leo-lizx/transport-truck/docs/hardware/吸盘模式4实物丝印接线标注.png

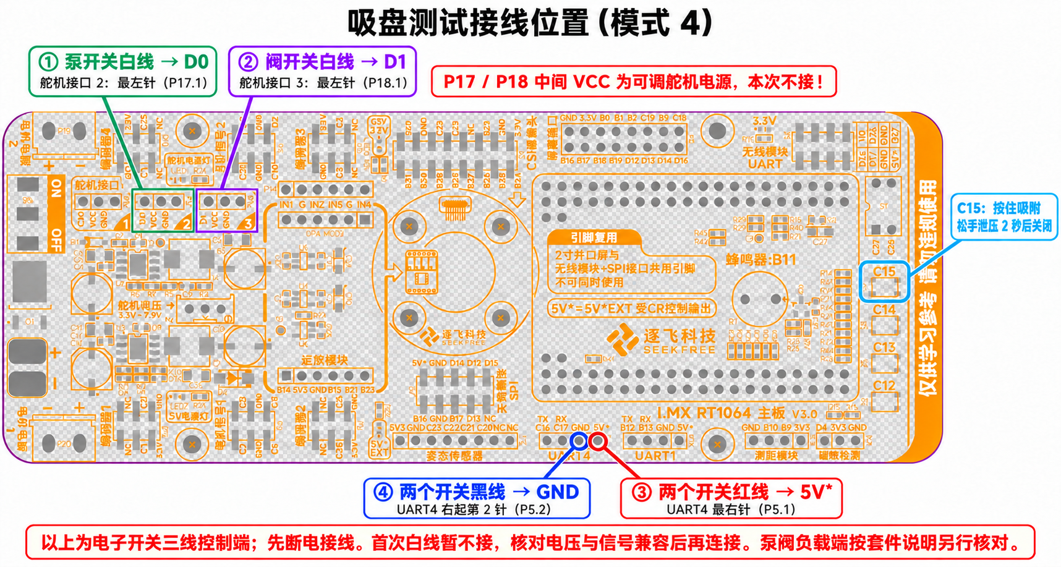
docs/hardware/吸盘模式4实物丝印接线标注.png
