leo-lizx/transport-truck/docs/PINOUT.md

# RT1064 V3.0 主板接口与引脚占用

> 更新：2026-10-17。适用工程：`transport-truck`，当前入口保留模式 1／2／3，新增并默认模式 4 吸盘测试。
>
> 用户确认实物为主板 V3.0；当前底盘的接线、参数和程序保持不变。
>
> 本文是资料与源码核对结果，未进行实物电压、接线或新增外设测试。

[查看彩色接口标注图（PDF）](hardware/RT1064_V3.0接口标注.pdf)

## 1. 标注依据与状态定义

| 来源 | 版本／位置 | 用途 |
| --- | --- | --- |
| H1：[V3.0 主板硬件说明](<../【文档】说明书 芯片手册等/主板文档/RT1064 V3.0主板硬件说明 V1.0.pdf>) | V1.0，2023-02-28；下文使用 PDF 页码，印刷页码通常少 1 | 主板接口、插接与电源说明 |
| H2：V3.0.1.2 原理图 | `E:\car\RT1064_Library-master\封装 文档 原理图.zip` 内 `【原理图】原理图 丝印图 尺寸图 位号图/主板/V3.0/RT1064主板V3.0.1.2 原理图.pdf`；2024-03-25，共 6 页 | 第 3 页引脚表、第 4 页连接器、第 5 页电源、第 6 页按键／拨码／蜂鸣器 |
| S1：[pinMap.h](../project/code/config/pinMap.h)、[configChassis.h](../project/code/config/configChassis.h) | 当前工程文件 | 电机、编码器和底盘参数 |
| S2：[main.c](../project/user/src/main.c)、[isr.c](../project/user/src/isr.c) | 当前初始化与中断路由 | 区分已经启用、仅保留宏和已有中断处理 |
| S3：当前工程 `libraries/zf_driver/`、`libraries/zf_device/`、`libraries/zf_common/` | GPIO／PWM／UART／IIC／SPI／ADC 枚举及 IMU、Debug 默认映射 | 核对复用资源与隐含占用 |

本文使用 V3.0 系列原理图；当前工程资料目录也已包含 V3.0，不以 V3.1 替代。用户确认实物丝印仅为 V3.0，不能由此确定是否恰为 V3.0.1.2 小修订；涉及供电范围时见第 7 节。

| 状态 | 本文含义 |
| --- | --- |
| 底盘占用／保留 | 当前四个模式都会初始化，禁止为新增外设改动；模式 4 保持 STOP |
| 模式 4 占用 | 仅吸盘独立测试初始化 D0／D1／C15，不再列为空闲候选 |
| 候选可用 | 当前软件未初始化，且未直接占用底盘引脚；仍须核对实物是否已接设备，以及电气／资源兼容性 |
| 条件复用 | 与其他接口共享引脚或外设，不能把每行都视为可同时使用 |
| 不可新增占用 | 与受保护底盘或存储器资源冲突 |
| 待确认 | 尚无足够资料决定器件接法、供电或控制参数 |

`pinMap.h` 是应用引脚映射入口，但不能单独代表全部硬件占用；还要核对实际初始化、SDK 默认引脚与主板原理图。

## 2. 底盘已占用：保持不变

即使选择单轮 PID 模式，`chassis_ctrl_init()` 也会初始化全部四轮、四路编码器和 IMU。以下共 **20 个信号引脚**，不包括核心板存储器、启动、SWD 和电源等板级占用。

| 功能 | 当前接线 | 外设资源／主板接口 |
| --- | --- | --- |
| 左前轮 LF | PWM C11；DIR C10 | PWM2 子模块 2 B；P9 |
| 右前轮 RF | PWM D3；DIR D2 | PWM2 子模块 3 B；P9 |
| 左后轮 LB | PWM C6；DIR C7 | PWM2 子模块 0 A；P8 |
| 右后轮 RB | PWM C8；DIR C9 | PWM2 子模块 1 A；P8 |
| LF 编码器 | A=C5；B=C25 | QTIMER2_ENCODER2；编码器 4／P10 |
| RF 编码器 | A=C3；B=C4 | QTIMER2_ENCODER1；编码器 3／P11 |
| LB 编码器 | A=C0；B=C1 | QTIMER1_ENCODER1；编码器 1／P13 |
| RB 编码器 | A=C2；B=C24 | QTIMER1_ENCODER2；编码器 2／P12 |
| IMU660RB | SCK C23；MOSI C22；MISO C21；CS C20 | SPI4；姿态传感接口 P3 |

四路电机 PWM 当前为 **17 kHz**。PIT_CH0 为 5 ms 姿态与主循环节拍，PIT_CH1 为 20 ms 底盘闭环；RTWDOG 保留。它们不属于本次新增外设的资源池。

供接线复核的 H2 第 4 页针号：

| 连接器 | 针号 → 网络 |
| --- | --- |
| P8 电机信号 1 | 1=C8；2=C6；3、4=GND；5=C9；6=C7 |
| P9 电机信号 2 | 1=D2；2=C10；3、4=GND；5=D3；6=C11 |
| P13 编码器 1 | 1=GND；2=3V3；3=C0；4=C1；5、6=NC |
| P12 编码器 2 | 1=GND；2=3V3；3=C2；4=C24；5、6=NC |
| P11 编码器 3 | 1=GND；2=3V3；3=C3；4=C4；5、6=NC |
| P10 编码器 4 | 1=GND；2=3V3；3=C5；4=C25；5、6=NC |
| P3 姿态模块 | 1=3V3；2=GND；3=C23；4=C22；5=C21；6=C20；7、8=NC |

这些是原理图针号，不能把绘图中的左右方向直接当成实物插头方向，也不据此调整现有已经使用的底盘线序。

### 2.1 模式 4 新增占用

| 功能 | 信号／针脚 | 边界 |
| --- | --- | --- |
| 泵电子开关 | D0／P17.1，PWM1 子模块 3 A | 与 D1 同频，统一初始化 |
| 阀电子开关 | D1／P18.1，PWM1 子模块 3 B | 同频但可独立发送开关命令 |
| 按住吸附／松手释放 | C15，板载 K1 | 输入上拉，低有效；上电先稳定松手解锁 |
| 电子开关红／黑线 | P5.1=5V_EXT／P5.2=GND | 先测电压及核对负载能力；P5.3／4 的 UART 信号未启用 |

**P17.2／P18.2 为可调舵机电源，不接本次开关红线。** 详细供电边界、信号兼容性和测试次序见 [吸盘模式 4 接线与测试](吸盘模式4接线与测试.md)。模式 4 不改上述 20 个底盘信号及原有 PIT 节拍。

## 3. 主板接口：当前可选范围

下表区分模式 4 已用与尚未初始化的接口。绿色候选接口之间仍可能复用同一组引脚；设备未插接情况须由实物核对。

| 主板接口 | 连接器／信号 | 当前状态与使用边界 |
| --- | --- | --- |
| 舵机 1 | P16：C30 | 模式 5/6 使用；PWM4 子模块 2 A，50Hz，官方公式 0.5–2.5ms（与 FS5323M 500–2500µs 量程一致） |
| 舵机 2 | P17：D0 | 模式 4 用于泵开关；PWM1 子模块 3 A，与 D1 同频；本测试不能同时改作 UART4 TX |
| 舵机 3 | P18：D1 | 模式 4 用于阀开关；PWM1 子模块 3 B，与 D0 同频；本测试不能同时改作 UART4 RX |
| UART4 | P5：TX=C16，RX=C17 | 信号尚未初始化，可作候选；模式 4 仅使用 P5 的电源／地针；保留旧地图 ISR，启用新协议前须处理旧路由 |
| UART1 | P15：TX=B12，RX=B13 | 候选可用；保留旧分类接收 ISR；与 IIC4 复用 |
| 串口无线模块 | P1：TX=D16，RX=D17，RTS=D26，CMD=D27 | 候选可用；当前 Debug UART8 关闭；D16／D17 也可作 PWM1 子模块 2 |
| SPI 无线模块 | P7：SCK=D12，CS=D13，MOSI=D14，MISO=D15，RST=B16，INT=B17 | 候选可用；与 PWM1 子模块 0／1、IIC1／3 及屏幕并口等复用 |
| CSI 摄像头 | P2：PCLK=B20，VSY=B22，D0–D7=B31→B24，配置 TX=C28／RX=C29 | 候选可用；主控直接采图时需同时预留数据与配置引脚，不能只接两根 UART 线 |
| 运放／模拟采集 | OPA_MOD1 输出接 B14／B15／B21／B23 | 候选可用；对应 ADC；只有安装并适配模拟前端后才能按功能使用 |
| 超声波 | P4：Trig=B9，Echo=B10 | 条件可用；B9 不能作为独立低频 PWM，B10 与 PWM1 子模块 3 A 复用 |
| 磁铁检测 | P21：D4 | 候选可用；主板有上拉及串联电阻，不是完全悬空的裸 GPIO |
| 屏幕 | P6：SPI 使用 B0／B1／B2／B3／C18／C19 | 条件可用；旧菜单已删除，未初始化；不能把其中 PWM2 复用脚改成低频控制 |
| 屏幕 8 位并口扩展 | P6：B16–B19、D12–D15 | 条件可用；与 SPI 无线、PWM、IIC、ADC 等复用，不与前述功能同时独立使用 |
| 按键 K1–K4 | C15／C14／C13／C12 | C15 在模式 4 控制吸盘；C14／C13／C12 未初始化。均已连接按键，不是无连接 GPIO |
| 拨码开关 | C27／C26 | 硬件已连接开关，当前未初始化 |
| 蜂鸣器 | B11 | 硬件已连接驱动电路，当前未初始化；不当作自由 PWM 输出 |

### 3.1 常用候选接头的针号

依据 H2 第 4 页；电源针与信号针要分开理解。

| 接头 | 1 脚 | 2 脚 | 3 脚 | 4 脚 |
| --- | --- | --- | --- | --- |
| P16 舵机 1 | C30 信号 | VCC_Servo | GND | — |
| P17 舵机 2 | D0 信号 | VCC_Servo | GND | — |
| P18 舵机 3 | D1 信号 | VCC_Servo | GND | — |
| P5 UART4 | VCC_5V_EXT | GND | C17／MCU RX | C16／MCU TX |
| P15 UART1 | VCC_5V_EXT | GND | B13／MCU RX | B12／MCU TX |
| P4 超声波 | 3V3 | B9／Trig | B10／Echo | GND |
| P21 磁铁检测 | D4 | 3V3 | GND | — |

三个舵机口共用 `VCC_Servo` 电源，各信号串联 100 Ω 电阻。调节该电源会同时影响三个接口，不是每口单独调压。UART 的 5 V 电源针不表示 TX／RX 信号可接 5 V；外设 TX 接 MCU RX，外设 RX 接 MCU TX。

## 4. PWM 资源约束

依据当前 `zf_driver_pwm.h` 第 45–47 行及 `pwm_init()` 实现：同一子模块 A／B 只能同频；同一通道的多个引脚是复用选项，并非多个独立输出。初始化共享子模块还可能重设已有输出，不能只看引脚名不同。

| PWM 资源 | 当前／候选引脚 | 结论 |
| --- | --- | --- |
| PWM2 子模块 0–3 | 底盘四路 PWM | 全部保留；不得用于新增低频控制 |
| PWM2 子模块 3 A | B0／C18／D2／B9 | D2 已作 RF 方向；其余脚即使未初始化，也不能视为独立低频 PWM |
| PWM2 子模块 3 B | B1／C19／D3 | 与 RF 电机 D3 是同一 PWM 通道，禁止重新分配 |
| PWM1 子模块 0 | A=D12；B=D13 | 软件候选；与 SPI1／IIC3 复用，两路同频 |
| PWM1 子模块 1 | A=D14；B=D15 | 软件候选；与 SPI1 复用，两路同频 |
| PWM1 子模块 2 | A=D16；B=D17 | 软件候选；与 UART8 复用，两路同频 |
| PWM1 子模块 3 | A=B10／C16／D0；B=B11／C17／D1 | 模式 4 使用 D0／D1，名义 50Hz；不能另从别名引脚分配独立 PWM；B11 已接蜂鸣器电路 |
| PWM4 子模块 0／1 | B24／B25 | 软件候选；占用时会影响 CSI 摄像头数据引脚 |
| PWM4 子模块 2 | C30 | 对应主板舵机 1，独立于电机 PWM2 |
| PWM4 子模块 3 | C31 | SDK 候选，主板三个标准舵机口没有此脚；需另核对可接出的物理位置 |
| PWM3 | SDK 注明被 SDRAM 占用 | 不列入新增资源池 |

因此“三个舵机插座”不代表三个独立 PWM 频率域：C30 独立，D0 与 D1 共用一个频率域。UART4 使用 C16／C17、PWM 使用 D0／D1 时，属于不同引脚和不同外设，可作为并行候选；不能把 C16 与 D0 或 C17 与 D1 当成独立 PWM 通道，也不能让同一个引脚同时承担 UART 和 PWM。

泵阀开关模式 4 采用名义 50Hz、关约 544μs／开约 2400μs，还原吸盘 PDF 的 Arduino `Servo.write(0/180)` 默认示例；它们是初始测试参数，尚未实测开关门限。BDS300 仍未分配控制参数，不沿用该开关波形。

## 5. 其他软件复用候选

以下表示当前 SDK 支持的候选，不保证主板有同名专用插座，也不意味着可同时使用。

| 外设 | 引脚候选 | 约束 |
| --- | --- | --- |
| UART2 | TX B18／RX B19 | 与 ADC／屏幕并口复用 |
| UART3 | TX B22／RX B23 | 与 CSI／运放 ADC／IIC3 复用；另一组选项 C8／C9 已属底盘，排除 |
| UART4 另一组 | TX D0／RX D1 | 模式 4 已用于泵阀 PWM，不能同时启用该组选项；不构成第二个独立 UART4 |
| UART5 | TX C28／RX C29 | CSI 摄像头配置口；复用前须核对视觉方案和已有回调 |
| UART6 | TX B2／RX B3 | 与屏幕 SPI3 复用 |
| UART8 另一组 | TX B26／RX B27 | 与 CSI 数据等复用，不构成第二个独立 UART8 |
| IIC1 | SCL B16 或 D4；SDA B17 | 与 SPI 无线 RST／INT、磁铁接口等复用 |
| IIC3 | SCL B23 或 D12；SDA B22 或 D13 | 与 UART3、CSI、ADC、SPI1、PWM1 复用 |
| IIC4 | SCL B12；SDA B13 | 与 UART1 共用引脚 |
| SPI1 | SCK D12，MOSI D14，MISO D15，CS 可选 D13／D26／D27 | 与 PWM1、串口无线控制脚等复用 |
| SPI3 | SCK B0 或 B31；MOSI B1 或 B30；MISO B2 或 B29；CS B3 或 B28 | 与屏幕、UART6、CSI 等复用；作为 SPI 用不等于占用 PWM2，但不可同时复用 |
| ADC | ADC1 提供 B12–B27；ADC2 提供 B16–B31 的枚举通道 | 每脚仍须核对板上连接及输入电压；板载运放输出只对应第 3 节四路 |

IIC2 的 C4／C5 与编码器冲突；FLEXIO 摄像头推荐接法大量占用 C5–C15，与底盘冲突，排除这两类新增占用。SPI4 已用于 IMU，不作为独立空闲总线；另选 C3／C2／C1 也撞编码器。若将来要共享现有 SPI4，须另行审核片选、时序、频率和驱动访问，本次不更改。UART7 在当前 SDK 没有可用引脚枚举。

### 5.1 GPIO 名称与已有硬件连接

当前 `zf_driver_gpio.h` 提供的丝印名称范围是：

- B0–B3、B9–B31；
- C0–C31；
- D0–D4、D12–D17、D26–D27。

这些只是支持范围，须先扣除底盘及所选外设，再核对板载电路。旧表中的 A0–A29、B4–B8、D5–D11 不能作为本 SDK 的现成空闲引脚。

C4–C15 涉及启动配置脚，库资料有上电时序提醒；现有底盘保持不变，不为新增接口擅自烧 Fuse 或修改启动配置。SWD、存储器及其他未列出的核心板专用信号不作为普通空闲接口。

## 6. 当前串口中断路由

“当前没有初始化”不等于“打开接收中断即可用于新协议”。

| 串口 | 当前 `isr.c` 情况 | 后续接入要求 |
| --- | --- | --- |
| UART1 | 字节送入旧分类协议 `app_link_isr_feed_class_byte()` | 新协议任务中明确接收归属，不能直接沿用旧解析 |
| UART4 | 字节送入旧地图协议 `app_link_isr_feed_map_byte()` | 同上；旧 `pinMap.h` 宏保留不等于当前正在启用 |
| UART5 | 调用摄像头接收回调 | 按所选摄像头或新协议核对回调 |
| UART2／3／6 | RX 分支未实现读取字节 | 不直接打开 RX 中断，须在对应任务实现接收 |
| UART8 | 当前应用无自定义接收入口；Debug 关闭 | 复用或恢复 Debug 时核对中断与引脚 |

本次不改这些 ISR，也不删除 `app_link`；底盘仍使用其地图快照接口。

## 7. 供电标注与版本差异

| 项目 | H1：2023 年 V3.0 手册 | H2：V3.0.1.2 原理图 | 当前处理 |
| --- | --- | --- | --- |
| 电池输入范围 | 6–12 V（PDF 第 4／7 页） | 框图标 7–14 V（第 2 页） | 不拼接成 6–14 V；核对实物小版本与额定条件 |
| 舵机电源可调范围 | 最低 3.3 V、最高同电池电压（PDF 第 11 页） | 3.3–7.9 V（第 2／5 页） | 实际输出及负载能力待核对，不能直接决定 FS5323M 供电；堵转 1.5A 需实测压降 |
| 出厂舵机电压 | 约 5.5–6.5 V（PDF 第 11 页） | 无法由电路图获知当前电位器位置 | 使用前测量实际输出，不把出厂描述当实测 |
| 电机电源端子 | 输出随电池及电源开关 | P19／P20：1=VCCBAT，2=GND | 保持当前底盘供电接法 |
| USB 供电 | 核心板 USB 可提供逻辑供电，但不能给电机驱动及舵机供电（PDF 第 4 页） | — | 不把 USB 供电成功视作执行器供电就绪 |
| UART1／4 与无线模块供电 | 外设电源随板级时序 | VCC_5V_EXT 经电子开关受 CR 控制 | 电源针与信号电平分开核对 |

H2 还区分普通 3V3 和 CSI_3V3。资料未给出足以承诺新增舵机、泵、阀总负载的接口电流预算；不凭稳压芯片或电感标称值推定整板可带载能力。

## 8. 新增模块的标注边界

| 新模块 | 目前可以确认的接口方向 | 尚不能确定 |
| --- | --- | --- |
| FeETech FS5323M 数字舵机 | 模式 5/6 使用 P16/C30（PWM4 子模块 2 A，50Hz，官方公式 0.5–2.5ms）；厂家参数：4.8–6V、500–2500µs、中位 1500µs、180°(±5°)、堵转 21.5kg·cm / 1.5A@6V、空载 0.16s/60°、25T 输出轴 | 最大 PWM 刷新率未给出（暂用 50Hz）；堵转 1.5A 对 VCC_Servo 供电能力的要求待实测；指令角度不代表机械实际角度 |
| 泵／阀电子开关 | 模式 4 分别使用 D0／D1，统一 50Hz 名义示例波形；C15 控制，松手泄压 2 秒 | 3.3V 输入兼容、开关实际门限、负载供电与容量仍需核对；不把红线 5V 当作阀额定电压 |
| 上下运动部件 | 可根据后续执行器选择控制、驱动和限位接口 | 当前不能预设为舵机、推杆、丝杆或步进电机 |
| 升降步进（模式 9） | D12 脉冲（P7 SCK）、D13 方向（P7 CS）、D4 限位输入（P21.1，按下接地）；GPT1 中断产生脉冲 | 占用后 P7 SPI 无线不可用；IAR 编译通过，未实测波形 |
| 摄像头 | 裸相机直采可审查 CSI；外置视觉模块可审查 UART 等结果通信接口 | 相机型号、运行平台与协议未定，不能把两种路线当作已选配置 |

模式 4 的软件与接线说明已完成，新增吸盘驱动、C15 应用和构建文件登记；底盘代码、参数、20 个信号与 ISR 保持不变。模式 1／2／3／4 已通过 IAR 编译链接，吸盘应用主机行为测试通过；2026-10-19 补齐 MDK 底盘源文件登记并完成完整构建，同日已把相关改动提交到本地分支（未推送）。仍未执行通电、波形实测与烧录，下一步按独立测试说明逐项验证实际开关和气路。
