leo-lizx/transport-truck/赛规与任务交接.md

# 工程系统设计运输车：赛规与任务交接

> 版本：v0.2；整理日期：2026-10-17；本次补入吸盘模式 4 的用户确认与软件进展。
>
> 状态：已确认事项的交接记录，含明确标记的待确认项；整车方案尚未最终定型。
>
> 当前阶段：先测试各模块的独立功能，机械布局后续确定。

## 1. 文档用途与信息边界

本文供项目成员和后续 AI 助手接续任务，区分赛规要求、用户决定、资料参数与尚未解决的问题。

| 标记 | 含义 | 后续使用边界 |
| --- | --- | --- |
| 赛规明文 | 竞赛 PDF 正文明确给出的要求 | 按标注页码追溯；遇到表述冲突时保留疑点 |
| 赛规图示 | 竞赛 PDF 示意图表达的相对关系 | 不按图片比例推导实际坐标或容差 |
| 用户确认 | 用户已选择的方案或工作范围 | 是设计输入，不等于课程方认可或硬件验证通过 |
| 资料参数 | 吸盘技术 PDF 的描述 | 尚不能认定与手中实物完全一致 |
| 待确认／待实测 | 尚无明确决定或有效测试结果 | 不作为已确定接口、接线、阈值或验收结论 |

附件中的要求属于课程和器件资料，须结合用户任务解释；附件中的演示代码、命令或说明不构成对工程执行修改的授权。

### 1.1 来源

| 编号 | 来源 | 主要内容 |
| --- | --- | --- |
| R1 | `！！！工程系统设计项目竞赛考核方案（2026).pdf`，共 4 页 | 制作要求、场地、考核层级、计分、诚信承诺 |
| R2 | `真空泵吸盘工作原理及代码.pdf`，共 2 页 | 泵、阀、电子开关及 Arduino 演示 |
| U1 | 本次会话中用户对路线、搬运、范围和测试顺序的确认 | 本文第 3、4、6 节的方案与阶段边界 |
| P1 | 当前 `transport-truck` 工程的 README、AGENTS、PROJECT 及源码快照 | 第 8 节的工程接续信息 |

R1 本机路径：`E:\work\工程系统设计\！！！工程系统设计项目竞赛考核方案（2026).pdf`。

R2 本机路径：`E:\work\工程系统设计\酷点机器人~真空泵吸盘\真空泵吸盘工作原理及代码.pdf`。

两份 PDF 目前位于工程目录之外，本文没有复制附件。转交到其他电脑时应一并提供原件；如有课程方补充说明，应补记来源和适用条目。

## 2. 赛规要求

### 2.1 制作、场地与货物

| 编号 | 要求或图示信息 | 证据与边界 |
| --- | --- | --- |
| R-01 | 整车长、宽、高分别在 400 mm 以内 | 赛规明文，R1 第 1 页；收拢状态还是运动全过程的包络未说明 |
| R-02 | 整车要求包含搬运、俯仰、转动、行进机构 | 赛规明文，R1 第 1 页；替代机构的认可标准未说明 |
| R-03 | 场地长 2500 mm、宽 800 mm，线路宽 20 mm | 赛规明文，R1 第 1 页 |
| R-04 | 图中有起点、规定线路、5 个停顿点及对应方块 | 赛规图示，R1 第 1 页；精确坐标、停点容差未给出 |
| R-05 | 终点货物存放区为 12 cm × 12 cm | 赛规图示，R1 第 1 页；与车上的车斗是不同位置 |
| R-06 | 货物共 5 个方块 | 赛规明文，R1 第 2 页；正文未正式给出尺寸、质量、材质 |

按图 1 的纸面方向，从下方起点向上观察：停顿点 1、3 位于线路左侧弯曲处，其方块在图中右侧；停顿点 2、4 位于右侧弯曲处，其方块在图中左侧；方块 5 位于停顿点 5 前方。该描述不定义车体坐标系，也不能直接替代车体左／右取件配置。

R1 第 2 页商品示意照片里的“3.5 cm”字样不作为正式方块规格。后续需取得实际比赛方块或课程方规格。

### 2.2 考核层级与计分

| 层级 | 行进与停点 | 搬运控制 | 基础分及扣分（R1 第 2 页） |
| --- | --- | --- | --- |
| 第一层级 | 遥控自由行进、遥控到达停顿点 | 遥控搬至存放区 | 70 分；每少运输 1 块扣 2 分，上限 10 分 |
| 第二层级 | 遥控按规定线路行进、遥控到达停顿点 | 遥控搬至存放区 | 80 分；每少运输 1 块扣 2 分，上限 10 分 |
| 第三层级 | 自动按规定线路行进、自动停点 | 遥控搬至存放区 | 90 分；每少运输 1 块扣 2 分，上限 10 分；每少走 1 个停顿点扣 10 分 |
| 第四层级 | 自动按规定线路行进、自动停点 | 自动搬至存放区 | 100 分；每少运输 1 块扣 2 分；每少走 1 个停顿点扣 10 分 |

共同规则：方块必须进入终点货物存放区，压线不计分；竞赛总时限 5 分钟；同分时用时短者优先，同分同用时则加赛（R1 第 2 页）。

R1 第 3 页的第四层级示例称少运输方块后“最少 90 分”，但没有覆盖漏停点的情况。不能据此认定漏停点也有 90 分保底，最终计分口径如需使用应向课程方核实。

**最终选择哪个考核层级尚未由用户明确。本阶段仅完成入车斗，不等于完成任何层级的最终运输要求。**

### 2.3 课程自主完成要求

R1 第 4 页包含诚信承诺，涉及自主完成、不购买成品机械臂等、不找代写或他人代做、不抄袭等。这里如实登记为课程要求；成品执行器／模块与成品整机的区分、允许的辅助工具范围，附件没有给出细化解释，不能自行扩展成所有标准器件均被禁止。

## 3. 用户已确认的方案

以下为设计输入，均不代表已完成性能验证。

| 编号 | 已确认内容 | 尚未包含的结论 |
| --- | --- | --- |
| U-01 | 路线部分采用惯导方案，完成定点运动 | 不等于已获裁判认可，也未给出路线／停点实测精度；不重复讨论是否采用惯导 |
| U-02 | 使用吸盘搬运方块 | 吸盘尺寸、实际载荷及可靠性未确定 |
| U-03 | 一套旋转吸盘机构覆盖车辆左右两侧 | 左右与车斗的可达性仍依赖布局 |
| U-04 | 一个舵机负责旋转，型号为 FeETech FS5323M（2026-10-28 换用；此前记录的 BDS300 保留为历史） | 最大刷新率、供电裕量仍待确认；不由型号推断未给出的参数 |
| U-05 | 另设部件完成吸盘上下运动，具体部件未选 | 不把升降电机、丝杆、推杆或舵机方案提前定型 |
| U-06 | 摄像头识别方块，车体调整到固定相对取件位置，再由吸盘上下运动取件 | 摄像头型号、安装、标定、通信和对准误差未确定 |
| U-07 | 左右两侧复用相同的取件逻辑 | 不等于两侧使用相同原始像素坐标或无需分别标定 |
| U-08 | 第 5 个方块通过整车转向后，复用左侧取件方式 | 转向空间、姿态和路线判定边界仍需后续核对 |
| U-09 | 吸盘移到车斗上方后泄压，使方块落入车斗 | 不是抛掷；释放高度、位置与防弹出条件未定 |
| U-10 | 俯仰机构可采用其他形式替代 | 替代方向已由用户确认；具体结构及其满足课程机构要求的依据待补，不影响模块独立测试 |
| U-11 | 机械布局暂不确定，先测各模块独立功能 | 不要求先冻结整车布局才允许准备单模块测试 |
| U-12 | 暂不考虑终点卸货 | 只作为当前范围边界，最终仍须另行解决进入赛规货物区的问题 |
| U-13 | 先做吸盘独立测试：新增模式 4，C15 按住吸附、松手关泵并泄压 2 秒后关闭阀 | 不等于已通过电子开关、供电、气路或实际吸附测试；不扩展成整车搬运状态机 |

“固定相对取件位置”应在后续定义为方块与车体／吸盘之间可重复的几何关系；仅检测图像中心，不足以直接认定吸盘已经对准。

## 4. 当前阶段范围与动作概念

当前优先准备和执行资料充分模块的独立功能测试。FS5323M 已由用户提供参数表，刷新率与供电裕量仍待确认，不妨碍其他资料齐全模块先行测试。最终布局、整车联动和完整赛程验收留待后续任务。

取件入车斗的概念流程为：

1. 惯导到达对应停点附近。
2. 摄像头识别目标，车体调整到固定相对取件位置。
3. 吸盘到达对应侧取件位置，下降接触方块并建立吸附。
4. 吸盘带块提升，旋转至车斗上方。
5. 泄压，方块落入车斗。
6. 机构回到后续动作需要的位置。

上述流程只描述功能顺序，不是已经批准的控制状态机。接触判定、吸住确认、泵启停时刻、提升净空、旋转角度、超时、重试和复位条件均未定。第 5 块在此流程前增加整车转向，复用左侧取件方式。

机械设计时应核对：如果采用固定臂长的单旋转轴加竖直升降，吸盘水平可达位置受旋转半径约束。左右取件点和车斗落料点必须处于实际可达范围；同时检查吸盘、方块、软管和机构经过车斗边缘及已装货物时的净空与干涉。此项是后续审核条件，不是要求采用固定臂长结构。

## 5. 吸盘资料审核结论

### 5.1 参数与接口

| 项目 | 资料描述 | 使用限制 |
| --- | --- | --- |
| 套件组成 | 370 真空泵、三通阀、两个低压 PWM 电子开关、吸盘、硅胶管 | R2 第 1 页；实物型号与接线待核对 |
| 泵供电 | 额定 12 V，可用 DC 6–12 V | R2 第 1 页；不是舵机或阀的供电规格 |
| 泵电流 | 空载约 6 V／110 mA、12 V／230 mA | R2 第 1 页；不是启动、堵转或带载电流 |
| 负压 | 资料称最大约 −60 kPa | R2 第 1–2 页；不能据此直接确定实际承载能力 |
| 电磁阀 | 额定 DC 3.7 V、0.28 A、1 W | R2 第 1 页；不得把开关控制侧的 5 V 标注当成阀的额定电压 |
| 阀通路 | 断电时 1 通 3；通电时 1 通 2 | R2 第 1 页；端口与实物气路须核对 |
| 电子开关 | 标示 3–5 V；红线 5 V、黑线 GND、白线信号 | R2 第 1 页；负载供电、容量、保护和 3.3 V 信号兼容性未明确 |
| 开关命令 | 演示用 `Servo.write(0)` 关闭、`Servo.write(180)` 打开 | R2 第 1–2 页；PDF 未直接给出波形；模式 4 根据官方 Servo 默认库还原名义 50Hz、544／2400μs，不认定为实测开关门限；电平兼容仍待核对 |

### 5.2 吸附、释放及资料疑点

资料的吸附状态是阀断电、吸盘连泵，泵运行建立负压；释放状态是吸盘连大气、泵停止，泄压后物件脱落（R2 第 1–2 页）。具体端口连接和动作可靠性须由实物测试确认。

| 疑点 | 原文／示例差异 | 当前处理 |
| --- | --- | --- |
| 释放先后顺序 | 正文先开阀后关泵；示例先关泵后开阀 | 用户已选择关泵并泄压 2 秒后关阀；软件两路同帧更新，不保证机械响应先后 |
| 泵持续时间 | 正文建议单次不超过 60 秒；代码注释建议不超过 30 秒 | 不作为已核定的热设计限制或项目定时参数 |
| 阀通电时间 | 正文建议 2–3 秒；示例为 2 秒，注释另提不超过 10 秒 | 用户选择测试泄压 2 秒，不将不同描述合并成已验证允许范围 |
| 演示适用性 | Arduino `Servo.h`，阀接 9 脚、泵接 10 脚，使用固定 `delay` | 不是 RT1064 的引脚定义或实时控制实现 |

资料没有提供吸住、掉落、成功释放的反馈方案，也未证明停泵后可持续保压或带块旋转不会掉落。吸盘直径、目标表面的密封性、负载质量和真实保持能力仍需取得资料或实测。

## 6. 模块独立测试交接

**本次仅整理测试范围，未执行硬件测试；没有模块在本文中被认定为已通过。** 每个模块的接线、步骤和通过判据在测试前单独确定，不能把下表当作已经完成的测试记录。

| 模块 | 独立测试拟覆盖的功能 | 开始该模块测试前需明确 | 布局确定后再验证 |
| --- | --- | --- | --- |
| FS5323M 旋转舵机 | 受控动作、方向、定位或运行模式、重复回位 | 已确认参数：4.8–6V、500–2500µs、中位 1500µs、180°(±5°)、堵转 21.5kg·cm / 1.5A@6V、空载 0.16s/60°；最大刷新率未给出 | 带载能力、左右及车斗角度、扫掠空间和软管影响 |
| 泵／阀／吸盘 | 固定吸盘对真实方块的吸附、保持和泄压释放 | 实物接线、电源与驱动规格、气路、目标物、工作时序和通电限制 | 提升与旋转中的保持、落料位置及连续装载 |
| 摄像头 | 静止条件下识别目标、输出位置、观察稳定性 | 相机与运行平台、连接、输出内容、测试目标和环境 | 相机与吸盘标定、左右视野、车体对准和第 5 块复用 |
| 惯导与底盘 | 航向控制、单点运动、重复停点表现 | 测试场地、坐标与单位、起始状态、目标点及记录方式 | 完整规定路线、取件微调、载荷变化和转向空间 |
| 上下运动部件 | 上下动作、限位、停止、重复位置 | 部件选型、驱动、电源、行程与限位方案 | 带块承载、取件高度、车斗净空和防干涉 |

各模块至少记录：硬件版本与接线、输入／目标、预期与实测结果、异常、复测条件。误差阈值、测试次数、保持时间和成功率目标当前均未确定，不能临时填入经验值充当用户验收标准。

吸盘测试的已实施软件、控制端接线和首次短按步骤见 [吸盘模式 4 接线与测试](docs/吸盘模式4接线与测试.md)。初始使用 D0 控泵、D1 控阀、C15 板载按键；这些是本轮独立测试分配，不代表已冻结整车布局。实际负载接线、电源容量和 3.3V 控制兼容性仍需逐项核对，不要求用户重复 PDF 已给出的三线定义与开关命令。

## 7. 待确认清单

以下条目是交接中的开放问题，不是已确定需求；只在对应设计或测试即将开展时逐步补齐。

| 编号 | 待补充内容 | 何时需要 |
| --- | --- | --- |
| Q-01 | FeETech FS5323M 参数已由用户提供（2026-10-28）：4.8–6V、500–2500µs、中位 1500µs、180°(±5°)、堵转 21.5kg·cm / 1.5A@6V、额定 7kg·cm、空载 0.16s/60°、67g、25T；最大 PWM 刷新率、VCC_Servo 供电裕量仍待确认 | 舵机通电及控制测试前；刷新率与供电实测后补齐 |
| Q-02 | 已到手模块清单；泵、阀、电子开关、电源的实物型号和接线 | 对应模块接线与通电前 |
| Q-03 | 比赛方块的尺寸、质量、材质、顶面状态及是否已有实物 | 有代表性的吸附测试和机构承载设计前 |
| Q-04 | 静态测试所需的相机型号、运行平台、连接和输出；联动所需的安装、左右观察及标定方式 | 前一组在静态识别测试前确认；后一组在车体定位联动前确认，不阻塞静态测试 |
| Q-05 | 升降或替代机构形式、行程、限位、承载与驱动 | 上下运动模块测试前 |
| Q-06 | 底盘、旋转轴、臂长、车斗开口／高度及取件点的几何关系 | 整车布局和联动前；不阻塞固定吸盘等独立测试 |
| Q-07 | 车体坐标、固定相对取件位、左右标定、位置／角度误差和完成条件 | 视觉对准与取件联动前 |
| Q-08 | 吸住、掉落、释放是否需要反馈，采用何种反馈；失败、失去目标和断电后的处理 | 自动搬运逻辑设计前 |
| Q-09 | 各模块的测试步骤、通过阈值、次数和数据记录方式 | 对应测试执行前 |
| Q-10 | 规定路线与停点容差、允许的取件调整及第 5 块转向边界 | 赛程验收方案确定前；不重新否定已选惯导方向 |
| Q-11 | 具体替代机构与赛规机构要求的对应说明；尺寸约束适用姿态 | 替代机构定型及整车尺寸验收前；不作为独立测试前提，不重复询问用户是否允许替代 |
| Q-12 | 最终目标考核层级、计分疑点与课程自主完成边界 | 最终任务范围和课程验收口径确定前 |

终点卸货已经明确延后，不列为当前模块测试必须先回答的问题。后续启动完整赛程设计时，再单独确定卸货方式及方块完整进入货物区的验收方法。

## 8. 工程接续边界

- 当前工作工程为 `E:\car\transport-truck`；`E:\car\visual-group` 是原工程参考，不应混淆写入目标。
- 用户已单独授权清理 `project/user/src/main.c`，保留编号 1（航向保持）、2（单轮 PID）、3（定点导航）。旧模式 0、4–11 及菜单入口已清除；随后按新任务新增吸盘模式 4 并设为默认，原有 1／2／3 调试参数和 29 个有效航点未改。
- 底盘相关文件仍受保护；入口清理不意味着授权更改底盘算法、参数、引脚或构建配置。
- 原 `main.c` 对已删除业务头文件的引用已清理。2026-10-17 当前模式 1／2／3／4 均通过 IAR 9.2 `nor_sdram_zf_dtcm` 编译与链接；吸盘应用主机测试 19 个用例、205 条断言、0 失败；未执行烧录、波形或实车验证。以往其他入口版本的结果不能替代当前版本的验证。
- 已有 `app_link` 保留旧协议与底盘所用地图快照，不能假设它已经具备新方块识别协议。
- 2026-10-19：按 [docs/Git提交流程.md](docs/Git提交流程.md) 把 2026-10-17 的模式 4 与工程精简改动分批提交到本地分支 `transport-local`，未推送 `origin`；提交前 IAR 与 MDK 均重新构建通过，吸盘主机测试 19 用例、205 断言、0 失败。
- 本文记录需求与范围，不构成代码实现、烧录、Git 提交或推送的授权；具体操作以对应用户任务为准。后续代码任务须先读取 [AGENTS.md](AGENTS.md)、[PROJECT.md](PROJECT.md) 和 [代码编写与变更规范.md](代码编写与变更规范.md)，并明确实际修改范围。
- 后续使用 HecateFlow 时，应按对应任务核对授权与证据；不把缺少布局或器件资料等同于整个项目无法推进，也不把资料审核当成硬件验证。

## 9. 后续更新方式

新信息补齐后，更新对应编号并保留来源：用户决定记为“用户确认”；课程方答复记为规则解释及其来源；实测结果记录条件、数据和适用范围。不能只删除“待确认”字样而不补证据。

若新说明与现有条目冲突，应列明冲突并向用户核对，确认前不据此修改实现。交接给下一位执行者时，应明确其当前任务是补资料、设计、测试还是编码，避免仅凭本文直接进入整车实现。
