leo-lizx/transport-truck/底盘运动控制角度环与位置环评审及最优方案.md

# 底盘运动控制、角度环与位置环评审及最优方案

> 评审日期：2026-07-12
> 评审对象：当前工作区中的 RT1064 四麦克纳姆轮底盘固件
> 评审性质：源代码静态评审与控制方案设计；未包含本轮实车辨识数据

## 1. 结论

当前方案具备完整的“传感器—位姿—位置/航向外环—轮速环—电机”闭环，麦轮正逆运动学、四轮等比例限速、位姿快照和视觉到站校准等基础设计值得保留；但**当前实现不是本项目约束下的最优方案，也不建议直接以现有参数进入最终实车竞赛验证**。

主要原因不是“PID 不够高级”，而是控制链中同时叠加了位置积分、简化 MPC、速度斜坡、静摩擦补偿、额外平移 PWM 前馈和额外旋转 PWM 前馈，多层逻辑的物理职责不清，并存在以下会直接影响结果的高优先级问题：

1. 到达判定只检查位置距离，不检查平移速度、航向误差、角速度和持续时间；到位后的退出回差却设为 `0.30 m`，超过一个 `0.20 m` 网格。
2. X/Y 顺序导航的 X 轴回切逻辑会在同一控制拍内再次锁回 Y 轴，注释描述的“重新驱动 X”实际上不能生效。
3. IMU 静止检测仅依据角速度方差；匀速旋转同样可能具有低方差，从而被误判为静止并被 ZUPT 当作零偏吸收。
4. 当前 MPC 只建模“剩余距离—未来速度”，没有当前速度、加速度和执行器动态；位置 MPC 路径还直接忽略实测轴速度阻尼。
5. 轮速增量 PID 在自身限幅后又叠加多种前馈并再次限幅，没有针对最终执行器饱和的跟踪反积分；电机换向也没有零占空比过渡拍。
6. 参数与注释存在明显冲突，例如注释说明最大平移速度已因过流降到 `0.70 m/s`，实际宏却是 `1.80 m/s`；角度“在位”允许的角速度为 `25°/s`，不能代表机械上已经停稳。

本项目推荐的工程最优解是：**保留麦轮运动学、编码器里程计、IMU 航向估计和事件式视觉 Snap；停用当前简化 MPC；采用“轨迹生成 + 位置反馈 → 航向角外环/角速度内环 → 四轮速度 PI + 标定前馈”的确定性级联结构**。这套结构计算量固定、状态量少、容易逐级整定，适合 RT1064，也更适合 20 cm 网格上的轴对齐短行程和推箱负载突变。

这里的“最优”是指在现有硬件、代码复杂度、实时性、可调试性和竞赛可靠性之间的工程最优。没有电机阶跃数据、载荷模型和重复实车日志，无法从源代码单独证明某组增益在数学意义上全局最优。

## 2. 已审阅范围

| 层级 | 主要文件 | 评审内容 |
|---|---|---|
| 调度 | [`project/user/src/isr.c`](project/user/src/isr.c)、[`project/user/src/main.c`](project/user/src/main.c) | 5 ms IMU、20 ms 编码器/控制、主状态机调度 |
| 顶层控制 | [`project/code/chassis_ctrl.c`](project/code/chassis_ctrl.c)、[`project/code/chassis_ctrl.h`](project/code/chassis_ctrl.h) | 模式、位置环、角度环、到达判定、输出链、并发 |
| 参数 | [`project/code/config/configChassis.h`](project/code/config/configChassis.h)、[`project/code/chassis_config.h`](project/code/chassis_config.h) | 速度/加速度、PID、MPC、极性、IMU、场地参数 |
| 执行器闭环 | [`project/code/chassis_pid.c`](project/code/chassis_pid.c)、[`project/code/chassis_motor.c`](project/code/chassis_motor.c) | 增量 PID、PWM 限幅、方向切换 |
| 估计器 | [`project/code/chassis_encoder.c`](project/code/chassis_encoder.c)、[`project/code/chassis_imu.c`](project/code/chassis_imu.c) | 轮速、KF、ZUPT、编码器航向弱融合 |
| 运动学与安全 | [`project/code/chassis_mecanum.c`](project/code/chassis_mecanum.c)、[`project/code/chassis_zone.c`](project/code/chassis_zone.c) | O 型麦轮正逆解、里程计、软限位、OOB |
| MPC | [`project/code/chassis_mpc.c`](project/code/chassis_mpc.c)、[`project/code/chassis_mpc.h`](project/code/chassis_mpc.h) | 模型、代价、FISTA、热启动与回退 |
| 硬件与文档 | [`project/code/config/pinMap.h`](project/code/config/pinMap.h)、[`docs/PINOUT.md`](docs/PINOUT.md)、[`PROJECT.md`](PROJECT.md) | 映射与坐标职责 |

本次只新增评审文档，没有修改控制代码，因此不增加 BSS/栈占用、不改变 5 ms/20 ms 任务执行时间。

## 3. 当前控制链

```text
PIT 5 ms
  IMU 采样 -> 角速度滤波/静止检测 -> KF 航向估计

PIT 20 ms
  四轮编码器 -> 轮速 LPF -> 麦轮逆解 -> 车体速度/里程计
      -> POINT_NAV 位置控制 或 YAW_HOLD 角度控制
      -> 速度/角速度斜坡 -> 麦轮正解 -> 四轮目标速度
      -> 每轮增量 PID + 静摩擦补偿 + 平移 PWM 前馈 + yaw PWM 前馈
      -> 最终 PWM 限幅 -> 电机驱动
```

当前分层方向基本正确，但一个物理作用被多个环节重复实现：

- 加减速同时由 sqrt 控制器/MPC、20 ms ramp 和末段 brake cap 处理；
- 克服静摩擦同时由位置积分、轮速增量积分、breakaway floor 和直接 PWM 前馈处理；
- 航向同时由角度外环、角速度 PI、四轮速度环和单独 yaw PWM 前馈处理。

这会导致“某一层参数变化，另一层通过饱和或积分抵消”的耦合，实车调参难以复现。

## 4. 当前方案中值得保留的部分

1. **O 型麦轮正逆运动学一致。** 四轮目标做等比例缩放，能够在单轮达到速度上限时保持车体速度方向。
2. **坐标变换的当前实现与项目地图系一致。** 地图系 X 向右、Y 向下，车体系 X 向右、Y 向前，当前里程计使用 `gx=c·vx+s·vy, gy=-s·vx+c·vy`，已覆盖 `yaw=±90°` 的历史问题（[`chassis_ctrl.c:1062`](project/code/chassis_ctrl.c#L1062)）。
3. **位姿使用 seq-lock 快照。** 主循环不会轻易读到混合的新旧 x/y/yaw（[`chassis_ctrl.c:149`](project/code/chassis_ctrl.c#L149)）。
4. **位置导航与视觉职责分离。** 连续运动以编码器/IMU 为主，到站或大偏差时使用视觉 Snap，符合整数格视觉观测特性。
5. **编码器航向仅作弱融合并带创新门限。** 方向正确，但仍需结合打滑状态控制可信度。
6. **除 MPC 外主要计算均为固定复杂度。** 控制数据为少量标量和四轮数组，适合 MCU 实时执行。

## 5. 主要问题与风险分级

### 5.1 P0：应在继续调增益前修复

#### P0-1 到达判定不等于“停稳”

位置模式在 `dist <= 0.014 m` 时立即置 `arrived=1` 并清空 ramp（[`chassis_ctrl.c:1128`](project/code/chassis_ctrl.c#L1128)），没有检查平移速度、航向误差、实测角速度或连续满足时间。上层最早可在下一次 5 ms 调度中派发下一航点，因此可能出现“位置刚穿过阈值但车仍在滑动，就开始下一段”。

到达后只要距离不超过 `CHASSIS_POS_HOLD_EXIT_M=0.30 m` 就继续报告到达（[`configChassis.h:195`](project/code/config/configChassis.h#L195)、[`chassis_ctrl.c:1138`](project/code/chassis_ctrl.c#L1138)）。一个网格约 0.20 m，30 cm 回差会掩盖显著扰动或推箱反作用。

**建议：** 到达改为“位置 + 速度 + 航向 + 角速度 + dwell”；保持退出回差降到 3～5 cm。

#### P0-2 X 轴回切状态机无效

Y 阶段检测到 X 误差显著增大时，代码先执行 `s_axis_y_locked=0`（[`chassis_ctrl.c:1291`](project/code/chassis_ctrl.c#L1291)）；但随后同一分支立刻执行切换初始化，并在 [`chassis_ctrl.c:1311`](project/code/chassis_ctrl.c#L1311) 再次置为 `1`。因此不会在下一拍真正进入 X 驱动分支。

**建议：** 用显式枚举表达导航阶段；回切时立即结束当前分支，下一拍进入 X 驱动。

#### P0-3 IMU 匀速旋转可能被误判为静止

静止检测只判断窗口方差是否小于阈值（[`chassis_imu.c:179`](project/code/chassis_imu.c#L179)、[`chassis_imu.c:213`](project/code/chassis_imu.c#L213)）。若车辆以稳定的非零角速度旋转，窗口方差仍可能很小，ZUPT 随后会把真实旋转量作为 bias 观测，导致角速度被压低、航向积分错误。

**建议：** 静止同时满足低方差、均值接近当前 bias、轮速接近零、控制指令接近零。

#### P0-4 最终执行器饱和没有闭环反积分

增量 PID 内部输出先被限幅（[`chassis_pid.c:54`](project/code/chassis_pid.c#L54)），随后又叠加 breakaway、平移直接 PWM 和 yaw 直接 PWM，最后再次限幅（[`chassis_ctrl.c:497`](project/code/chassis_ctrl.c#L497)、[`chassis_ctrl.c:521`](project/code/chassis_ctrl.c#L521)、[`chassis_ctrl.c:531`](project/code/chassis_ctrl.c#L531)、[`chassis_ctrl.c:541`](project/code/chassis_ctrl.c#L541)）。PID 不知道最终实际输出被截断了多少，不能做 tracking anti-windup。

头文件声称增量 PID“不存在积分饱和问题”（[`chassis_pid.h:10`](project/code/chassis_pid.h#L10)）也不成立：输出累加器在饱和期间仍被误差驱动，只是数值被钳住，误差反向时仍可能延迟解除饱和。

**建议：** 统一为一次前馈 + PI 反馈 + 一次最终限幅，用最终饱和差反积分。

#### P0-5 电机换向没有安全过渡

当前电机输出先根据新符号修改方向 GPIO，再写入新占空比（[`chassis_motor.c:53`](project/code/chassis_motor.c#L53)）。如果上一拍仍有较大占空比，正负目标快速切换时没有“先 PWM=0、再换方向、再恢复占空比”的过程。

**建议：** 检测符号翻转时至少插入一个控制拍的零占空比；若驱动器数据手册要求死区，按其最小时间实现。

### 5.2 P1：影响控制品质与可调试性

#### P1-1 当前 MPC 不适合直接接管本车位置和航向

MPC 使用 `x(k+1)=x(k)-dt·u(k)`（[`chassis_mpc.c:4`](project/code/chassis_mpc.c#L4)），决策量是未来速度。它没有当前实测速度、加速度/电机状态、从当前命令到 `u0` 的平滑代价，也没有打滑、推箱载荷或执行器延迟模型。

位置 MPC 生效时，外层明确丢弃实测轴速度和原有阻尼项（[`chassis_ctrl.c:735`](project/code/chassis_ctrl.c#L735)）。实际加速度约束由后级 ramp 另行施加，预测模型并不知道该约束，因此预测轨迹与执行轨迹不一致。

注释中的原始二次代价与求解形式 `1/2·VᵀHV+gᵀV` 之间也存在尺度不一致：`g` 使用 `-2Qdt·x0`，H 中对应二次项没有同样乘 2（[`chassis_mpc.c:65`](project/code/chassis_mpc.c#L65)、[`chassis_mpc.c:113`](project/code/chassis_mpc.c#L113)）。FISTA 每拍最多 15 次迭代、预测域 10（[`configChassis.h:626`](project/code/config/configChassis.h#L626)、[`configChassis.h:650`](project/code/config/configChassis.h#L650)），并直接运行在 20 ms PIT ISR 中，当前没有 DWT 最坏执行时间证据。

**建议：** 当前 MPC 默认关闭。若未来保留，应重建为 `[位置误差, 实测速度]` 状态、加速度为控制量，并纳入速度/加速度/jerk 约束；在此之前轨迹生成器更可靠。

#### P1-2 角度“在位”门限过松

角度锁进入条件允许 `|yaw_rate| < 25°/s`（[`configChassis.h:147`](project/code/config/configChassis.h#L147)、[`chassis_ctrl.c:789`](project/code/chassis_ctrl.c#L789)）。对推箱和视觉采样，25°/s 仍是明显旋转。

角速度积分实际使用 `s_yaw_i`，另有 `s_yaw_rate_i` 与 ADRC 状态只初始化/清零、没有参与控制（[`chassis_ctrl.c:233`](project/code/chassis_ctrl.c#L233)），说明存在遗留策略。

**建议：** 角速度到位门限降到 3～5°/s；删除未使用状态；积分反卷绕依据 rate error 和最终限幅。

#### P1-3 静摩擦补偿已变成大范围速度前馈

四轮默认 `target_eps=0`（清洗后约 `0.001 m/s`）、`fb_static_eps=0.90 m/s`、floor 为 800～900 PWM（[`configChassis.h:412`](project/code/config/configChassis.h#L412) 附近）。补偿在低速到中速的大部分区间持续存在，而不只是起步静摩擦。

同时 `CHASSIS_HOLD_PWM_GAIN` 实际对全部平移指令生效，不只对保持轴；`CHASSIS_YAW_PWM_GAIN` 注释说“已废弃”，实现却仍在使用（[`chassis_ctrl.c:43`](project/code/chassis_ctrl.c#L43)、[`chassis_ctrl.c:50`](project/code/chassis_ctrl.c#L50)、[`chassis_ctrl.c:521`](project/code/chassis_ctrl.c#L521)）。

**建议：** 用每轮、每方向标定的 `kS·sign(v_ref)+kV·v_ref` 代替多套经验 PWM 补偿，需要时再加 `kA·a_ref`。

#### P1-4 参数与注释失去单一真相

- 最大平移速度注释为 `0.70 m/s`，实际为 `1.80 m/s`（[`configChassis.h:356`](project/code/config/configChassis.h#L356)）。
- 末段最小速度注释推荐 `0.15 m/s`，实际为 `0.25 m/s`（[`configChassis.h:244`](project/code/config/configChassis.h#L244)）。
- 默认 PID 宏为 `120/8/1`，各轮实际初始化值为 `70/20/0`（[`configChassis.h:72`](project/code/config/configChassis.h#L72)、[`configChassis.h:81`](project/code/config/configChassis.h#L81)）。
- `chassis_ctrl.h` 把全局 Y 写成“向前为正”，实际项目地图 Y 向下（[`chassis_ctrl.h:41`](project/code/chassis_ctrl.h#L41)、[`chassis_ctrl.c:1065`](project/code/chassis_ctrl.c#L1065)）。
- 项目硬件契约写 DRV8701E，速度注释却仍以 TB6612 过流为依据。

**建议：** 编译参数、单位、硬件型号和实测日期统一为单一真相；历史调参记录放独立日志，不混入当前宏注释。

### 5.3 P2：安全边界与并发完整性

1. `POINT_NAV` 主动跳过软限位（[`chassis_ctrl.c:1482`](project/code/chassis_ctrl.c#L1482)）。应在航点派发时验证整段扫掠圆/走廊，运行时保留 OOB 硬停。
2. `hold_yaw`、`rotate_to_deg`、`stop` 和调参 setter 更新多个共享状态时没有统一短临界区（[`chassis_ctrl.c:1556`](project/code/chassis_ctrl.c#L1556)、[`chassis_ctrl.c:1611`](project/code/chassis_ctrl.c#L1611)、[`chassis_ctrl.c:1759`](project/code/chassis_ctrl.c#L1759)）。20 ms ISR 可能观察到一次部分更新。
3. `chassis_ctrl_set_pose` 保护了 `s_pose`，但释放中断后才更新 IMU/KF 和 odom yaw（[`chassis_ctrl.c:1732`](project/code/chassis_ctrl.c#L1732)），仍可能被 5 ms ISR 插入。
4. 区域静止检测以 5 ms 对位姿做差，但底盘 x/y 每 20 ms 才更新（[`chassis_zone.c:217`](project/code/chassis_zone.c#L217)），会得到“三拍零速度 + 一拍四倍速度”的序列。
5. 没有看到完整堵转/过流/热保护闭环。至少应增加“高 PWM + 非零目标 + 低实测速度持续超时”的堵转停机。

## 6. 推荐的最优控制架构

```text
路径航点/推箱动作
  -> 轴对齐分段器（ALIGN_YAW / DRIVE_X / DRIVE_Y / SETTLE / HOLD）
  -> 梯形或限 jerk 轨迹生成器：p_ref, v_ref, a_ref
  -> 位置反馈：v_cmd = v_ref + Kp_pos·(p_ref-p)
  -> 全局速度转车体速度
  -> 航向角外环：yaw error -> yaw-rate reference
  -> 航向角速度 PI：rate error -> wz command
  -> 麦轮正运动学：4 个 wheel-speed reference
  -> 每轮 kS+kV(+kA) 前馈 + PI 反馈 + 最终反积分
  -> 换向保护/PWM 限幅 -> 电机

编码器 -> 轮速/里程计 --------------------^
IMU -> yaw/yaw-rate -----------------------^
视觉整数格 -> 到站 Snap / 异常重定位，不进入连续快环
```

这一架构的核心原则是：每一层只承担一个职责；位置和航向层只生成速度参考，真正克服电机死区和负载的工作统一放在轮速执行层。

### 6.1 调度建议

| 周期 | 内容 | 设计要求 |
|---|---|---|
| 5 ms / 200 Hz | IMU 采样、yaw/yaw-rate 估计 | 固定 O(1)，不做日志格式化或复杂求解 |
| 10 ms / 100 Hz（推荐目标） | 角速度 PI、四轮速度 PI、电机输出 | 编码器可使用两拍计数/观测器抑制低速量化；若量化过大则先保持 20 ms |
| 20 ms / 50 Hz | 位置轨迹、角度外环、导航状态机、到位 dwell | 固定 O(1)，足够覆盖 20 cm 网格运动 |
| 主循环低频 | 视觉 Snap、日志、故障上报、参数保存 | 不放在 PIT ISR 中 |

迁移第一阶段可以继续保持现有轮速 20 ms，先把控制职责和安全问题理顺；只有在 DWT 和编码器量化数据支持时再升到 100 Hz。不能为了提高名义频率而让低速反馈只剩 0/1 个脉冲。

### 6.2 四轮速度环

每轮、每方向做开环标定，得到：

```text
u_ff = kS_dir·sign(v_ref) + kV_dir·v_ref + kA·a_ref（kA 可选）
e_v = v_ref - v_meas
u_raw = u_ff + Kp_v·e_v + I_v
u_sat = clamp(u_raw, -PWM_MAX, PWM_MAX)
I_v(k+1) = clamp(I_v + Ki_v·dt·e_v + Kaw·(u_sat-u_raw), Imin, Imax)
```

关键规则：

- `|v_ref|` 和 `|v_meas|` 都很小时输出 0 并复位积分；
- 只保留这一套物理前馈，删除 breakaway 衰减、全平移 hold PWM 和单独 yaw PWM 的重复职责；
- `kS/kV` 至少按四轮和正/反方向标定；麦轮横移负载明显不同时再做少量方向调度，不要先验堆叠多层 floor；
- 最终执行器限幅只有一次，反积分使用最终 `u_sat-u_raw`；
- 输出符号翻转时先输出 0，完成方向切换后下一拍再加占空比；
- 轮速 Kd 初始保持 0。编码器差分噪声下，D 项通常不如滤波和前馈标定有效。

### 6.3 位置环与分段轨迹

推箱路径是曼哈顿网格路径，最合适的不是二维自由轨迹优化，而是**显式一维分段控制**：

```c
typedef enum {
    NAV_ALIGN_YAW,
    NAV_DRIVE_X,
    NAV_DRIVE_Y,
    NAV_SETTLE,
    NAV_HOLD
} nav_phase_t;
```

每个轴段保存不可变的 `start`、`goal`、`cross_axis_ref`，使用梯形或限 jerk 轨迹生成 `p_ref/v_ref/a_ref`。位置反馈只修正模型和里程计小误差：

```text
v_cmd = clamp(v_ref + Kp_pos·(p_ref-p), -v_limit, +v_limit)
```

若第一阶段不实现完整参考轨迹，至少使用基于停止距离的确定性速度曲线：

```text
v_stop = sqrt(2·a_max·max(|e|-e_tol, 0))
v_ref = sign(e)·min(v_cruise, v_stop)
```

再对 `v_ref` 施加明确的加速度/jerk 限制。位置层不建议再加 I；静摩擦和负载稳态误差应由轮速 PI 消除。若实车证明仍有固定位置偏置，可增加很小且分轴独立的积分，并仅在低速、未饱和、误差同向时积分。

状态转移规则：

- `NAV_ALIGN_YAW`：航向满足误差、角速度和 dwell 后才允许平移；
- `NAV_DRIVE_X/Y`：主轴走轨迹，副轴跟踪固定路径线；
- 副轴误差超过重入阈值时明确切回对应驱动状态，并立即结束本拍逻辑；
- `NAV_SETTLE`：速度参考为零，但位置和航向小范围闭环保持；
- `NAV_HOLD`：满足完整到位条件后置 arrived；受扰超出 3～5 cm 时回到 SETTLE。

### 6.4 航向角环与角速度环

外环根据角度误差生成可制动的角速度参考：

```text
w_stop = sqrt(2·alpha_max·|yaw_error|)
w_ref = sign(yaw_error)·min(w_max, w_stop, Kp_yaw·|yaw_error|)
```

内环使用 IMU 实测角速度：

```text
e_w = w_ref - w_meas
w_cmd = w_ref + Kp_w·e_w + I_w
```

`I_w` 只在未饱和或误差推动输出脱离饱和时累积，并用最终限幅差反积分。`w_cmd` 经麦轮运动学变成四轮速度目标，由统一的轮速前馈/PI 执行，不再叠加独立 yaw PWM。

平移期间可以保留同一角速度内环，但应降低 yaw 参考上限，避免横向打滑时航向环与位置环争夺轮速余量。

### 6.5 到位判定

建议使用连续 5～8 个 20 ms 控制拍（100～160 ms），同时满足：

```text
position_error_norm <= 0.010～0.015 m
translation_speed <= 0.03～0.05 m/s
yaw_error <= 1.0°
abs(yaw_rate) <= 3～5°/s
```

推箱动作还应分别记录沿推方向误差和横向误差，横向门限不应比普通导航更宽。上层视觉 Snap 只能做最终格中心校正，不能替代机械停稳。

### 6.6 IMU 与里程计

静止判定至少同时满足：

```text
gyro_variance < var_threshold
abs(gyro_mean - signed_bias) < mean_threshold
max_abs(wheel_speed[4]) < wheel_threshold
abs(commanded_wz) < command_threshold
```

同时应：

- 统一 bias 所在符号域；当前 `CHASSIS_IMU_YAW_SIGN=-1`，初始化、KF 预测、ZUPT 和调试输出必须使用同一约定；
- 外部重置 yaw、KF 和 odom-yaw 时使用一个短临界区或命令邮箱；
- 仅在低打滑、角速度创新合理时使用编码器航向弱融合；
- 视觉只有整数格坐标时继续使用事件式 x/y Snap，不持续融合进 200 Hz 姿态环。

### 6.7 安全与并发

1. 所有控制命令通过短临界区写入完整命令结构，或使用双缓冲 command mailbox；ISR 每拍只读取一次一致快照。
2. `stop` 先原子切换模式/清目标，再立即把四路 PWM 置零；故障停机不能等待位置状态机收敛。
3. 航点派发时对车体外接圆沿整段路径的扫掠区域做地图碰撞检查；运行中保留 OOB 硬停。
4. 增加堵转监控：高 PWM + 非零目标 + 低轮速持续一定时间即停机并上报，阈值通过最大正常推箱负载确定。
5. 更换电机、编码器线序、减速箱或轮位后，重新核对当前硬件极性：
   - 电机输出 `LF/RF/LB/RB = +,-,+,-`；
   - 编码器 `LF/RF/LB/RB = +,-,+,-`；
   - IMU 偏航轴为 Y，符号 `-1`。

## 7. 建议的安全初始参数范围

下表是进入系统辨识前的保守起点，不是免调的最终值：

| 参数 | 建议起点 | 说明 |
|---|---:|---|
| 自由导航最大平移速度 | `0.60～0.70 m/s` | 当前注释曾以 0.70 m/s 作为过流修正，完成电流/温升验证前不使用 1.80 m/s |
| 推箱最大平移速度 | `0.30～0.45 m/s` | 依据最大箱体阻力和轮胎打滑再提高 |
| 最大平移加速度 | `1.0～1.5 m/s²` | 当前 3.0 m/s² 对 20 cm 短段偏激进 |
| 最大角速度 | `90～120°/s` | 先保证 90° 转向不超调 |
| 最大角加速度 | `360～600°/s²` | 配合停止距离整定 |
| 角度到位误差 | `≤1.0°` | 与四基准航向和视觉采样一致 |
| 角速度到位门限 | `3～5°/s` | 替代当前 25°/s |
| 位置到位误差 | `10～15 mm` | 必须同时满足速度和 dwell |
| 到位保持退出 | `30～50 mm` | 替代当前 300 mm |

轮速 PI、`kS/kV` 和滤波截止频率不能仅凭源码给出可靠数值，必须用实车数据辨识。

## 8. 推荐实施顺序

### 阶段 A：先消除逻辑和安全缺陷

1. 完整到位判定与 3～5 cm hold 回差；
2. 显式导航状态机，修复 X/Y 回切；
3. IMU 静止检测增加均值、轮速和指令门控；
4. 电机换向零 PWM 过渡；
5. 控制命令与估计器重置统一并发保护；
6. 统一坐标、硬件型号、单位和默认参数注释。

### 阶段 B：重整执行器和级联环

1. 逐轮标定正反向 `kS/kV`；
2. 用统一速度 PI + 前馈 + 最终反积分替换增量 PID 和多层 PWM floor；
3. 保留角度外环和角速度 PI，去掉单独 yaw PWM；
4. 关闭位置/yaw MPC，使用停止距离曲线或梯形轨迹；
5. 删除未使用 ADRC/积分状态和失效参数。

### 阶段 C：轨迹与性能优化

1. 加入分段梯形/限 jerk 参考轨迹；
2. 依据 DWT 和编码器量化决定轮速环是否从 50 Hz 升到 100 Hz；
3. 加入堵转、饱和占空比和控制周期超时诊断；
4. 只有在基线控制完成并有日志对照后，才评估完整状态 MPC 是否有统计显著收益。

## 9. 完整验证流程与验收标准

### 9.1 硬件极性与开环

逐轮悬空、低 PWM、正反方向测试：

- 正轮速命令对应项目定义的物理正向；
- 编码器反馈符号与命令一致；
- 四轮安装映射 LF/RF/LB/RB 无错位；
- 手动左转时 IMU yaw/yaw-rate 符号符合项目约定；
- 换向时用示波器或逻辑分析仪确认 PWM 先归零再切方向。

### 9.2 轮速环

每轮分别测试 `±0.15、±0.30、±0.50、±0.70 m/s`，空载和代表性推箱负载各执行多次，记录目标、反馈、PWM、饱和标志：

- 稳态误差建议 `≤0.03 m/s`；
- RMS 跟踪误差建议 `≤0.05 m/s`；
- 阶跃超调建议 `≤10%`；
- 不出现持续极限环、长期饱和或正反方向明显不对称；
- 堵转释放后积分快速恢复，不出现长时间反向冲击。

先完成 `kS/kV`，再从 `Ki=0` 调 Kp，最后增加 Ki；不要在位置环闭合时调轮速环。

### 9.3 航向环

测试 `±30°、±90°、180°`，分别在静止、低速平移和推箱负载下执行：

- 最终角度误差 `≤1.0°`；
- 宣告到位时 `|yaw_rate|≤3～5°/s`；
- 不越过目标反复摆动，不因匀速旋转误触 ZUPT；
- 进入饱和后积分能正常释放；
- 0/90/180/-90° 四个基准航向保持的轮速符号正确。

### 9.4 位置环与网格流程

每个方向至少重复 20 次：

1. `+X、-X、+Y、-Y` 单格 20 cm；
2. 两格及多格长段；
3. X→Y、Y→X 转折；
4. 四个基准 yaw 下的单格运动；
5. 外力横推后副轴恢复与状态回切；
6. 空载、推箱、不同电池电压。

验收使用 95 分位而不是单次最好值：

- 终点位置误差 `≤15 mm`；
- 横向偏差 `≤10～15 mm`；
- 到达时平移速度 `≤0.05 m/s`；
- 到位 dwell `≥100 ms`；
- 不出现“穿过阈值即切下一航点”；
- 受扰超过 hold 回差后会重新闭环。

### 9.5 完整自主与推箱

- 地图稳定 → 发车定位 → 识别巡航 → 分类 → 规划 → 推箱 → 关间恢复全流程；
- 覆盖视觉在线、暂时掉线和延迟三种场景；
- 箱体阻力突变时不错误到位、不长期堵转；
- Snap 只在机械停稳后开始采样；
- 任何故障停机都能在一个控制周期内将四路 PWM 清零。

### 9.6 实时性和内存

用 DWT 周期计数器分别记录 5 ms 与 20/10 ms 控制 ISR 的平均、99.9 分位和最大执行时间：

- 5 ms IMU ISR 建议最坏时间 `<200 μs`；
- 轮速/导航控制 ISR 建议最坏时间 `<500 μs`；
- 不在 ISR 中 `printf`、写 Flash 或做视觉/地图大块处理；
- 去掉当前 MPC 后，推荐方案只增加少量轨迹和状态变量，新增常驻内存应远小于 1 KB，不新增超过 10 KB 的 BSS 数组；
- 主循环 `Game_Logic_Task_Run` 仍满足项目要求的单次 `<800 μs`。

每次测试同时保存参数版本、电池电压、载荷、地面和轮胎状态，否则不同批次曲线不可比较。

## 10. 是否应继续使用 MPC

近期结论：**不应让当前 MPC 接管正式位置环或航向环。**

若未来确实需要 MPC，应先满足：

1. 有空载/推箱两种工况的输入—速度—位置日志；
2. 模型状态至少为 `[位置误差, 实测速度]`，控制量为加速度或等效驱动力；
3. 代价包含当前控制量到第一步控制量的变化，即 `u0-u_prev`；
4. 显式约束速度、加速度和 jerk，并与实际执行层使用同一约束；
5. 修正 QP 的 H/g 尺度并离线验证最优解；
6. 在 MCU 上测得可靠 WCET，并与无 MPC 基线做盲测统计对比。

对 20 cm 曼哈顿网格和有限赛道，限 jerk 轨迹 + 级联 PI 通常具有更低风险和更高可解释性。只有实测证明它不能满足误差/时间指标时，完整 MPC 才有必要。

## 11. 最终建议

1. 不继续围绕当前多层补偿结构逐个微调宏，先修复 P0 问题。
2. 以逐轮速度 PI + 物理前馈为唯一执行器控制核心；位置和航向层只生成速度参考。
3. 将 X/Y 导航改成显式状态机和确定性分段轨迹；到位必须包含速度、角速度和 dwell。
4. 默认关闭当前位置/yaw MPC，建立无 MPC 的可重复基线。
5. 先做极性与逐环实车辨识，再做完整自主流程；所有最终增益以日志统计结果为准。

完成上述改造后，控制链会从“多个经验补偿叠加”收敛为“每层只有一个清晰职责”的结构，既符合 RT1064 的实时/内存边界，也更容易定位推箱负载、打滑、低电压和视觉延迟造成的问题。
