leo-lizx/transport-truck/docs/升降步进模式9接线与测试.md

# 升降步进：接线、调试方法与故障记录（模式 9）

> 适用：FSK30 丝杆模组（导程 12 mm）+ 脉冲/方向（STEP/DIR）步进驱动器，RT1064 主板 V3.0。
> 更新：2026-11-11。
> 状态：固件 IAR 编译 0 error 0 warning，主机测试 18 用例 0 失败；已烧录并实测 D12 有脉冲输出。
> **首块驱动板 RMN28-PUL 确认损坏（不响应脉冲），整机运动尚未验证**，待新驱动器到货后按第 6 节复测。

## 1. 已确认参数

| 项目 | 值 | 来源 |
|---|---|---|
| 丝杆导程 | 12 mm | 用户手转 10 圈实测 |
| 细分 | 1/8（RMN28：S1=ON S2=OFF S3=OFF） | 用户设置，对照厂家拨码表 |
| 换算 | 1600 微步/圈，约 133.3 步/mm | 按 1.8° 电机计算，**待核对电机铭牌** |
| 限位开关 | 两线，按下导通，装在电机端 | 用户确认 |
| 断电保持 | 断电时丝杆不下滑（当前负载） | 用户实测 |
| RMN28 供电 | DC 12–36 V、**2 A**，推荐 24 V | 厂家资料 |
| RMN28 输入 | P±/D± 差分，3.3–5 V，100 Hz–20 kHz | 厂家资料 |
| RMN28 电流 | 峰值 2 A，实际 0–1 A 可调；VR1 **逆时针减小** | 厂家资料 + 实测 |

## 2. 接线

### 2.1 主板侧（与驱动器型号无关）

| 信号 | 主板引脚 | 说明 |
|---|---|---|
| 脉冲 STEP | **D12**（P7 的 SCK 针） | 3.3 V 方波，占空比 50% |
| 方向 DIR | **D13**（P7 的 CS 针） | 高 = 远离开关（`STEPPER_DIR_LEVEL_AWAY_FROM_HOME`） |
| 限位开关 | **P21.1（D4）** 与 **P21.3（GND）** | 板上带上拉，按下 = 低电平；不要接 P21.2（3V3） |
| 公共地 | 主板 GND ↔ 驱动器电源地 | 必须共地 |

P7 是 2×5 排针，针位以丝印和原理图为准，接线后用通断挡确认导线端头确实通到核心板 D12/D13。
占用 D12/D13 后，P7 不能再插 SPI 无线模块。

### 2.2 RMN28-PUL 驱动板

| 端子（丝印从左到右） | 接线 |
|---|---|
| V+ / V- | 外部 12 V 电源正 / 负（粗红 / 粗黑），**不能接主板电池输出** |
| B+ / B- | 细红 / 蓝（同一相） |
| A- / A+ | 绿 / 细黑（同一相） |
| J1：P- / P+ / D- / D+ | 主板 GND / D12 / 主板 GND / D13（线色：灰 / 黄 / 红 / 橙） |

### 2.3 通用 STEP/DIR 模块（DRV8825 / A4988 / TMC2209 等，换板时参考）

```text
STEP ← D12        DIR ← D13         GND ← 主板 GND
EN   → GND（低有效使能）              RESET 与 SLEEP 短接（DRV8825/A4988）
VMOT = 12 V，就近并 100 µF 电解电容
1A/1B ← 细黑/绿（A 相）    2A/2B ← 细红/蓝（B 相）
细分脚按模块资料设为 1/8（与 STEPPER_MICROSTEP 一致）
```

固件不需要修改；若细分不是 1/8，同步改 `configStepper.h` 的 `STEPPER_MICROSTEP`。
换板后若方向相反，改 `STEPPER_DIR_LEVEL_AWAY_FROM_HOME`（1U↔0U）或断电互换一相线。
电流按模块公式和**电机额定电流**设置（如 DRV8825：I ≈ Vref × 2），先取额定值的 50–70%。

## 3. 模式 9 行为

`main.c` 默认 `MAIN_RUN_MODE_STEPPER_TEST`（9）。本模式**不初始化底盘、IMU、编码器和电机 PWM**，
不启动 PIT_CH0/CH1，只用 PIT_CH2 产生 5 ms 主循环节拍；主板不接 IMU 也能运行。
脉冲由 GPT1 比较中断翻转 D12 产生，梯形加减速（`stepper_profile.h`）。

| 阶段 | 动作 |
|---|---|
| 上电 | 按键、D12/D13/D4 与 GPT1 初始化，不发脉冲 |
| 进入主循环 1 s 后 | 以 5 mm/s 朝开关运动，最多走 50 mm |
| 碰到开关 | 退 2 mm，再以 2 mm/s 慢碰（最多 4 mm），触发点记为 0 |
| 就绪 | 停在离开关 2 mm 处（`s_state` = 5） |
| K1（C15） | 远离开关 10 mm，不超过软件上限 40 mm |
| K2（C14） | 朝开关 10 mm，不低于 1 mm |
| K3（C13） | 重新回原点 |
| K4（C12） | 任何时候立即停止（`s_state` = 7），按 K3 恢复 |

朝开关方向的任何运动在开关触发（连续 3 个步进周期读到低电平）时立即停止。
找开关走满最大行程仍未触发进入故障（`s_state` = 6），不再自动运动。

`s_state` 取值：0 等待启动，1 快速找开关，2 退出，3 慢速找开关，4 去就绪位，5 就绪，6 找不到开关，7 急停。
K1–K4 与物理按键的对应关系须上板核对（见 4.2）。

## 4. 调试方法

### 4.1 上电顺序

1. 断电，用手把滑台推到行程中间（离开关 20 mm 以上）。
2. 电源设 12 V、**限流 2 A**（按驱动器资料；限流过低会触发 5.1 的欠压故障）。
3. 先只给驱动器上电：电压保持 12 V，静止电流约 0.3 A，L1/L2 不亮，电机有保持力矩。
4. 再给主板上电，手放在驱动器电源开关上；1 s 后滑台应朝开关慢速移动。
5. 若主板先上电、驱动器后上电，主板会在约 10 s 后进入“找不到开关”，按 K3 重新回原点即可。

### 4.2 不带电机核对按键

驱动器不上电，只给主板上电并用 IAR 调试：Live Watch 加 `s_state`。
`s_state` = 1 时逐个按键，变为 7 的是 K4；停机后能让它回到 1 的是 K3；就绪后按 K1 位置变大、K2 变小。

### 4.3 分段定位“电机不动”

按信号流向从主板到电机逐段测量，每段都能单独下结论：

| 步骤 | 测量 | 正常结果 | 异常时 |
|---|---|---|---|
| 1 | IAR Live Watch：`s_main_tick_total`、`s_state`、`s_pos_steps` | tick 递增；`s_state` = 1；`s_pos_steps` 持续变负 | tick 不变：主循环未运行（如卡在初始化） |
| 2 | 万用表直流挡，核心板 D12 针对 GND | 发脉冲期间约 1.65 V（3.3 V 方波平均值），停发后 0 V | 恒 0 V 或 3.3 V：固件未发脉冲 |
| 3 | 驱动器 P+ 对 P- | 与第 2 步相同 | 0 V：导线或排针位置错误 |
| 4 | 1/2 步，P- 接地，用 P+ 手动碰 5 V，测 A+/A-、B+/B- 电压 | 每碰一次至少一相电压改变 | 两相都不变：驱动器不响应脉冲（5.3） |
| 5 | 电机单独测试：限流 0.3 A，按 A+→B+→A-→B- 轮流给线圈通电 | 每步转 1.8°，方向一致 | 某相吸不住：电机或线序问题 |

### 4.4 标定与验收

1. 回原点后按 K1 一次，钢尺量位移，应为 10.0 mm；连按到 40 mm 量总位移。
   偏差正好一倍说明步距角或细分设置不一致。
2. K1/K2 往返 10 次后按 K3，观察开关触发位置是否一致；不一致说明丢步，适当调大电流。
3. 量出开关触发点到另一端止挡的有效行程，留 5 mm 余量后放宽 `STEPPER_SOFT_MAX_MM`。
4. 不丢步后再逐步提高 `STEPPER_JOG_SPEED_MMPS`（20 kHz 上限对应 150 mm/s）和
   `STEPPER_ACCEL_MMPS2`（模组额定 600 mm/s²）。

## 5. 故障记录（2026-11-11）

### 5.1 上电后电压被拉到 6 V，驱动器“叫”且音调升高

| 条件 | 电源读数 | 结论 |
|---|---|---|
| 出厂电位器，Vref 2.13 V，接电机，限流 1 A／0.5 A | 被拉到约 6 V，电流顶到限流值 | 相电流过大，电源进入限流，驱动器欠压反复启停 |
| 不接电机，限流 0.5 A | 12 V、0.012 A，L1 亮（负载开路） | 驱动器本身正常 |
| Vref 调到 1.15 V，接电机，限流 1 A | 12 V、0.28 A | 正常，作为当前设定 |
| 拨码改整步（两相满电流），限流 1 A | 再次被拉到 6 V | 整步电流约翻倍，限流不足 |

处理：先断开电机测驱动器空载电流，再用 Vref 测试点确定电位器方向并调小电流；
电源限流按资料设 2 A。斩波驱动静止时有稳定的轻微高频声属于正常，**音调持续升高通常是欠压或在走步**。

### 5.2 模式 9 上电后完全无反应

原因：早期版本的模式 9 仍执行 `chassis_ctrl_init()`，台架主板未接 IMU 时可能卡在 IMU 初始化，
主循环不运行。处理：模式 9 改为跳过底盘初始化，并改用 PIT_CH2 产生主循环节拍。

### 5.3 驱动板不响应脉冲（判定损坏）

| 检查 | 结果 |
|---|---|
| 核心板 D12 / D13 | D12 发脉冲期间约 1.65 V，约 10 s 后变 0 V；D13 恒 0 V，均符合固件设计 |
| J1 P+ 对 P- | 约 1.65 V，脉冲已到驱动器 |
| P+/P- 对调 | 仍不动 |
| 1/2 步，P+ 手动碰 5 V / 3V3 | 不动 |
| 1/2 步，A 相电压 | 恒 1.76 V，碰 5 V 前后不变 |
| 1/2 步，B 相电压 | 碰 5 V 前后不变 |
| 保持力矩、L1/L2、整步电流变化 | 均正常，说明功率级与拨码有效 |

结论：功率级与保持正常，但 A、B 两相电流均不随脉冲改变，判定驱动板脉冲输入或内部控制故障。
主板固件与接线无需修改，已安排购买新驱动器。

## 6. 新驱动器到货后的复测清单

- [ ] 核对电机铭牌：步距角、额定电流
- [ ] 按 2.2 或 2.3 接线；电源 12 V、限流 2 A；先空载确认驱动器电流
- [ ] 按驱动器资料把电流设到额定值的 50–70%，确认保持电流与温升
- [ ] 按 4.3 第 4 步手动碰 5 V，确认相电压会变化（或电机走步）
- [ ] 按 4.1 上电顺序运行模式 9，确认回原点方向与停在开关处
- [ ] 按 4.4 完成 10 mm／40 mm 位移标定、往返重复性、有效行程
- [ ] 更新本文第 1 节与 `configStepper.h` 中的实测参数

## 7. 已知限制

- 模式 9 下底盘中断未启动；整车联动时 GPT1 与 PIT 同为默认优先级，
  底盘 20 ms 任务执行期间脉冲会被推迟，高速联动前需评估提高 GPT1 优先级。
- K4 急停直接停脉冲、不减速，只适合低速台架测试。
- RMN28 没有使能脚，上电即锁轴，软件不能让电机脱机。
- Vref 与相电流的换算公式厂家未给出，1.15 V 只作相对设定。
- MDK 工程已登记新文件，但本机未安装 Keil，MDK 构建未验证。
