leo-lizx/transport-truck/docs/舵机接口方案A.md

# 舵机接口方案 A 记录（未实施）

> 日期：2026-10-20
> 状态：**仅记录，未改代码、未改接线**
> 目的：吸盘目前占用舵机接口 2（P17/D0）和 3（P18/D1），需要腾出一个接口给升降机构。
> 触发条件：用户确认要实施时，再按本记录改线与改固件。

## 1. 背景

主板三个标准舵机口：

| 接口 | 引脚 | 当前用途 |
|---|---|---|
| 舵机 1（P16） | C30，PWM4 子模块 2 A | 旋转舵机（BDS 系列） |
| 舵机 2（P17） | D0，PWM1 子模块 3 A | 泵电子开关信号 |
| 舵机 3（P18） | D1，PWM1 子模块 3 B | 阀电子开关信号 |

关键事实：两个电子开关的红、黑线接在 **P5（UART4）的 5V_EXT / GND**，舵机口只用到**信号脚**。因此把一个信号改到别的 PWM 引脚，就能整口腾出来，不需要改气路或换开关。

## 2. 方案 A 接线

| 线 | 现在 | 方案 A | 说明 |
|----|---|---|---|
| 泵白线 | P17.1（D0） | 不变 | PWM1 子模块 3 A，50 Hz |
| 泵红/黑 | P5 的 5V_EXT / GND | 不变 | |
| 阀白线 | P18.1（D1） | **D16**（右上“无线模块 UART”排针） | PWM1 子模块 2 A |
| 阀红/黑 | P5 的 5V_EXT / GND | 不变 | 若原本插在 P18 的 VCC/GND，必须移到 P5 |
| P18 | 被阀占用 | **空出** | 升降舵机：信号 P18.1（D1，PWM1 子模块 3 B），电源 VCC_Servo / GND |

改后资源分配：

```text
泵        D0  → PWM1 子模块 3 A  ┐ 同为 50 Hz，可共用周期
升降舵机  D1  → PWM1 子模块 3 B  ┘
阀        D16 → PWM1 子模块 2 A
旋转舵机  C30 → PWM4 子模块 2 A
```

## 3. 实施步骤（确认后再做）

1. 断电，拔掉泵阀负载电源。
2. 把阀白线从 P18.1 改插到 D16；用母对母杜邦延长，注意不要碰到 D17 / GND / 5V。
3. 确认阀的红/黑线在 P5 的 5V_EXT / GND。
4. 万用表确认 P5 5V_EXT 对 GND 约 5 V，D16 对 GND 无异常电压。
5. 改固件（见第 4 节），编译烧录。
6. 先不接负载，示波器测 D16：50 Hz、关约 544 µs、开约 2400 µs；D0 仍正常。
7. 接回泵阀，按原短按流程复测吸附与泄压。
8. 升降舵机装好后接 P18，先空载测行程。

## 4. 固件改动清单（尚未执行）

| 文件 | 改动 |
|---|---|
| `project/code/config/pinMap.h` | `SUCTION_VALVE_PWM_CHANNEL` 改为 `PWM1_MODULE2_CHA_D16` |
| `project/code/drv_suction.c` | 断言、AFIO（`IOMUXC_GPIO_SD_B0_04_FLEXPWM1_PWMA02`）、`PWM_Init` / `PWM_SetupPwm` 改用子模块 2；去掉“两路同帧装载”的假设与注释 |
| `docs/PINOUT.md` | 更新泵/阀/舵机口占用表 |
| `docs/吸盘模式4接线与测试.md` | 更新接线表、波形测试点与“同频同帧”描述 |
| `project/mdk/rt1064.uvprojx`、`project/iar/program/rt1064.ewp` | 无新增文件，通常不用改 |

验证要求：IAR 与 MDK 编译通过、吸盘主机测试 19 用例通过、示波器确认两路波形。

## 5. 风险与注意

- **D16 是无线模块 UART 的 TX（UART8）**。当前 `DEBUG_UART_ENABLE=0` 且未初始化 UART，所以可用；若以后恢复无线调试，应改用 D12/D13（PWM1 子模块 0）或 D14/D15（子模块 1）。
- **P18 的 VCC 是可调 VCC_Servo**，与 P16/P17 共用一路，不是固定 5 V；升降舵机接入后要核算两路舵机电流与电压。
- 阀和泵改到不同子模块后，**不再同一帧装载**；泄压“关泵→开阀→2 s→关阀”的机械先后要靠软件顺序与实测确认，不能沿用原同帧假设。
- 舵机口信号串有 100 Ω 电阻，D16 直连没有；电子开关输入为高阻，不影响。

## 6. 实施检查清单

- [ ] 用户确认实施
- [ ] 阀白线已改到 D16，红/黑在 P5
- [ ] 固件 pinMap / drv_suction 已改并编译通过
- [ ] 示波器确认 D16 与 D0 波形
- [ ] 吸盘主机测试通过
- [ ] 文档已同步
- [ ] 升降舵机接入 P18 前核对 VCC_Servo 电压与电流

## 7. 待确认

- **舵机型号**：2026-10-28 换用 **FeETech FS5323M 数字舵机**（此前 BDS300 记录保留为历史）。厂家参数：4.8–6V、500–2500µs、中位 1500µs、180°(±5°)、堵转 21.5kg·cm / 1.5A@6V、空载 0.16s/60°；最大 PWM 刷新率与 VCC_Servo 供电裕量仍待确认（Q-01）。
- 升降舵机的型号、脉宽范围、供电电压与行程尚未确定。

## 8. 相关文档

- [docs/PINOUT.md](PINOUT.md)：主板接口与占用
- [docs/吸盘模式4接线与测试.md](吸盘模式4接线与测试.md)：当前泵阀接线与测试
- [赛规与任务交接.md](../赛规与任务交接.md)：U-04 舵机型号、Q-01 资料待补
