leo-lizx/transport-truck/docs/吸盘模式4接线与测试.md

# 吸盘模式 4：C15 按住吸附、松手泄压

> 2026-10-17；适用 RT1064 主板 V3.0 和当前 `transport-truck` 工程。
> 当前默认模式为 4。底盘初始化后保持停止，原模式 1／2／3 的参数与航点不改。
> 已进行软件验证，尚未烧录或验证电子开关、泵阀和实际吸附。

## 1. 实现依据

用户提供的《真空泵吸盘工作原理及代码.pdf》第 1–2 页明确给出：电子开关红线接 5V，黑线接 GND，白线为控制信号；`Servo.write(0)` 关、`Servo.write(180)` 开。吸附时阀断电、泵运行；释放时泵停止、阀通电使吸盘通大气。

PDF 第 2 页示例使用 `Servo.h` 和默认 `attach(pin)`。本次依据 [Arduino 官方 Servo.h](https://github.com/arduino-libraries/Servo/blob/master/src/Servo.h) 与 [AVR 实现](https://github.com/arduino-libraries/Servo/blob/master/src/avr/Servo.cpp) 还原名义控制信号：

| 命令 | PWM 周期 | 高电平脉宽 | 说明 |
| --- | --- | --- | --- |
| 关 | 20ms，50Hz | 约 544μs | 对应默认 `write(0)` |
| 开 | 20ms，50Hz | 约 2400μs | 对应默认 `write(180)` |

这些是复现示例的初始波形，不是已测得的电子开关门限；MCU 输出有计数分辨率误差，原 Arduino 也有平台时序补偿。关指令仍持续发送脉冲，不是 0% 占空比或停止 PWM。

用户已确认松手后采用：**关泵、泄压 2 秒、关闭电磁阀**。PDF 正文与示例的先后顺序有差异，本模式沿用用户确认的关泵后泄压命令；两路 PWM 同帧装载，不保证阀和泵的机械响应先后。

## 2. 主板控制接线

C15 是板载按键，软件名为 K1，低电平表示按下；无需另接按钮。两个开关按 PDF 的三线定义接线：

| 接线对象 | 连接到主板 | 功能 |
| --- | --- | --- |
| 泵电子开关白线 | **P17 的 1 脚，D0** | PWM1 子模块 3 A，泵控制 |
| 阀电子开关白线 | **P18 的 1 脚，D1** | PWM1 子模块 3 B，阀控制 |
| 两个开关的红线 | **P5（UART4）的 1 脚，5V_EXT** | 按 PDF 的 5V 输入定义供电 |
| 两个开关的黑线 | **P5 的 2 脚，GND** | 开关与 MCU 共参考地 |
| P17 的 2 脚、P18 的 2 脚 | **不接** | 这是可调 VCC_Servo，不用于本次开关红线 |
| P5 的 3、4 脚 | 不接 | UART4 RX／TX 不参与本测试 |

**拆分单根线接对应针脚，不能把三线插头整排直接插进 P17／P18。** 其中间电源针是可调舵机电源，不能因为插头能插上就当成固定 5V。针号应按丝印和 [接口标注](PINOUT.md) 核对，不按图片左右位置猜。

D0、D1 属于同一 PWM 子模块，驱动统一初始化 A/B 两路且使用相同频率，占空比分别控制。不使用底盘 PWM2，不使用 C30，也不涉及 C30 的核心板 SD 电平选择跳线。

### 2.1 接线中的电气边界

- 先测量 P5.1 对 P5.2 的实际电压，确认与 PDF 的 5V 输入一致，再连接开关。P5.1 是板级时序控制的 5V_EXT，不是本次新配置的 UART 信号。
- D0／D1 输出是 MCU 约 3.3V 逻辑；PDF 没有写开关的输入门限，是否能可靠识别须实测，不能因为红线接 5V 就推定信号也应为 5V。若开关输入会向信号线拉出高于 MCU 允许值的电压，不能直接连接；应使用合适的单向电平转换。不要通过调高主板电压处理信号兼容问题。
- PDF 对开关的 3–5V 描述不能证明输出级可承受 12V，也没有明确控制电源和负载电源是否独立。红线 5V 的接法不构成泵阀负载电压已合格的证明，首次先不接泵阀负载。
- 已装好的原配“开关—泵／阀”连接保持原样并核对标识；未接好的负载端如无输入／输出／极性标识，不按照片猜线，也不向未确认端子另加 12V。
- 资料中泵额定 12V、可用 6–12V；阀额定 3.7V。确认模块输出与各自负载要求相符后再接负载。泵阀不能由 MCU 信号脚直接供电；整板带载电流能力尚未实测，不用 USB 单独承担泵阀负载。

## 3. 气管连接

按 PDF 的端口定义：阀的 **1 口接吸盘、3 口接泵吸气端、2 口通大气**。阀断电时 1 通 3，通电时 1 通 2。

优先保留原套件气管。若实物没有端口编号，需核对其实际通路再接，不按外形猜；泵的吸气端与排气端也不能接反。

## 4. 模式与操作表现

`main.c` 默认选择 `MAIN_RUN_MODE_SUCTION_TEST`，编号为 4；烧录前核对这一行。不要误用模式 2 的固件做吸盘测试。

| 操作／阶段 | 泵指令 | 阀指令 | 表现 |
| --- | --- | --- | --- |
| 软件初始化 | 关 | 关 | 先发送关闭指令，再进行底盘 IMU 标定 |
| 上电时一直按住 C15 | 关 | 关 | 必须先稳定松手才能解锁 |
| 解锁后按住 C15 | 开 | 关 | 阀连通吸盘与泵，持续吸附 |
| 松开 C15 | 关 | 开 | 吸盘通大气，开始计时 |
| 松开满 2 秒 | 关 | 关 | 阀恢复断电，不重复触发泄压 |
| 泄压期间再次按住 | 开 | 关 | 结束本次泄压，恢复吸附 |

按下和松开均经过约 20ms 的连续采样去抖。漏采或重复时间戳会重建去抖窗口；泄压计时使用累计节拍时间，主循环合并节拍不会把两秒延长成固定调用次数。

以上是软件命令行为。开关在 MCU 启动、复位、失去 PWM、调试暂停或单独掉电时的实际状态未知；不能把它们当作已验证的断电急停方式。首次接负载前先核对开关上电和失信号表现。

## 5. 首次测试步骤

1. **断电准备，先不接泵阀负载电源，两根白色信号线暂不接主板。** 核对红黑供电线、公共地，以及 P17.2／P18.2 确实未连接。先测 P5.1 电压，再断电接开关红黑线。核对模块负载端标识，不改底盘线序。
2. 打开 `project/iar/rt1064.eww`，配置选择 `nor_sdram_zf_dtcm`，确认 `main.c` 为模式 4，编译后由用户烧录。复位及初始化时保持车体静止，底盘应保持停止。
3. 先测控制端：如有示波器或逻辑分析仪，观察 D0／D1 同时有 20ms 周期，关指令约 544μs；解锁后按下 C15，D0 变约 2400μs、D1 保持关；松手后两路交换，2 秒后均为关。万用表平均电压不能替代脉宽检测。
4. 在白线与 MCU 分离时，检查模块白线有无外拉电压；高于 MCU 允许输入电压时不得直连。该测量不能单独证明 3.3V 控制兼容，仍需核对接口或用适配电路。确认可连接后，断电将两根白线分别接 D0／D1，再上电，在未带泵阀时确认开关能按命令切换，并核对上电、复位及失信号表现。没有波形仪器时，可观察开关指示及经标识确认的输出通断，但这不等于完成波形验证。无响应时先查供电、公共地、信号电平和模块制式，不直接提高电压。
5. 只有确认负载接线、输出电压与容量后，才接回原配泵阀及气管。首次每次按 **1–3 秒**：应有抽气；松手应停泵、泄压；约 2 秒后阀断电。先空载检查，再让吸盘贴合光滑平整物体测试静态吸放。
6. 检查方块是否真正吸住、松手后是否脱落。失败时先检查密封、气路与端口，再记录控制命令和实际表现；不要直接进入升降或旋转联动。

PDF 的泵连续工作限制存在 30／60 秒两种表述；本次没有擅自选一个作为自动热保护阈值。**此模式只做短按台架验证，没有长按超时保护。不要一直按住，也不要在泵运行时用断点暂停主循环。** 结束测试先释放并确认负载停止，再断开负载电源。

## 6. 文件与验证范围

| 文件 | 内容 |
| --- | --- |
| `project/code/drv_suction.c/h` | PWM1_SM3 双通道初始化及泵阀命令 |
| `project/code/app_suction_test.c/h` | C15 去抖、上电解锁、吸附与两秒泄压 |
| `project/code/config/configSuction.h` | 示例波形、去抖和泄压参数 |
| `project/code/config/pinMap.h` | 仅新增吸盘 D0／D1／C15 映射，底盘映射不改 |
| `project/user/src/main.c` | 模式 4 接入，保留 1／2／3 和原节拍 |
| `tests/suction/` | 真实应用文件配合硬件桩的主机行为测试 |

IAR 与 MDK 均为本轮验证工具链。2026-10-19 已补齐 MDK `code` 组的底盘源文件登记，MDK 5.43 完整构建通过（0 error）；此前“仅登记新增文件、未验证完整构建”的状态已解除。

2026-10-17 软件验证：模式 1／2／3／4 均通过 IAR `nor_sdram_zf_dtcm` 编译与链接；主机直接编译真实吸盘应用，19 个用例、205 条断言、0 失败。新增应用静态读写数据 17 字节；未改底盘、ISR 或 SDK。2026-10-19 修正 `chassis_pid.c` 调试打印的空表达式告警，IAR 重建 0 warning。

本模式没有负压、接触或货物反馈，只能发送泵阀命令，不能自动判断吸住、掉落或成功释放。编译及主机测试不等于上述接线、输出波形、电气兼容和气路已经通过实测。
