leo-lizx/transport-truck/.hecateflow/lessons/stepper-driver-supply-and-pulse.md

---
name: stepper-driver-supply-and-pulse
type: pitfall
trigger: "步进驱动器上电叫、电压被拉低、电机不走步；关键词：RMN28、Vref、限流、6V、不动、STEP/DIR、模式 9"
target: rt1064-main
severity: medium
status: active
created: 2026-11-11
---

# 步进驱动器：限流电源欠压、台架初始化卡死、脉冲无响应

## 症状

- 驱动器上电后发出音调逐渐升高的叫声；电源 12 V/1 A 实际被拉到约 6 V/1 A，限流 0.5 A 时仍是 6 V。
- 模式 9 第一版上电后滑台完全不动。
- 改版后 D12 实测有脉冲，但电机仍不走步。

## 根因

1. **欠压**：电位器出厂位置 Vref 2.13 V，相电流过大，电源进入限流；
   斩波驱动在低压下需要更大输入电流，电压被锁在启动阈值附近反复启停。
   电压不随限流值变化（1 A 和 0.5 A 都是 6 V）是区分它与电阻性短路的依据。
2. **初始化卡死**：模式 9 第一版仍调用 `chassis_ctrl_init()`，台架主板未接 IMU 时可能卡在初始化。
3. **驱动板损坏**：功率级与保持正常，但 A、B 两相电压在 P+ 手动碰 5 V 前后都不变，驱动器不响应脉冲。

## 证据

- 不接电机：12 V、0.012 A，驱动器空载正常；Vref 调到 1.15 V 后接电机：12 V、0.28 A。
- 整步时两相满电流，限流 1 A 再次被拉到 6 V，证明拨码有效、电流设定决定输入电流。
- 核心板 D12 发脉冲期间约 1.65 V（3.3 V 方波平均值），约 10 s 后变 0 V，与固件“找不到开关”停发一致；
  J1 P+/P- 同样约 1.65 V；P+/P- 对调、手动 3.3 V/5 V 均不动。
- 尚未证实：新驱动器下的整机运动、方向电平、步数换算。

## 如何避免

- 驱动器首次上电先**拔掉电机**测空载电流，再接电机；限流按驱动器资料设置（RMN28 为 2 A）。
- 有 Vref 测试点时先测再调，确定电位器方向；从低电流起步。
- 单模块台架测试模式只初始化该模块，不调用底盘/IMU 初始化，节拍改用独立 PIT 通道。
- “不动”按信号流向分段测：Live Watch → MCU 引脚 → 驱动器输入 → 相电压 → 电机单独通电。
  相电压不随脉冲变化即可判定驱动器问题，不必再改固件或接线。

## 关联

- 文档：`docs/升降步进模式9接线与测试.md`
- 代码：`project/code/drv_stepper.c`、`project/code/app_stepper_test.c`、`project/code/config/configStepper.h`、`project/user/src/main.c`
