leo-lizx/transport-truck/.hecateflow/lessons/stale-flash-after-pin-change.md

---
name: stale-flash-after-pin-change
type: pitfall
trigger: "换舵机/PWM 引脚、切换运行模式、外设不动作时；关键词：不转、无输出、C30、P17、烧录、接线、100Ω"
target: rt1064-main
severity: high
status: active
created: 2026-10-21
---

# 换引脚或模式后未同步烧录产物与接线，误判为硬件故障

## 症状(怎么暴露的)

- 模式 5（BDS300 舵机）改到 P16/C30 后舵机不转；同一只舵机在 P17/D0 上正常。
- P16 排针的 C30 对 GND 实测约 3 V，不符合 300 Hz、45% 占空比应有的约 1.5 V。
- 蜂鸣档测“核心板 C30 ↔ P16.1”不响，一度被当作断线；但 R41、R42 实测均为 100 Ω。

## 根因(为什么会这样)

- 决定性对照：新增模式 7（C30、300 Hz、官方公式）后舵机可转，证明 C30、PWM4、300 Hz 都正常。
- 因此当时运行的不是“模式 5 + C30 + 300 Hz”这一版固件，或舵机信号线并未真正接在 P16。
  排针上的 3 V 是悬空电平，不是 PWM 输出。
- 次要原因：舵机信号串联 100 Ω（R41），蜂鸣档门限低于 100 Ω 时不会响，造成“断路”的假阴性。

## 证据与二次确认

- 已证实事实：模式 7（C30、300 Hz、官方公式）实测可转；官方例程本身可用（用户确认）；
  R41、R42 均为 100 Ω；核心板 J1（SD 电平跳线）未焊接。
- 被推翻的说法：此前推断的“C30 硬件通路故障 / J1 占用 / P16 排针断路”，均无证据支持。
- 二次确认动作：模式 5 改回 C30/300 Hz 后重新 Rebuild All + Download 复测（待执行）。
- 仍未证实的假设：当时的具体原因是“旧产物未重烧”还是“信号线仍插在 P17”，二者只居其一或同时存在。

## 如何避免(下次怎么不再犯)

- 换引脚或换模式后必须 Rebuild All，确认下载的是新产物（对比构建时间或产物大小），不要只按 Download。
- 固件引脚与物理接线必须同时改；确认信号线真的插在目标排针，而不是只改了宏。
- 外设不动作时先测 MCU 侧是否有波形/电压，再测排针侧；悬空电平不能当作 PWM。
- 测串联电阻或通路用电阻档；蜂鸣档对 100 Ω 可能不响。
- 保留一个“最小对照模式”（本次的模式 6/7，验证后已删除）用于隔离引脚与频率变量。
- 升级路径：必要时把“换引脚后 Rebuild All + 核对接线”加入提交前检查清单，不单独升为强制规则。

## 关联

- 相关文档：`docs/舵机接口方案A.md`、`docs/PINOUT.md`
- 相关代码：`project/code/config/pinMap.h`、`project/code/drv_servo.c`、`project/code/config/configServo.h`
- 相关 skill：`hf-lessons`（capture）、`docs/Git提交流程.md`
