leo-lizx/transport-truck/代码编写与变更规范.md

# 代码编写与变更规范

> 适用对象：项目开发者、代码审查者及 AI 编码助手。  
> 目标：以最少且明确的改动解决真实问题，使代码易理解、易验证、易修改、易删除。  
> 调研日期：2026-06-25。

## 1. 规则优先级

发生冲突时，按以下顺序执行：

1. 用户或任务中明确写出的需求。
2. 项目现有接口、测试、文档和行为约束。
3. 当前目录及模块已有的设计与编码惯例。
4. 本文档中的通用规则。
5. 个人偏好。

不得用个人偏好覆盖已经明确的项目约束。

## 2. 核心原则

### 2.1 先理解，后修改

- 修改前必须阅读相关入口、调用链、数据结构、测试和配置。
- 必须先确认问题发生的位置、预期行为和改动边界。
- 不得只看局部代码便假设整个系统的工作方式。
- 需求存在关键歧义时，应先列出已知事实和待确认项；不得自行补全会影响行为的需求。

### 2.2 只实现已确认需要的功能

遵循 YAGNI：当前没有明确需求、测试、缺陷或可验证场景支撑的功能，不实现。

开始编码前必须回答：

1. 该功能是否由当前需求明确要求？
2. 现有代码是否已经提供相同或足够接近的能力？
3. 不增加新功能，能否通过配置、组合或小范围修改解决？
4. 新增内容是否有实际调用方和验收方式？

如果第 1、4 项为“否”，原则上不编写该功能。

禁止：

- 猜测用户将来可能需要什么并提前实现。
- 为未知场景预留大量参数、接口、扩展点或抽象层。
- 顺手增加未被要求的日志、缓存、重试、兼容层、命令行选项或界面功能。
- 创建没有实际调用方的公共 API。
- 以“以后可能有用”为理由保留死代码。

### 2.3 最小必要改动

- 一次变更只解决一个明确问题。
- 优先修改最少的文件、接口和代码路径。
- 不得夹带无关重构、全文件格式化、重命名或依赖升级。
- 修复局部问题时，不得无依据地重写整个模块。
- 能删除旧逻辑时，不应同时保留新旧两套实现，除非兼容性要求明确存在。
- 改动规模开始膨胀时，应停止编码，重新判断是否混入了第二个问题。

“最小”不等于草率：为保证正确性而必须同步修改的测试、文档、类型和错误处理，属于必要改动。

### 2.4 简单优先

- 优先选择最容易读懂、验证和维护的正确方案。
- 可读的直接实现优于技巧性写法。
- 清晰的数据流优于隐式副作用。
- 标准库和项目已有能力优于重复造轮子。
- 不因微小的代码重复立即抽象；只有当重复代表同一稳定概念，并且抽象能降低维护成本时才提取。
- 不做未经测量的性能优化；性能修改必须有瓶颈依据和对比结果。

## 3. 模块化设计

模块化的目的不是制造更多文件，而是隔离变化、降低耦合。

### 3.1 单一职责

- 一个模块、类或函数应围绕一个清晰职责组织。
- 同一功能的数据定义、核心逻辑和外部适配应有明确边界。
- 业务逻辑不应依赖界面、设备、网络或文件格式的偶然细节。
- 修改一种行为不应迫使无关模块一起变化。

### 3.2 高内聚、低耦合

- 相关逻辑放在一起，不相关逻辑分开。
- 通过最小且明确的接口交换数据。
- 不跨模块读取或修改对方内部状态。
- 避免全局可变状态、隐藏依赖和循环依赖。
- 依赖方向应稳定、清楚，底层通用模块不得反向依赖具体业务模块。

### 3.3 模块拆分判断

满足以下任一条件时，应考虑拆分：

- 一段代码存在两个以上独立变化原因。
- 单个函数需要同时处理解析、业务决策和外部写入。
- 某部分可以被独立测试，且边界自然。
- 新功能持续向同一条件分支堆叠。
- 阅读者必须同时理解多个无关概念才能修改其中一个。

以下情况不应强行拆分：

- 代码很短，职责单一，拆分只会增加跳转。
- 抽象只有一个调用方，且没有形成稳定概念。
- 需要通过大量参数传递才能维持人为边界。

### 3.4 接口设计

- 接口只暴露调用方当前需要的能力。
- 参数和返回值必须表达真实语义，避免无边界的字典、魔法数字和布尔参数堆叠。
- 公共接口应保持稳定；优先调整内部实现。
- 新增公共接口时，必须同时提供实际使用点或测试，避免提交未使用的 API。
- 错误必须在合适的边界处理，不得静默吞掉异常或返回含义不明的状态值。

## 4. 编码可读性

### 4.1 命名

- 名称应准确表达用途、单位、方向或状态。
- 避免无意义缩写，以及 `data`、`temp`、`obj`、`flag` 等缺少上下文的名称。
- 布尔值使用可直接判断真假的名称，如 `is_ready`、`has_target`、`should_retry`。
- 同一概念在不同模块中应使用一致术语。
- 名称应足够清楚，但不应重复上下文造成冗长。

### 4.2 函数与控制流

- 函数保持聚焦，输入、输出和副作用清晰。
- 优先使用提前返回减少深层嵌套。
- 复杂条件应拆成有名称的中间判断。
- 避免一个函数既计算结果又隐式修改多个外部对象。
- 重复的错误处理和资源释放应使用语言原生机制统一管理。
- 不使用炫技式表达式压缩本应清楚展开的逻辑。

### 4.3 常量与数据结构

- 有业务含义的数值、字符串和状态应定义为具名常量或枚举。
- 数据结构应表达约束，避免让非法状态轻易出现。
- 单位必须在名称、类型或注释中明确。
- 不得为了“灵活”而用弱结构数据替代清晰模型。

## 5. 注释与文档

注释用于补充代码无法表达的信息，而不是逐行翻译代码。

### 5.1 应当注释

- 为什么选择当前方案，以及放弃其他方案的关键原因。
- 硬件、协议、算法、时序或兼容性方面的非显然约束。
- 容易被误删但实际必要的特殊处理。
- 复杂算法的核心思路、输入假设和边界条件。
- 公共模块、公共函数和公共数据结构的用途、契约及副作用。
- 临时方案的原因、退出条件和可追踪事项。

### 5.2 不应注释

- 代码已经直接表达的“做了什么”。
- 与当前实现不一致的旧说明。
- 没有负责人、条件或依据的模糊 TODO。
- 被注释掉的旧代码；版本控制已经保存历史。
- 用长注释掩盖难以理解的代码。应先简化代码，再补充必要原因。

### 5.3 注释维护

- 修改代码时必须同步检查附近注释、示例和文档。
- 注释失效比没有注释更危险；无法保证正确时应修正或删除。
- 文档中的命令、参数和路径应可实际执行或定位。

## 6. 兼容性与安全边界

- 未经明确要求，不改变现有公共接口、文件格式、通信协议、默认值和用户可见行为。
- 必须检查调用方，确认改动不会破坏既有流程。
- 输入边界执行必要校验，错误信息应说明失败原因和相关上下文。
- 不记录密钥、令牌、密码及不必要的个人数据。
- 不通过关闭校验、吞掉异常或扩大权限来“修复”问题。
- 涉及并发、内存、文件覆盖、设备控制或网络重试时，必须显式考虑失败路径和资源释放。

## 7. 测试与验证

每项改动都必须有与风险相称的验证。

### 7.1 基本要求

- 新增行为：增加能证明该行为的测试。
- 修复缺陷：优先增加一个修改前失败、修改后通过的回归测试。
- 修改接口：验证所有已知调用方。
- 修改配置或文档：验证示例命令、路径和关键参数。
- 无法自动测试时：记录手工验证步骤、结果及未覆盖风险。

测试应：

- 在实现错误时确实失败。
- 聚焦可观察行为，而非过度绑定内部实现。
- 覆盖正常路径、关键边界和合理失败路径。
- 保持简单、独立、可重复。

不得为了让测试通过而删除有效断言、放宽正确性条件或跳过失败测试。

### 7.2 验证范围

按以下顺序执行：

1. 与改动最直接相关的测试。
2. 所属模块的测试。
3. 类型检查、静态分析和格式检查。
4. 风险较高或影响较广时运行完整测试。

如果验证未全部执行，交付说明中必须明确指出。

## 8. 标准工作流程

### 8.1 修改前

1. 用一句话重述要解决的问题。
2. 列出明确要求、明确不要求和仍不确定的部分。
3. 阅读相关代码、测试、文档和调用方。
4. 判断是修复现有行为，还是确实需要增加新功能。
5. 选择满足需求的最小实现路径。
6. 预先确定验证方法。

### 8.2 修改中

1. 保持改动围绕单一目标。
2. 沿用项目现有结构、命名和错误处理方式。
3. 必要时按职责拆分，但不提前构建未知扩展能力。
4. 添加解释“为什么”的必要注释。
5. 同步更新受影响的测试和文档。
6. 随时检查是否误改用户已有内容或无关文件。

### 8.3 修改后

1. 查看完整差异，确认每一行都服务于当前需求。
2. 删除调试输出、未使用代码、临时文件和无依据 TODO。
3. 检查是否引入重复实现、隐藏副作用或不必要依赖。
4. 执行相关测试和检查。
5. 总结改了什么、为何这样改、如何验证以及剩余风险。

## 9. 功能必要性决策表

| 判断 | 处理方式 |
|---|---|
| 需求明确，现有能力不足，有可验证场景 | 实现最小功能并测试 |
| 需求明确，现有能力可以复用或组合 | 复用现有能力，不新增重复功能 |
| 需求不明确，但不影响核心实现 | 采用最保守且可逆的默认处理，并说明假设 |
| 需求不明确，且不同选择会改变接口或行为 | 暂停该部分，先确认需求 |
| 只是推测未来可能需要 | 不实现 |
| 与当前任务无关但发现代码可优化 | 记录建议，不夹带修改 |
| 必须大范围重构才能实现 | 先说明原因、范围和风险，再决定是否继续 |

## 10. 代码审查清单

提交或交付前逐项检查：

- [ ] 改动只解决当前明确问题。
- [ ] 没有实现猜测中的未来需求。
- [ ] 没有无关重构、格式化或依赖变更。
- [ ] 模块职责清楚，依赖和数据流易于追踪。
- [ ] 抽象来源于真实重复或稳定边界，而非预想。
- [ ] 名称准确，控制流简单，没有不必要的技巧。
- [ ] 注释解释原因和约束，且与代码一致。
- [ ] 公共接口和既有行为未被意外破坏。
- [ ] 错误路径、边界条件和资源释放已考虑。
- [ ] 测试能证明改动有效，并且相关检查已经通过。
- [ ] 文档、示例和配置已按需同步。
- [ ] 差异中的每一行都能说明其必要性。

## 11. 给 AI 编码助手的强制指令

AI 执行编码任务时必须遵守：

1. 不猜测未提供的业务功能。
2. 不因“看起来更完整”而扩大实现范围。
3. 在新增函数、模块、配置项或依赖前，先证明现有能力无法满足需求。
4. 关键需求不明确时，不得暗自选择会影响公共行为的方案。
5. 不得覆盖、回滚或整理与任务无关的现有改动。
6. 不得声称测试通过，除非实际执行并获得成功结果。
7. 无法验证时必须明确说明，而不是假定正确。
8. 优先提交小而完整的改动；较大任务应拆为可独立理解和验证的阶段。
9. 发现更大问题时先报告，不借当前任务擅自修复。
10. 最终说明必须包含：改动内容、设计依据、验证结果和已知限制。

## 12. 理念来源

本文档将以下 GitHub 开源工程实践转化为可执行约束：

- [Google Engineering Practices](https://github.com/google/eng-practices)：强调单一目标的小变更、避免过度设计、代码健康、清晰命名、有效测试，以及注释主要解释“为什么”。
- [Microsoft Skills - Agents.md](https://github.com/microsoft/skills/blob/main/Agents.md)：采用“澄清需求—测试定义成功—最少实现—重构—完整验证”的开发闭环。
- [Reth Development Guide for AI Agents](https://github.com/paradigmxyz/reth/blob/main/AGENTS.md)：大型工程通过明确模块边界、项目命令和验证流程约束 AI 变更。
- [Microsoft Semantic Link Labs - AGENTS.md](https://github.com/microsoft/semantic-link-labs/blob/main/AGENTS.md)：强调先理解、不要假设、保持兼容、最小修改并遵循已有模式。
- [Programming Principles](https://github.com/webpro/programming-principles)：汇总 KISS、YAGNI、关注点分离、高内聚低耦合、面向维护者编码和避免过早优化等原则。
- [GitHub Awesome Copilot](https://github.com/github/awesome-copilot)：体现现代 AI 编码规则通过仓库级说明、按范围加载和可执行验证命令落地的趋势。

这些来源提供理念与参考，实际开发仍应以当前项目的明确需求、已有架构和可验证行为为准。
