leo-lizx/transport-truck/docs/hardware/RT1064_V3.0接口标注.png

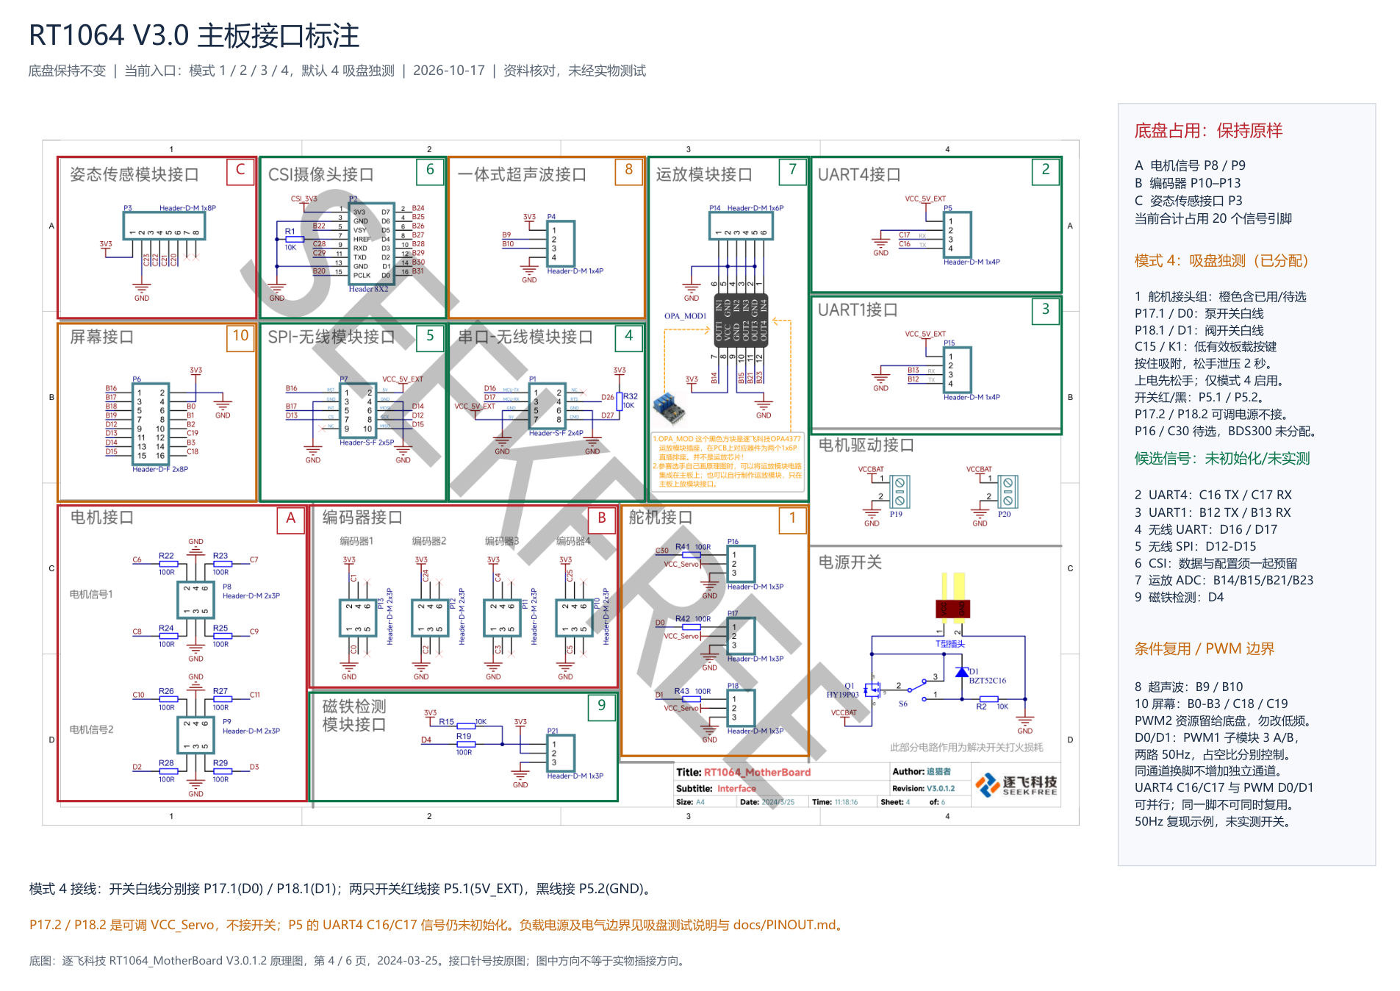
docs/hardware/RT1064_V3.0接口标注.png
