leo-lizx/transport-truck/project/code/config/configChassis.h

#ifndef _CONFIG_CHASSIS_H_
#define _CONFIG_CHASSIS_H_

#include <stdint.h>

/*
 * RT1064 底盘 参数调节头(configChassis) — 编译期参数单一真相源
 *
 * 集中原散落在 chassis_config.h 的控制参数与时序宏，按 § 分节组织。
 * 引脚集中在 pinMap.h (本文件不含引脚)。
 *
 * 量纲约定 (防数量级混用):
 *   轮速域  = 编码器脉冲/20ms (PID 增益吸收尺度，无物理换算)
 *   几何    = 米 (m)
 *   角速度  = 度/秒 (°/s)
 *   角度    = 度 (°)
 *   时序    = µs / ms / tick
 *   PWM     = 原始单位 (0 ~ PWM_DUTY_MAX = 10000)
 *   电流    = ADC 原始量 (如有)
 *
 * 上电参数语义: 编译期宏 = 唯一真相源；
 *   运行时 RAM 镜像 (g_chassis_tune_params) 为可调子集，
 *   由上述宏初始化并经过安全限幅；菜单不从 Flash 覆盖参数。
 *
 * 分节索引:
 *   §A 调度时序与模式
 *   §B 轮速环 PID (四轮独立，Kp 全正号)
 *   §C 位置/航向环 (导航层)
 *   §D IMU / 卡尔曼滤波 / 编码器融合
 *   §E 几何 + 限幅 + 滤波 + 静摩擦前馈 + 里程计
 *   §极性 方向系数单一真相源 (执行器/编码器/IMU *_DIR)
 *   §F 视觉融合 / 发车区&越界 / 故障保护
 */

/* ============================================================
 * §A 调度时序与模式
 * ============================================================ */

/** 5ms 任务周期 (秒)，IMU 角速度读取和航向角积分 */
#define CHASSIS_TASK_DT_5MS_S               (0.005f)

/** 20ms 任务周期 (秒)，编码器测速、PID 轮控、位置控制 */
#define CHASSIS_TASK_DT_20MS_S              (0.020f)

/** 圆周率 π */
#define CHASSIS_PI_F                        (3.1415926f)

/** 角度 → 弧度: rad = deg × DEG_TO_RAD */
#define CHASSIS_DEG_TO_RAD_F                (CHASSIS_PI_F / 180.0f)

/** 弧度 → 角度: deg = rad × RAD_TO_DEG */
#define CHASSIS_RAD_TO_DEG_F                (180.0f / CHASSIS_PI_F)

/** 电机 PWM 载波频率 (Hz)，DRV8701E 推荐 10k~100kHz */
#define CHASSIS_MOTOR_PWM_FREQ_HZ           (17000U)

/** PWM 占空比数值上限 */
#define CHASSIS_MOTOR_PWM_MAX               ((float)PWM_DUTY_MAX)

/* ============================================================
 * §B 轮速环 PID (四轮独立，Kp 全正号)
 *
 *   极性补偿已下沉到 §极性 方向系数，Kp 不兼任极性翻转器
 *   (避免负号反直觉 / 误改即正反馈失控)。
 *
 *   4 轮硬件差异应通过 ENCODER_*_DIR / MOTOR_*_OUTPUT_DIR 标定，
 *   不该让 PID 背锅。四轮 PID 统一: 阶跃响应同步，不扭不抖。
 * ============================================================ */

/** 轮速 PID 默认比例增益 Kp (作为各轮初值模板) */
#define CHASSIS_WHEEL_PID_DEFAULT_KP        (120.0f)

/** 轮速 PID 默认积分增益 Ki */
#define CHASSIS_WHEEL_PID_DEFAULT_KI        (8.0f)

/** 轮速 PID 默认微分增益 Kd */
#define CHASSIS_WHEEL_PID_DEFAULT_KD        (1.0f)

/* ---- 左前轮 LF (Wheel 0) ---- */
#define CHASSIS_WHEEL_PID_LF_KP             (200.0f)
#define CHASSIS_WHEEL_PID_LF_KI             (50.0f)
#define CHASSIS_WHEEL_PID_LF_KD             (10.0f)

/* ---- 右前轮 RF (Wheel 1) ---- */
#define CHASSIS_WHEEL_PID_RF_KP             (200.0f)
#define CHASSIS_WHEEL_PID_RF_KI             (50.0f)
#define CHASSIS_WHEEL_PID_RF_KD             (10.0f)

/* ---- 左后轮 LB (Wheel 2) ---- */
#define CHASSIS_WHEEL_PID_LB_KP             (200.0f)
#define CHASSIS_WHEEL_PID_LB_KI             (50.0f)
#define CHASSIS_WHEEL_PID_LB_KD             (10.0f)

/* ---- 右后轮 RB (Wheel 3) ---- */
#define CHASSIS_WHEEL_PID_RB_KP             (200.0f)
#define CHASSIS_WHEEL_PID_RB_KI             (50.0f)
#define CHASSIS_WHEEL_PID_RB_KD             (10.0f)

/* ---- 兼容宏 (旧名称) ---- */
#define CHASSIS_WHEEL_PID_KP                CHASSIS_WHEEL_PID_DEFAULT_KP
#define CHASSIS_WHEEL_PID_KI                CHASSIS_WHEEL_PID_DEFAULT_KI
#define CHASSIS_WHEEL_PID_KD                CHASSIS_WHEEL_PID_DEFAULT_KD

/* ============================================================
 * §C 位置/航向环 (导航层，Kp 全正号)
 * ============================================================ */

/* ---- 用户常调参数 (优先调下面几个) ---- */

/** 航向 sqrt_controller 线性段 P 增益 (°/s per °): 近目标时的响应
 *  sqrt_controller 保证远处时间最优、近处线性平滑, 不会超调 */
#define CHASSIS_YAW_KP                      (10.0f)

/** sqrt_controller 最大减速度 (°/s²): 决定刹车距离 */
#define CHASSIS_YAW_ACCEL_MAX_DPS2          (1000.0f)

/** 最大旋转速度 (°/s) */
#define CHASSIS_MAX_YAW_SPEED_DPS           (400.0f)

/* ---- 内环速率 PI (角速度跟踪) ---- */

/** 1=级联 sqrt+PI, 0=回退单环 PID */
#define CHASSIS_YAW_USE_CASCADED_CTRL       (1)

/** 1=移动时开启内环速率 PI (叠加到 wz_target), 0=移动时只用外环 sqrt_ctrl
 *  静止保持 (MODE_YAW_HOLD) 不受此宏影响, 始终开启内环 PI. */
#define CHASSIS_YAW_RATE_PI_MOVE_ENABLE     (1)

/** 内环 P: rate_err(°/s) → wz 修正 (°/s).
 *  0.30 在跟踪精度和噪声放大之间平衡: MPC 输出 100dps 时, KP 贡献 30dps 修正. */
#define CHASSIS_YAW_RATE_KP                 (0.30f)

/** 内环 I 增益: ∫rate_err → wz 修正. 自动克服静摩擦.
 *  0.80 配合 I_LEAK=0.001: 稳态偏航力矩被持续抵消, 1~2°静差不再残留. */
#define CHASSIS_YAW_RATE_KI                 (0.10f)

/** 内环 I 上限 (°/s): 积分最多贡献的角速度 */
#define CHASSIS_YAW_RATE_I_LIMIT            (40.0f)

/** 内环 PI 总输出限幅 (°/s): kp_v + ki_v 的硬上限, 防止 PI 过度修正喧宾夺主 */
#define CHASSIS_YAW_RATE_PI_LIMIT_DPS       (40.0f)

/** 内环 I 泄漏系数: 每拍 I *= 1-LEAK, 防卷绕且自然衰减 */
#define CHASSIS_YAW_RATE_I_LEAK             (0.01f)

/* ---- 到位锁 ---- */

/** 进入在位锁: |err| < 此值 */
#define CHASSIS_YAW_INPOS_ENTER_DEG         (0.60f)

/** 退出在位锁: |err| > 此值 */
#define CHASSIS_YAW_INPOS_EXIT_DEG          (0.80f)

/** 移动中重新对正阈值: |err| 达到此值时立即停止平移并原地校正。
 *  ENTER~REALIGN 之间按误差线性降低平移速度，兼顾速度与航向保持。 */
#define CHASSIS_YAW_MOVE_REALIGN_DEG         (10.0f)

/** 即位锁需车体稳定: |rate| < 此值 */
#define CHASSIS_YAW_INPOS_SETTLE_DPS        (10.0f)

/** Point-navigation arrival uses a stricter yaw-rate limit than the in-position lock. */
#define CHASSIS_YAW_ARRIVAL_SETTLE_DPS      (2.0f)

/** 定点导航到位时的航向容差 (度): 比原地锁的 0.6° 宽，
 *  避免 IMU 零偏/齿隙让航向条件长期不满足而卡住到位判定。 */
#define CHASSIS_YAW_ARRIVAL_TOL_DEG         (1.5f)

/* ---- 小角度原地旋转静摩擦前馈 ----
 * 通用四轮 breakaway 前馈负责平移和大角度起步；以下参数只在
 * vx/vy 近零且航向误差不超过 MAX_ERR 时替换它，原有线性 yaw 前馈仍叠加。
 * 保留足够的静止起步 PWM，同时用真实小轮速快速衰减，避免到位附近持续
 * 施加较大 PWM，并避免车轮尚未停稳时立刻施加反向大前馈。 */
#define CHASSIS_YAW_SMALL_ANGLE_FF_MAX_ERR_DEG    (5.0f)
#define CHASSIS_YAW_SMALL_ANGLE_FF_TARGET_EPS_MPS (0.005f)
#define CHASSIS_YAW_SMALL_ANGLE_FF_PWM_FLOOR      (700.0f)
#define CHASSIS_YAW_SMALL_ANGLE_FF_FB_DECAY_MPS   (0.03f)

/** 角速度加减速限制 (°/s²): 同时用于 yaw sqrt 曲线和下游 ramp */
#define CHASSIS_CMD_ACCEL_LIMIT_DPS2        (5000.0f)

/* ---- 网格 & 场地参数 ----
 *   比赛地图 16×12，最外圈不可进入；可通行 14×10，对应 3.2m×2.4m
 *   全局坐标 X∈[0,3.20m], Y∈[0,2.40m]
 */
#define CHASSIS_GRID_MAX_X                  (15U)
#define CHASSIS_GRID_MAX_Y                  (11U)
#define CHASSIS_GRID_COLS                   (CHASSIS_GRID_MAX_X + 1U)
#define CHASSIS_GRID_ROWS                   (CHASSIS_GRID_MAX_Y + 1U)
#define CHASSIS_GRID_INNER_MIN_X            (1U)
#define CHASSIS_GRID_INNER_MAX_X            (CHASSIS_GRID_MAX_X - 1U)
#define CHASSIS_GRID_INNER_MIN_Y            (1U)
#define CHASSIS_GRID_INNER_MAX_Y            (CHASSIS_GRID_MAX_Y - 1U)
#define CHASSIS_GRID_INNER_COLS             (CHASSIS_GRID_INNER_MAX_X - CHASSIS_GRID_INNER_MIN_X + 1U)
#define CHASSIS_GRID_INNER_ROWS             (CHASSIS_GRID_INNER_MAX_Y - CHASSIS_GRID_INNER_MIN_Y + 1U)

/** 可通行区域物理宽度 (米) */
#define CHASSIS_MAP_WIDTH_M                 (2.80f)

/** 可通行区域物理高度 (米) */
#define CHASSIS_MAP_HEIGHT_M                (2.00f)

/** X 方向单步步长 (米) = 2.80 / 14 */
#define CHASSIS_GRID_STEP_X_M               (CHASSIS_MAP_WIDTH_M / (float)CHASSIS_GRID_INNER_COLS)

/** Y 方向单步步长 (米) = 2.00 / 10 */
#define CHASSIS_GRID_STEP_Y_M               (CHASSIS_MAP_HEIGHT_M / (float)CHASSIS_GRID_INNER_ROWS)

/** 最外围墙在 X/Y 方向的物理厚度：各占一个网格 */
#define CHASSIS_FIELD_MARGIN_X_M            (CHASSIS_GRID_STEP_X_M)
#define CHASSIS_FIELD_MARGIN_Y_M            (CHASSIS_GRID_STEP_Y_M)

/** 兼容旧代码 (不建议新代码使用) */
#define CHASSIS_GRID_CELL_SIZE_M            CHASSIS_GRID_STEP_X_M

#define CHASSIS_START_GRID_X                CHASSIS_GRID_INNER_MIN_X
#define CHASSIS_START_GRID_Y                (6U)  /* 5×0.20=1.00m，与实测车中心吻合 */

/* ---- 导航：到位/保持/制动 ---- */

/** 到达目标点判定阈值 (米): 纯位置窗口；速度、航向和驻留在下游独立确认。
 *  必须大于制动包络的停车距离：BRAKE_FLOOR 0.20 m/s 时
 *  v*latency + v²/(2a) + margin ≈ 2.9 cm，窗口过小会停在窗外反复修正，
 *  表现为“到位判断很久/一直不到达”。 */
#define CHASSIS_TARGET_REACHED_EPSILON_M    (0.030f)

/** 到位驻留确认次数 (20ms/次): 连续 N 次同时满足位置+速度+角度条件才判到达。
 *  单拍 odom 噪声/瞬态过冲可能让 dist 瞬间掉进 EPSILON, 不加驻留会误触到达。
 *  8 次 = 160ms；低速零目标停轮门控负责消除 PID 残留输出。 */
#define CHASSIS_ARRIVAL_DWELL_COUNT         (2U)

/** 到位后 Schmitt 滞后释放阈值 (米): 1cm 进入、5cm 退出，避免噪声重启位置环。 */
#define CHASSIS_POS_HOLD_EXIT_M             (0.05f)

/** 到位后 yaw 容忍带 (°) — |yaw_err| < 该值即硬归零
 *  P0-修复 2026-06-30: 0.40→1.00。原值 0.40 与 inpos enter 0.50 过近,
 *  硬归零→漂出→重新激活→拉回的循环造成目标点抖动。
 *  1.00=inpos 退出阈值, 两个行为一致, 消除硬切换。 */
//#define CHASSIS_YAW_GOAL_TOLERANCE_DEG      (0.500f)

/* ---- 导航增益 ---- */

/** X 方向位置环 Kp — 沿程方向增益。保留旧宏名以兼容运行时调参接口。
 *  P0-调参 2026-05-08: 2.50→3.50，加快远场逼近
 *  P0-修复 2026-05-11 (拐点停留+走斜线): 10.50→4.50
 *  (KP=10.5 时 linear_dist=accel/KP²≈0.027m → 冲过头) */
/* 2026-07-29 提速: 6.00→6.60，近端位置曲线提高约 10%。 */
#define CHASSIS_POS_KP                      (6.60f)

/** Y 方向位置环 Kp — Y 轴机械特性独立，允许与 X 分别调节。 */
#define CHASSIS_POS_Y_KP                    (4.0f)

/** Runtime safety limit for position-loop Kp; must cover the compile-time default. */
#define CHASSIS_TUNE_POS_KP_LIMIT           (10.0f)

/** X 方向位置环积分增益 — 消除静摩擦稳态残差。从 0 起调，+0.05/次 */
/* P0-修复 2026-07-17: 0.30→0.50, 近端更快累积克服静摩擦, 缩短末段停留 */
#define CHASSIS_POS_KI                      (0.80f)

/** Y 方向位置环积分增益 — 初值与 X 相同，后续可独立调节。 */
#define CHASSIS_POS_Y_KI                    (0.60f)

/** X 方向线速度最大加速度 (m/s²)；保留旧宏名兼容现有调参接口。
 *  P0-调参 2026-05-08: 3.00→5.00，加快爬坡/刹车
 *  2026-07-29 提速: 5.00→5.80，中距离斜坡提高约 16%。 */
#define CHASSIS_CMD_ACCEL_LIMIT_MPS2        (6.80f)

/** Y 方向线速度最大加速度 (m/s²)；独立于 X，按 Y 方向实车响应调节。 */
#define CHASSIS_CMD_ACCEL_LIMIT_Y_MPS2      (8.90f)

/** 在线调参时 X/Y 线加速度的安全上限 (m/s²)。 */
#define CHASSIS_TUNE_MAX_LINEAR_ACCEL_X_MPS2 (7.0f)
#define CHASSIS_TUNE_MAX_LINEAR_ACCEL_Y_MPS2 (9.0f)

/* 20cm 短程起步使用更高加速度；仅在实测停车距离仍有余量时启用。 */
#define CHASSIS_SHORT_MOVE_DIST_M                  (0.25f)
#define CHASSIS_CMD_SHORT_ACCEL_LIMIT_MPS2         (10.0f)
#define CHASSIS_CMD_SHORT_ACCEL_LIMIT_Y_MPS2       (12.0f)

/* 主动制动减速度独立于加速度，通过轮速目标快速回落驱动 PID 制动。 */
#define CHASSIS_CMD_BRAKE_DECEL_LIMIT_MPS2         (12.0f)
#define CHASSIS_CMD_BRAKE_DECEL_LIMIT_Y_MPS2       (13.0f)

/* 动态停车距离补偿：覆盖一次轮速低通约 37ms 与 20ms 控制/执行延迟。 */
#define CHASSIS_DYNAMIC_BRAKE_LATENCY_S             (0.060f)
#define CHASSIS_DYNAMIC_BRAKE_MARGIN_M              (0.015f)

/* ---- 位置环自动推导比例常量 (用户一般无需修改) ----
 *   kd_eff = pos_kp * KD_RATIO        (主轴速度阻尼)
 *   kd_hold = pos_kp * HOLD_KD_RATIO  (保持轴轻阻尼)
 *   i_limit = v_max * I_LIMIT_RATIO   (积分最多贡献比例)
 *   i_band  = brake_dist * I_BAND_RATIO (只在减速区积分)
 *   switch_tol   = EPSILON * AXIS_SWITCH_RATIO
 *   hold_max_speed = v_max * HOLD_SPEED_RATIO
 *   brake_dist = v_max²/(2·accel) + EPSILON + BRAKE_MARGIN
 */
/** 位置环 D 项比例: kd_eff = KP × 此值
 *  P0-修复 2026-07-17: 逐轴刹车已独立用|dx|/|dy|防冲头, D 项只做轻量速度阻尼. */
/* kd=KP×0.30=1.65, 适中阻尼: 远距高速有制动力不冲, 近距不拖死 */
/* kd=5.50×0.40=2.20, 强阻尼拽住车速, 配合低FLOOR刹进EPSILON */
#define CHASSIS_POS_KD_RATIO                (0.15f)  /* X: Kd = X_Kp × 此比例 */
#define CHASSIS_POS_Y_KD_RATIO              (0.15f)  /* Y: Kd = Y_Kp × 此比例 */
#define CHASSIS_POS_HOLD_KD_RATIO           (0.70f)
/* 0.50→0.05: 刹车区从55cm缩到~10cm, 太大会让车过早限速, 不影响防冲 */
#define CHASSIS_POS_BRAKE_MARGIN_M          (0.20f)
#define CHASSIS_POS_I_LIMIT_RATIO           (0.40f)
#define CHASSIS_POS_I_BAND_RATIO            (0.8f)
//#define CHASSIS_POS_AXIS_SWITCH_RATIO       (0.6f)
#define CHASSIS_POS_HOLD_SPEED_RATIO        (0.80f)

/** 保持轴死区 (m) — 滤除编码器量化噪声 (~2~5mm)，远小于 EPSILON
 *  P0-修复 2026-06-07: 原无死区，噪声被 sqrt_ctrl 放大 → Y 方向持续微幅震荡 */
#define CHASSIS_POS_HOLD_DEAD_ZONE_M        (0.01f)

/** D 项低通滤波系数 α (一阶 IIR) — 截止 ≈ α/(2π·dt)
 *  0.10 @ 20ms → 截止≈0.8Hz，衰减 odom 高频噪声 */
#define CHASSIS_POS_D_LPF_ALPHA             (0.40f)

/** brake_cap 末段最小有效速度 (m/s) — 克服静摩擦，确保推进到 EPSILON 内
 *  P0-修复 2026-06-30: 0.65→0.15。0.65 刹车距离 7cm > EPSILON 2.5cm → 必定过冲。
 *  0.15 刹车距离 ~4mm < EPSILON，且 MPC 自行规划减速，不需要刹车底速硬兜。
 *  如需应对长距离 sqrt_controller 路径的静摩擦卡死，可保留 0.20~0.25。 */
/* P0-修复 2026-07-17: 0.15→0.06, 刹车区末段最低速减半, 配合 KD 翻倍平滑停入 EPSILON. */
/* 0.06→0.10: 略高以克服静摩擦, 配合 KD=1.65 刹得住不过冲 */
/* 制动段速度上限的下限：仅防止包络上限过早塌到零；
 * 它不是强制目标速度，位置环给出的更低速度仍会原样保留。 */
#define CHASSIS_POS_BRAKE_FLOOR_MPS         (0.200f)

/* ============================================================
 * §D IMU / 卡尔曼滤波 / 编码器融合
 * ============================================================ */

/* ---- Yaw 轴选择 (IMU 侧装/倒装适配) ---- */
#define CHASSIS_IMU_YAW_AXIS_Z              (0)     /* 原始 Z 轴 (IMU 正装) */
#define CHASSIS_IMU_YAW_AXIS_Y              (1)     /* Y 轴 (IMU 侧装，当前实车) */
#define CHASSIS_IMU_YAW_AXIS_X              (2)     /* X 轴 (IMU 另一种侧装) */
#define CHASSIS_IMU_YAW_AXIS                CHASSIS_IMU_YAW_AXIS_Y

/* ---- Yaw 角速度处理 ---- */

/** 陀螺灵敏度标定系数 (默认 1.0)
 *  实物转 360° 显示 200° → scale = 200/360 = 0.556
 *  实物转 360° 显示 400° → scale = 400/360 = 1.111
 *  公式: 新值 = 当前值 × (显示角度 / 实际角度) */
#define CHASSIS_IMU_GYRO_SCALE              (1.01058f)

/** Yaw 角速度死区 (°/s) — 抑制静止抖动 */
#define CHASSIS_IMU_GYRO_DEADZONE_DPS       (0.004f)

/** KF 静止预测死区 (°/s)：仅在四轮反馈静止时抑制残余零偏积分 */
#define CHASSIS_IMU_KF_STILL_RATE_DEADZONE_DPS (0.10f)

/** IMU 物理静止所用的单轮反馈阈值 (m/s)，独立于电机停轮的 0.03m/s 容差 */
#define CHASSIS_IMU_WHEEL_STILL_EPS_MPS      (0.010f)

/** Yaw 角速度一阶低通系数 (0,1] — 越小越平滑 */
#define CHASSIS_IMU_GYRO_LPF_ALPHA          (0.2f)

/** 静止时在线零偏慢修正系数 (EMA) */
#define CHASSIS_IMU_BIAS_ADAPT_ALPHA        (0.002f)

/* ---- 静止检测 (滑动窗口方差法) ---- */

/** 滑窗长度 (5ms 一拍，64=320ms) */
#define CHASSIS_IMU_STILL_WINDOW_LEN        (64U)

/** 上电零偏标定采样数：200 拍 × 5ms ≈ 1s，等待 IMU 启动零偏稳定。 */
#define CHASSIS_IMU_BIAS_CAL_SAMPLE_COUNT   (200U)

/** 上电标定前丢弃的预热样本：40 拍 × 5ms = 200ms，不计入零偏平均。 */
#define CHASSIS_IMU_BIAS_WARMUP_SAMPLE_COUNT (40U)

/** 静止判别阈值: 窗口方差上限 (°/s)²
 *  P0-回调 2026-05-02: 0.020→0.050，平台微震动也能识别静止 */
#define CHASSIS_IMU_STILL_VAR_TH_DPS2       (0.05f)

/** 静止确认时 bias 快速更新系数 — 时间常数 ~10 拍 = 50ms */
#define CHASSIS_IMU_BIAS_FAST_ALPHA         (0.10f)

/* ---- Yaw 卡尔曼滤波 (状态: [angle, bias]ᵀ) ---- */

/** 1=KF 替换原 EMA bias+欧拉积分；0=回退旧实现 */
#define CHASSIS_IMU_USE_KALMAN_YAW          (1)

/** 过程噪声: 角度 (°²/s²) */
#define CHASSIS_IMU_KF_Q_ANGLE_DPS2         (0.0010f)

/** 过程噪声: bias (°²/s²/s) — 反映 bias 随机游走速度
 *  P0-回调 2026-05-02: 8e-6→5e-5，车跑 5min 温升 0.05°/s/min，K 增益翻几倍 */
#define CHASSIS_IMU_KF_Q_BIAS_DPS2_PER_S    (0.001f)

/** 观测噪声: ZUPT 时陀螺噪声方差 (°²/s²) */
#define CHASSIS_IMU_KF_R_ZUPT_DPS2          (0.010f)

/** 状态协方差初值 */
#define CHASSIS_IMU_KF_P0_ANGLE_DEG2        (1.0f)
#define CHASSIS_IMU_KF_P0_BIAS_DPS2         (0.10f)

/* ---- 编码器 yaw 融合 (麦轮 O 型 yaw 逆运动学 → KF 弱观测) ---- */

/** 1=启用编码器 yaw 弱观测 */
#define CHASSIS_ODOM_YAW_FUSION_ENABLE      (1)

/** 编码器 yaw 观测噪声方差 (°²) — 大=几乎不信(仅长期纠偏)，小=信任高(打滑污染) */
#define CHASSIS_ODOM_YAW_R_DEG2             (80000.0f)

/** odom yaw 与 IMU yaw 偏差超过此值视为打滑/重定位，跳过观测 */
#define CHASSIS_ODOM_YAW_OUTLIER_DEG        (1.20f)

/** Innovation Gating: |wz_odom - wz_imu| 超过此值拒绝 (°/s)
 *  P0-修复 2026-05-02 (抬车空转污染 KF): IMU=0, odom>>0 → 自然拒绝 */
#define CHASSIS_ODOM_YAW_INNOV_GATE_DPS     (5.0f)

/* ============================================================
 * §E 几何 + 限幅 + 滤波 + 静摩擦前馈 + 里程计
 * ============================================================ */

/* ---- 车模物理尺寸 (实测) ---- */

/** 麦克纳姆轮半径 (米) */
#define CHASSIS_WHEEL_RADIUS_M              (0.0315f)

/** 前后轴距的 1/2 (米) */
#define CHASSIS_HALF_WHEEL_BASE_M           (0.100f)

/** 左右轮距的 1/2 (米) */
#define CHASSIS_HALF_TRACK_WIDTH_M          (0.090f)

/** 麦轮运动学常数 K = 半轴距+半轮距 */
#define CHASSIS_MECANUM_K_M                 (CHASSIS_HALF_WHEEL_BASE_M + CHASSIS_HALF_TRACK_WIDTH_M)

/**
 * 麦轮辊子布局: 1=O 型 (实车), 0=X 型
 *   O 型相对 X 型，所有 vx (横移) 项整体翻号；vy/wz 不变。
 *   代码层切换此宏即可自动切换正/逆运动学。
 */
#define CHASSIS_MECANUM_O_TYPE_LAYOUT       (1)

/** 编码器每转脉冲数 (256 线 × 4 倍频) */
#define CHASSIS_ENCODER_COUNTS_PER_REV      (1024.0f)

/* ---- 速度限幅 ---- */

/** 地图坐标系 X 方向最大线速度 (m/s)；保留原宏名兼容现有调用方。
 *  2026-07-29 提速: 1.60→1.90，远距离上限提高约 19%。 */
#define CHASSIS_MAX_LINEAR_SPEED_MPS        (1.90f)

/** 地图坐标系 Y 方向最大线速度 (m/s) */
#define CHASSIS_MAX_LINEAR_SPEED_Y_MPS      (1.55f)

/** 正常控制路径的单轮速度兑底上限 (m/s) — 等比例缩放保方向 */
#define CHASSIS_WHEEL_SPEED_CAP_MPS         (4.0f)

/** 在线调参时 X/Y 线速度上限硬限制 (m/s) */
#define CHASSIS_TUNE_MAX_LINEAR_SPEED_LIMIT_MPS  (4.0f)

/** 在线调参时角速度上限硬限制 (°/s) */
#define CHASSIS_TUNE_MAX_YAW_SPEED_LIMIT_DPS     (360.0f)

/** 单轮 PID 调试模式下调试轮目标速度上限 (m/s) — 仅 debug 使用 */
#define CHASSIS_DEBUG_WHEEL_SPEED_LIMIT_MPS     (5.0f)

/* ---- 发车区 & 越界几何 (P0-8) ---- */
#define CHASSIS_LAUNCH_ZONE_W_M             (0.30f)
#define CHASSIS_LAUNCH_ZONE_H_M             (0.30f)
#define CHASSIS_LAUNCH_ZONE_BOTTOM_OFFSET_M (1.0f)
#define CHASSIS_BODY_RADIUS_M               (0.175f)
#define CHASSIS_OOB_HYSTERESIS_M            (0.05f)

/** 静止判据: 车体平移速度模长门槛 (m/s) */
#define CHASSIS_STATIC_SPEED_EPS_MPS        (0.07f)

/** 静止持续时长门槛 (ms) — 规则: 发车区静止 3s=重置 */
#define CHASSIS_STATIC_HOLD_MS              (3000U)

/** 速度估算一阶 IIR 平滑系数 (0,1] — 0.20 等效时间常数≈25ms */
#define CHASSIS_SPEED_LPF_ALPHA             (0.20f)

/* ---- 里程计标定系数 (补偿轮径/打滑等误差) ----
 *   标定方法: 让车走 1 格(20cm)，用尺子测量实际位移 d_real，
 *   则 SCALE = 0.20 / d_real
 */
#define CHASSIS_ODOM_SCALE_X                (0.3970f)
#define CHASSIS_ODOM_SCALE_Y                (0.4130f)

/* ---- 静摩擦前馈 (Breakaway FF) — 每轮独立可配 ----
 *   实现 (apply_speed): 每轮独立查 g_chassis_tune_params
 *     仅在真实静止起步，或目标与反馈同向且目标幅值不低于反馈时启用；
 *     同向减速/尚未停稳的换向会立即撤掉前馈，避免抵消主动制动。
 *     前馈幅值随 |fb| / fb_static_eps[i] 线性衰减。
 *   调参口诀:
 *     起步迟/不动 → 加大 FLOOR
 *     起步猛冲    → 减小 FLOOR
 *     起步后仍推得猛 → 减小 FB_STATIC_EPS (ff 更快退出)
 *     小目标也冲   → 提高 TARGET_EPS (更晚触发)
 */

/* 默认值 (各轮初值模板) */
// #define CHASSIS_WHEEL_BREAKAWAY_DEFAULT_TARGET_EPS_MPS     (0.08f)
// #define CHASSIS_WHEEL_BREAKAWAY_DEFAULT_PWM_FLOOR          (1000.0f)
// #define CHASSIS_WHEEL_BREAKAWAY_DEFAULT_FB_STATIC_EPS_MPS  (2.80f)

/* LF (Wheel 0)
 * P0-修复 2026-06-07: TARGET_EPS=0+FB_STATIC=2.10→breakaway 永远激活，
 * 位置环收拢时指令小幅正负交替→breakaway 跟跳 2000PWM→把车甩出极限环 */
#define CHASSIS_WHEEL_BREAKAWAY_LF_TARGET_EPS_MPS          (0.02f)
#define CHASSIS_WHEEL_BREAKAWAY_LF_PWM_FLOOR               (750.0f)
#define CHASSIS_WHEEL_BREAKAWAY_LF_FB_STATIC_EPS_MPS       (1.90f)

/* RF (Wheel 1) */
#define CHASSIS_WHEEL_BREAKAWAY_RF_TARGET_EPS_MPS          (0.02f)
#define CHASSIS_WHEEL_BREAKAWAY_RF_PWM_FLOOR               (850.0f)
#define CHASSIS_WHEEL_BREAKAWAY_RF_FB_STATIC_EPS_MPS       (1.90f)

/* LB (Wheel 2) */
#define CHASSIS_WHEEL_BREAKAWAY_LB_TARGET_EPS_MPS          (0.02f)
#define CHASSIS_WHEEL_BREAKAWAY_LB_PWM_FLOOR               (800.0f)
#define CHASSIS_WHEEL_BREAKAWAY_LB_FB_STATIC_EPS_MPS       (1.90f)

/* RB (Wheel 3) */
#define CHASSIS_WHEEL_BREAKAWAY_RB_TARGET_EPS_MPS          (0.02f)
#define CHASSIS_WHEEL_BREAKAWAY_RB_PWM_FLOOR               (800.0f)
#define CHASSIS_WHEEL_BREAKAWAY_RB_FB_STATIC_EPS_MPS       (1.90f)

/* 正/负向不对称前馈 (XP=正X移动 / XN=负X移动)
 * P0-修复 2026-06-07: 原 XN 不对称(LB=1200独大)→ -X 偏航力矩→yaw 耦合震荡；
 * 改为对称互换，两侧推力均衡后 yaw 力矩抵消 */
#define CHASSIS_WHEEL_BREAKAWAY_LF_PWM_FLOOR_XP            (750.0f)
#define CHASSIS_WHEEL_BREAKAWAY_RF_PWM_FLOOR_XP            (850.0f)
#define CHASSIS_WHEEL_BREAKAWAY_LB_PWM_FLOOR_XP            (800.0f)
#define CHASSIS_WHEEL_BREAKAWAY_RB_PWM_FLOOR_XP            (800.0f)

#define CHASSIS_WHEEL_BREAKAWAY_LF_PWM_FLOOR_XN            (750.0f)
#define CHASSIS_WHEEL_BREAKAWAY_RF_PWM_FLOOR_XN            (850.0f)
#define CHASSIS_WHEEL_BREAKAWAY_LB_PWM_FLOOR_XN            (800.0f)
#define CHASSIS_WHEEL_BREAKAWAY_RB_PWM_FLOOR_XN            (800.0f)

/* 兼容宏 (旧名称) */
// #define CHASSIS_WHEEL_BREAKAWAY_TARGET_EPS_MPS    CHASSIS_WHEEL_BREAKAWAY_DEFAULT_TARGET_EPS_MPS
// #define CHASSIS_WHEEL_BREAKAWAY_PWM_FLOOR         CHASSIS_WHEEL_BREAKAWAY_DEFAULT_PWM_FLOOR
// #define CHASSIS_WHEEL_BREAKAWAY_FB_STATIC_EPS_MPS CHASSIS_WHEEL_BREAKAWAY_DEFAULT_FB_STATIC_EPS_MPS

/* ============================================================
 * §极性 方向系数单一真相源 ("正方向 = 正" 不变量)
 *
 * 约定: 每轮物理正方向 = 前进 (车身 Y+)，对应正命令 + 正反馈。
 *
 * 三类方向系数各自吸收接线 / 编码器相位 / IMU 安装朝向，
 * 把"正方向=正"归一到上层，使各环 Kp 全用正号。
 *
 * 各 ±1 由**开环实测辨识**(给正命令 → 看执行器方向 / 各反馈符号)，
 * 非固定常量；换硬件 / 重接线须重辨识。
 *
 * 闭环 (yaw/航向环) 另需"传感器正向 = 被控量正向"，
 * 开环单实例辨识不覆盖，须手动转车确认。
 *
 * ★ agent 改/读本段时**主动提醒用户核实接线并请其确认**
 *   (见 hf-hw-mapping / hf-embedded-safety)。
 *
 * 实车标定对照 (从原 chassis_config.h 迁移):
 *   原 LF/RF/LB/RB_DIR_SIGN 全为 +1.0f
 *   原 ENCODER1_SIGN=+1(LB), ENCODER2_SIGN=-1(RB),
 *       ENCODER3_SIGN=-1(RF), ENCODER4_SIGN=+1(LF)
 *   原 IMU_YAW_SIGN=-1 (侧装+左转gyro_y读负)
 * ------------------------------------------------------------ */

/* (1) 执行器输出 MOTOR_*_OUTPUT_DIR: driver 乘命令，使 +命令 → 物理前进
 *     ★ 下列四轮正负号均为实车标定值，并非统一 +1；换接线/换电机线序后必须重新辨识 */
#define MOTOR_LF_OUTPUT_DIR                 (+1.0f)
#define MOTOR_RF_OUTPUT_DIR                 (-1.0f)
#define MOTOR_LB_OUTPUT_DIR                 (+1.0f)
#define MOTOR_RB_OUTPUT_DIR                 (-1.0f)

/* (2) 编码器 ENCODER_*_DIR: 乘原始计数，使 前进 → +速度反馈
 *     ★ 实车已标定值，换编码器线序/减速箱后必须重新辨识 */
#define ENCODER_LF_DIR                      (+1)    /* 实车: ENCODER4_SIGN=+1 */
#define ENCODER_RF_DIR                      (-1)    /* 实车: ENCODER3_SIGN=-1 */
#define ENCODER_LB_DIR                      (+1)    /* 实车: ENCODER1_SIGN=+1 */
#define ENCODER_RB_DIR                      (-1)    /* 实车: ENCODER2_SIGN=-1 */

/* (3) IMU 轴映射符号 — 乘陀螺仪原始值 (Y 轴)
 *     ★ 必须手动转车确认: 左转(CCW)时 yawRate>0 才对。
 *     若反 → 改 -1.0f；开环辨识不覆盖整车轴向 */
#define CHASSIS_IMU_YAW_SIGN                (-1.0f) /* 实车: 左转gyro_y读负→翻转 */

/* (4) 闭环轴向对齐验证 (agent 无法替代，必须交用户):
 *     yaw 环要 IMU yawRate 正向 = 麦轮 wz 正向 (CCW/左转)，
 *     符号在 IMU 驱动 (-gyro_y)。开环辨识只管单轮命令-反馈，
 *     不管整车旋转轴向，必须手动转动车体确认。
 *     改 YAW_SIGN / YAW_AXIS 后重做此验证。
 */

/* ============================================================
 * §F 视觉融合 / 故障保护 / 通信
 *
 *   视觉只给整数格 (单元约 0.20~0.23m)，量化噪声 ±0.10~0.115m。
 *   默认关闭运动中连续融合，改为:
 *     - 到站静止 → 多帧表决 → Snap 到格中心 (事件驱动)
 *     - 运动中一致性监控 → 大幅打滑/搬车时硬重定位
 * ============================================================ */

/* ---- 1) 运动中连续融合 (默认关) ---- */

#ifndef CHASSIS_VISION_FUSION_ENABLE
#define CHASSIS_VISION_FUSION_ENABLE            (0)
#endif

#ifndef CHASSIS_VISION_FUSION_PERIOD_MS
#define CHASSIS_VISION_FUSION_PERIOD_MS         (75U)
#endif

#ifndef CHASSIS_VISION_MAX_OBS_AGE_MS
#define CHASSIS_VISION_MAX_OBS_AGE_MS           (180U)
#endif

#ifndef CHASSIS_VISION_DELAY_COMP_MS
#define CHASSIS_VISION_DELAY_COMP_MS            (40U)
#endif

#ifndef CHASSIS_VISION_IGNORE_ERR_M
#define CHASSIS_VISION_IGNORE_ERR_M             (0.03f)
#endif

#ifndef CHASSIS_VISION_SOFT_ALPHA
#define CHASSIS_VISION_SOFT_ALPHA               (0.20f)
#endif

#ifndef CHASSIS_VISION_ALPHA_STATIC_SCALE
#define CHASSIS_VISION_ALPHA_STATIC_SCALE       (1.50f)
#endif

#ifndef CHASSIS_VISION_STATIC_SPEED_MPS
#define CHASSIS_VISION_STATIC_SPEED_MPS         (0.05f)
#endif

#ifndef CHASSIS_VISION_LARGE_ERR_M
#define CHASSIS_VISION_LARGE_ERR_M              (0.50f)
#endif

#ifndef CHASSIS_VISION_MAX_STEP_M
#define CHASSIS_VISION_MAX_STEP_M               (0.08f)
#endif

/* ---- 2) 到站 Snap (正式比赛关闭，底盘仅使用编码器 + 陀螺仪) ---- */

#ifndef CHASSIS_VISION_SNAP_ON_ARRIVE_ENABLE
#define CHASSIS_VISION_SNAP_ON_ARRIVE_ENABLE    (0)
#endif

#ifndef CHASSIS_VISION_SNAP_VOTE_FRAMES
#define CHASSIS_VISION_SNAP_VOTE_FRAMES         (5U)
#endif

#ifndef CHASSIS_VISION_SNAP_VOTE_MIN
#define CHASSIS_VISION_SNAP_VOTE_MIN            (3U)
#endif

#ifndef CHASSIS_VISION_SNAP_SETTLE_MS
#define CHASSIS_VISION_SNAP_SETTLE_MS           (150U)
#endif

#ifndef CHASSIS_VISION_SNAP_SETTLE_SPEED_MPS
#define CHASSIS_VISION_SNAP_SETTLE_SPEED_MPS    (0.05f)
#endif

#ifndef CHASSIS_VISION_SNAP_MAX_SNAP_AGE_MS
#define CHASSIS_VISION_SNAP_MAX_SNAP_AGE_MS     (200U)
#endif

#ifndef CHASSIS_VISION_SNAP_TIMEOUT_MS
#define CHASSIS_VISION_SNAP_TIMEOUT_MS          (800U)
#endif

#ifndef CHASSIS_VISION_SNAP_MAX_GAP_CELLS
#define CHASSIS_VISION_SNAP_MAX_GAP_CELLS       (1U)
#endif

/* ---- 3) 运动中一致性监控 (正式比赛关闭) ---- */

#ifndef CHASSIS_VISION_CONSISTENCY_ENABLE
#define CHASSIS_VISION_CONSISTENCY_ENABLE       (0)
#endif

#ifndef CHASSIS_VISION_CONSISTENCY_PERIOD_MS
#define CHASSIS_VISION_CONSISTENCY_PERIOD_MS    (100U)
#endif

#ifndef CHASSIS_VISION_CONSISTENCY_GAP_CELLS
#define CHASSIS_VISION_CONSISTENCY_GAP_CELLS    (2U)
#endif

#ifndef CHASSIS_VISION_CONSISTENCY_HOLD_MS
#define CHASSIS_VISION_CONSISTENCY_HOLD_MS      (600U)
#endif

#ifndef CHASSIS_VISION_CONSISTENCY_COOLDOWN_MS
#define CHASSIS_VISION_CONSISTENCY_COOLDOWN_MS  (1000U)
#endif

#ifndef CHASSIS_VISION_CONSISTENCY_MAX_AGE_MS
#define CHASSIS_VISION_CONSISTENCY_MAX_AGE_MS   (250U)
#endif

/* ============================================================
 * §G MPC 直线行驶 (Model Predictive Control) — 1D 纵向
 *
 *   推箱子场景: 车沿网格轴线走直线, 推箱子时有变负载。
 *   MPC 提前 N 拍预知目标距离, 规划最优速度曲线,
 *   干扰后自动重规划。只接管驱动轴速度, 横向保持和
 *   航向保持沿用现有 hold_axis + yaw_pi。
 *
 *   CHASSIS_MPC_ENABLE=0 回退原 axis-by-axis sqrt_controller。
 *   CHASSIS_MPC_YAW_ENABLE=0 回退 yaw sqrt_controller (独立开关)。
 * ============================================================ */

/** 1=MPC 接管驱动轴, 0=回退原 axis-by-axis */
#define CHASSIS_MPC_ENABLE                      (1)

/** 预测步数 (20ms/步), N=10 → 200ms 前瞻 */
#define CHASSIS_MPC_HORIZON_N                   (20)

/** QP 决策变量维度 = HORIZON_N */
#define CHASSIS_MPC_H_DIM                       (CHASSIS_MPC_HORIZON_N)

/** 对称矩阵 packed 存储元素数 = N*(N+1)/2 */
#define CHASSIS_MPC_H_PACKED                    ((CHASSIS_MPC_H_DIM) * ((CHASSIS_MPC_H_DIM) + 1) / 2)

/** 位置精度权重 (m⁻²): 大→冲得快/停得猛, 小→柔和但可能不到位 */
#define CHASSIS_MPC_Q_POS                       (100.0f)

/** 速度幅值代价 (s²/m²): 大→巡航速度降低, 小→更接近 v_max */
#define CHASSIS_MPC_R_VEL                       (0.030f)

/** 速度平滑代价 (s²/m²): 大→加减速柔和, 小→响应快但可能 jerk */
#define CHASSIS_MPC_R_SMOOTH                    (0.600f)

/** 终端位置额外权重因子: Q_term = Q_POS * 此值 */
#define CHASSIS_MPC_QF_FACTOR                   (3.0f)

/** MPC 驱动轴最大速度 (m/s), ≤ 全局限速 */
#define CHASSIS_MPC_V_MAX_MPS                   CHASSIS_MAX_LINEAR_SPEED_MPS

/** FISTA 最大迭代数 */
#define CHASSIS_MPC_FISTA_MAX_ITER              (15)

/** FISTA 梯度范数收敛容差 */
#define CHASSIS_MPC_FISTA_TOL                   (1e-4f)

/** FISTA 步长 (0=基于 H 的 Frobenius 范数自动计算) */
#define CHASSIS_MPC_FISTA_STEP                  (0.0f)

/** 距离超此值回退 sqrt_controller (m): 大跳后 MPC 短时域可能不够 */
#define CHASSIS_MPC_FALLBACK_ERR_M              (0.50f)

/** MPC→PID 无扰融合起点 (m): 覆盖完整 MPC 区间，让实测速度阻尼提前参与刹车。 */
#define CHASSIS_MPC_BLEND_START_DIST_M          (0.30f)

/** MPC 求解下限/无扰融合终点 (m): 低于此距离完全使用 PID。 */
#define CHASSIS_MPC_MIN_DIST_M                  (0.10f)

/* ---- Yaw MPC ---- */

/** 1=MPC 接管航向旋转, 0=回退 sqrt_controller */
#define CHASSIS_MPC_YAW_ENABLE                  (1)

/** Yaw 角度精度权重 (°⁻²): 大→转得猛/停得准, 小→柔和.
 *  H 矩阵中实际贡献 = Q_POS × dt² × (N+QF) = Q_POS × 0.006,
 *  需要 ≥ 0.04 才能与 R_VEL 抗衡. Q_POS=12 时 pos 贡献 ≈ 0.072, 与 R_VEL 持平. */
#define CHASSIS_MPC_YAW_Q_POS                   (3.60f)

/** Yaw 角速度代价 (s²/°²): 大→转速降低, 小→更接近 max_yaw_speed.
 *  Q_POS=12 + R_VEL=0.04 组合: err=5°→320dps, err=2°→140dps, err=0.5°→35dps. */
#define CHASSIS_MPC_YAW_R_VEL                   (0.08f)

/** Yaw 角速度平滑代价: 大→加速柔和, 小→响应快 */
#define CHASSIS_MPC_YAW_R_SMOOTH                (0.10f)

/** Yaw 终端角度额外权重: Q_term = Q_POS * 此值 */
#define CHASSIS_MPC_YAW_QF_FACTOR               (5.0f)

/** 角度误差超此值回退 sqrt_controller (°) */
#define CHASSIS_MPC_YAW_FALLBACK_ERR_DEG        (120.0f)

/** 角度误差低于此值不用 MPC (°): 交棒给增益调度 sqrt_controller.
 *  0.50 处 sqrt_ctrl(KP_eff≈3) → wz≈1.5dps, 与 MPC 末端输出平滑衔接.
 *  设太小(0.2) MPC 会输出 ≈0.5dps 的无效微调, 浪费 CPU 且无实际效果. */
#define CHASSIS_MPC_YAW_MIN_DEG                 (0.50f)

#endif /* _CONFIG_CHASSIS_H_ */
