leo-lizx/transport-truck/project/code/chassis_motor.c

/*===========================================================================
 * [chassis_motor.c] 电机驱动模块实现
 *
 * @owner  rt1064-main
 * @periph PWM2                    四路电机 PWM 载波 17kHz (LF=C11, RF=D3, LB=C6, RB=C8)
 * @periph GPIO_C10,C7,D2,C9       四路电机方向控制 (推挽输出)
 *===========================================================================*/

#include "chassis_motor.h"

/**
 * @brief  初始化单路电机驱动
 * @param  motor 电机对象指针
 */
void chassis_motor_init(chassis_motor_t *motor)
{
    /* 初始化 PWM 输出引脚，初始占空比为 0（电机不转） */
    pwm_init(motor->pwm_channel, CHASSIS_MOTOR_PWM_FREQ_HZ, 0U);

    /* 初始化方向控制引脚为推挽输出，默认高电平（正向） */
    gpio_init(motor->dir_pin, GPO, GPIO_HIGH, GPO_PUSH_PULL);

    /* 确保启动时电机处于停止状态 */
    pwm_set_duty(motor->pwm_channel, 0U);
}

/**
 * @brief  设置单路电机有符号 PWM
 * @param  motor      电机对象指针
 * @param  pwm_signed 有符号 PWM：正值正转，负值反转
 */
void chassis_motor_set_pwm(chassis_motor_t *motor, float pwm_signed)
{
    float pwm_abs_value; /* 绝对值后的 PWM 幅值 */
    uint32 pwm_duty;     /* 下发到硬件的占空比 */

    /* 取绝对值并限幅到 PWM 最大值 */
    pwm_abs_value = (pwm_signed >= 0.0f) ? pwm_signed : (-pwm_signed);
    if (pwm_abs_value > CHASSIS_MOTOR_PWM_MAX)
    {
        pwm_abs_value = CHASSIS_MOTOR_PWM_MAX;
    }
    pwm_duty = (uint32)pwm_abs_value;

        /*
         * 方向控制逻辑：
         *   pwm_signed >= 0  -> GPIO_HIGH（正转）
         *   pwm_signed <  0  -> GPIO_LOW （反转）
         *
         * 若发现某轮方向与预期不符，请到 chassis_config.h 修改对应轮子的 DIR_SIGN 宏，
         * 不要改这里的正负号判定逻辑。
         */
    if (pwm_signed >= 0.0f)
    {
        gpio_high(motor->dir_pin);
    }
    else
    {
        gpio_low(motor->dir_pin);
    }

    pwm_set_duty(motor->pwm_channel, pwm_duty);
}

/**
 * @brief  立即停止单路电机
 * @param  motor 电机对象指针
 */
void chassis_motor_stop(chassis_motor_t *motor)
{
    pwm_set_duty(motor->pwm_channel, 0U);
}
