leo-lizx/transport-truck/project/code/app_link.h

/*********************************************************************************************************************
 * 文件名称   : app_link.h
 * 模块功能   : 视觉端 (OpenART Plus) 与主控端 (RT1064) 之间的二进制串口帧协议解析层
 * 作者/日期  : Pair-Programming Co-pilot, 2026-04-24
 * 任务编号   : P0-1   (帧协议加固：SOF + TYPE + LEN + PAYLOAD + CRC8)
 *--------------------------------------------------------------------------------------------------------------------
 * 帧格式 (定长 5B 帧头尾 + 变长载荷):
 *   ┌──────┬──────┬──────┬──────┬─────────────┬──────┐
 *   │ 0xAA │ 0x55 │ TYPE │ LEN  │  PAYLOAD..  │ CRC8 │
 *   │ SOF1 │ SOF2 │ 1B   │ 1B   │  LEN bytes  │ 1B   │
 *   └──────┴──────┴──────┴──────┴─────────────┴──────┘
 *
 *   - SOF1/SOF2 : 0xAA 0x55  双字节同步头, 防单字节噪声误同步
 *   - TYPE      : 帧类型枚举 (见 app_link_type_e)
 *   - LEN       : PAYLOAD 字节数, 0 ~ APP_LINK_MAX_PAYLOAD
 *   - CRC8      : 多项式 0x07, 初值 0x00, 覆盖 TYPE..PAYLOAD (不包括 SOF)
 *
 * 当前任务实现:
 *   - TYPE=0x01 MAP        : 兼容 192B ASCII 地图; 推荐 194B = 192B 地图 + car_x + car_y
 *   - TYPE=0x10 HEARTBEAT  : 1 字节自增 seq, 用于链路保活与丢包率统计
 *   - TYPE=0x11 RECOG_REQUEST: 主控指定本次只识别 BOX 或 TARGET，并携带请求编号
 *
 * 不在本任务范围 (留给 P0-2 / P1):
 *   - 链路超时回退状态机 (本文件只更新时间戳与心跳计数, 不做回退)
 *   - 地图快照采用 seq-lock 并发保护
 *********************************************************************************************************************/
#ifndef APP_LINK_H_
#define APP_LINK_H_

#include "zf_common_typedef.h"

#ifdef __cplusplus
extern "C" {
#endif

/*===================================================================================================================
 * 协议常量
 *=================================================================================================================*/
#define APP_LINK_SOF1               (0xAAU)         /* 帧起始字节 1                       */
#define APP_LINK_SOF2               (0x55U)         /* 帧起始字节 2                       */
#define APP_LINK_MAX_PAYLOAD        (200U)          /* PAYLOAD 上限 (略大于 MAP 194B)     */
#define APP_LINK_MAP_PAYLOAD_LEN    (192U)          /* 12 行 × 16 列 = 192 字节           */
#define APP_LINK_MAP_POS_LEN        (2U)            /* MAP 扩展坐标: car_x + car_y        */
#define APP_LINK_MAP_WITH_POS_LEN   (194U)          /* 192B 地图 + 2B 车辆坐标            */
#define APP_LINK_MAP_ROWS           (12U)           /* P0-3: 地图行数 (与 MAP_ROWS 同义)  */
#define APP_LINK_MAP_COLS           (16U)           /* P0-3: 地图列数 (与 MAP_COLS 同义)  */

/* 保留既有地图载荷编码，供串口地图快照和底盘软限位使用。 */
#define APP_LINK_CELL_EMPTY         (0U)
#define APP_LINK_CELL_WALL          (1U)
#define APP_LINK_CELL_TARGET        (2U)
#define APP_LINK_CELL_BOX           (3U)
#define APP_LINK_CELL_BOMB          (4U)

/*-- 帧类型枚举 ---------------------------------------------------------------------------------------------------*/
typedef enum
{
    APP_LINK_TYPE_MAP        = 0x01,    /* 视觉 → 主控: 全局地图        */
    APP_LINK_TYPE_BOX_CLASS  = 0x02,    /* 视觉 → 主控: 物体分类 (识别 tour) */
    APP_LINK_TYPE_POSE_HINT    = 0x03,  /* 主控 → 视觉: 位姿回灌 (后续) */
    APP_LINK_TYPE_HEARTBEAT    = 0x10,  /* 视觉 → 主控: 心跳, 载荷 1B seq */
    APP_LINK_TYPE_RECOG_REQUEST = 0x11  /* 主控 → 视觉: 指定识别类型和请求编号 */
} app_link_type_e;

/*-- BOX_CLASS 帧载荷常量 (识别 tour) -----------------------------------------------------------------------------
 * Payload 5 字节: [obj_kind][class_id][seq][request_id][confidence_pct]
 *   obj_kind : 0=BOX(图片箱子)  1=TARGET(数字目标)
 *   class_id : 1..N 有效类别;  0 = 无识别 / 置信度不足
 *   seq      : 视觉端自增 seq, 用于丢包/防重统计 (主控不据此切流)
 *   request_id: 原样回传主控请求编号；主控只采纳当前请求的结果
 *   confidence_pct: 模型置信率百分数, 0..100
 *--------------------------------------------------------------------------------------------------------------*/
#define APP_LINK_BOX_CLASS_PAYLOAD_LEN  (5U)
#define APP_LINK_RECOG_REQUEST_PAYLOAD_LEN (2U)
#define APP_LINK_OBJ_KIND_BOX           (0U)
#define APP_LINK_OBJ_KIND_TARGET        (1U)
#define APP_LINK_CLASS_ID_NONE          (0U)

/*-- 解析器内部状态机 (调试用, 外部一般不需要查询) ----------------------------------------------------------------*/
typedef enum
{
    APP_LINK_STATE_WAIT_SOF1 = 0,
    APP_LINK_STATE_WAIT_SOF2,
    APP_LINK_STATE_WAIT_TYPE,
    APP_LINK_STATE_WAIT_LEN,
    APP_LINK_STATE_WAIT_PAYLOAD,
    APP_LINK_STATE_WAIT_CRC
} app_link_state_e;

/*-- 链路统计计数 (供菜单 / 上位机调试观测) ----------------------------------------------------------------------*/
typedef struct
{
    uint32 frames_ok;           /* CRC 校验通过的完整帧数               */
    uint32 frames_crc_err;      /* CRC 校验失败丢弃的帧数               */
    uint32 frames_len_err;      /* LEN 字段非法或与 TYPE 不匹配丢弃数   */
    uint32 frames_byte_timeout; /* 字节间超时导致解析器复位次数         */
    uint32 frames_unknown_type; /* 未知 TYPE 丢弃数                     */
    uint32 frames_seq_drop;     /* 业务 seq 非连续次数                  */
    uint32 sync_drops;          /* 状态机 fallback 到等 SOF1 的字节数  */
    uint8  last_hb_seq;         /* 最近一次收到的心跳 seq               */
    uint32 hb_cnt;              /* 心跳累计次数                         */
} app_link_stats_t;

/*===================================================================================================================
 * 全局可观测变量 (仅读, 由 app_link.c 维护; volatile 因 ISR 写主循环读)
 *=================================================================================================================*/
extern volatile uint32 g_link_last_map_ms;     /* 最近一次有效 MAP 帧落地时刻 (ms 时基: PIT 心跳累加)            */
extern volatile uint32 g_link_last_car_ms;     /* 最近一次有效 MAP 坐标落地时刻 (ms 时基: PIT 心跳累加)           */
extern volatile uint32 g_link_last_hb_ms;      /* 最近一次心跳 / 任意有效帧时刻, 供 P0-2 链路超时回退使用       */
extern volatile uint32 g_link_last_map_link_ms;   /* OpenART1 MAP/heartbeat 最近活跃时刻                           */
extern volatile uint32 g_link_last_class_link_ms; /* OpenART2 BOX_CLASS/heartbeat 最近活跃时刻                     */
extern volatile uint32 g_link_last_box_class_ms;  /* 最近一次有效 BOX_CLASS 帧落地时刻                             */
extern volatile uint32 g_link_byte_last_ms;    /* 最近一次收到任意字节的时刻, 供字节超时复位                    */
extern volatile uint32 g_link_map_byte_last_ms;   /* OpenART1 最近收到任意字节的时刻                               */
extern volatile uint32 g_link_class_byte_last_ms; /* OpenART2 最近收到任意字节的时刻                               */
extern volatile uint8  g_link_car_x;           /* 最近一次 OpenART1 识别到的车辆 X 坐标 (0~15)                  */
extern volatile uint8  g_link_car_y;           /* 最近一次 OpenART1 识别到的车辆 Y 坐标 (0~11)                  */
extern volatile uint32 g_link_map_frame_id;    /* Increments after each valid MAP payload is committed.              */
extern app_link_stats_t g_link_stats;          /* 统计计数 (P0-1 不要求原子读, 接受偶发撕裂)                    */
extern app_link_stats_t g_link_map_stats;      /* OpenART1/UART4 MAP 解析统计                                  */
extern app_link_stats_t g_link_class_stats;    /* OpenART2/UART1 BOX_CLASS 解析统计                            */

/*-- P0-3: seq-lock 读端重试达到上限的累计次数, 长期保持 0 即说明并发保护无碰撞 --------------------------------*/
extern volatile uint32 g_link_map_snapshot_retry_giveup;

/*===================================================================================================================
 * MAP 附带车辆格坐标 —— seq-lock 快照（供视觉融合 / 到站确认；与 g_link_car_x 同源更新）
 *=================================================================================================================*/
typedef struct
{
    uint8  car_x;       /* 0 ~ APP_LINK_MAP_COLS-1                              */
    uint8  car_y;       /* 0 ~ APP_LINK_MAP_ROWS-1                              */
    uint32 stamp_ms;    /* app_link 内部 ms，与 app_link_get_ms() 同源          */
    uint32 frame_id;    /* 每成功提交一帧带坐标的 MAP 自增                       */
    uint8  valid;       /* 是否至少收到过一帧 LEN=194 且地图校验通过的坐标       */
} app_link_car_snapshot_t;

/*===================================================================================================================
 * 对外 API
 *=================================================================================================================*/

/*-------------------------------------------------------------------------------------------------------------------
 * 函数: app_link_init
 * 功能: 协议层初始化, 必须在 uart_init / uart_rx_interrupt / pit 之后, 进入主循环之前调用一次
 * 参数: 无
 * 返回: 无
 *-----------------------------------------------------------------------------------------------------------------*/
void app_link_init(void);

/*-------------------------------------------------------------------------------------------------------------------
 * 函数: app_link_isr_feed_byte
 * 功能: 兼容旧调用, 默认把单个字节喂给 OpenART1/MAP 状态机
 * 参数: byte —— 串口最新接收到的 1 字节
 * 返回: 无
 * 备注: 函数内部不分配内存, 不调用阻塞接口, 整体执行时间 < 5 µs
 *-----------------------------------------------------------------------------------------------------------------*/
void app_link_isr_feed_byte(uint8 byte);
void app_link_isr_feed_map_byte(uint8 byte);
void app_link_isr_feed_class_byte(uint8 byte);

/*-------------------------------------------------------------------------------------------------------------------
 * 函数: app_link_tick_1ms
 * 功能: 1ms 时基钩子, 用于驱动字节超时检测与时间戳累加
 * 参数: 无
 * 返回: 无
 * 备注: 推荐挂在 PIT_CH0 (5ms) 或菜单 10ms 中断里, 累加步长 = 调用周期 (ms)
 *-----------------------------------------------------------------------------------------------------------------*/
void app_link_tick(uint32 elapsed_ms);

/*-------------------------------------------------------------------------------------------------------------------
 * 函数: app_link_compute_crc8
 * 功能: 对外暴露的 CRC8 计算 (多项式 0x07, 初值 0x00), 单元测试与发送侧均可调用
 * 参数: data —— 待校验数据指针; len —— 字节数
 * 返回: CRC8 校验值
 *-----------------------------------------------------------------------------------------------------------------*/
uint8 app_link_compute_crc8(const uint8 *data, uint32 len);

/*-------------------------------------------------------------------------------------------------------------------
 * 函数: app_link_get_ms
 * 功能: 读取协议层 ms 时基 (由 app_link_tick 累加, 与各链路时间戳同源)
 * 参数: 无
 * 返回: 当前 ms 计数 (上电累加, 49.7 天回环)
 * 用途: 业务层做 (now - g_link_last_*_ms) 静默时长判定时, 必须用本接口而不是另起一套时基,
 *       否则两套计数步长不一致会导致超时阈值漂移。
 *-----------------------------------------------------------------------------------------------------------------*/
uint32 app_link_get_ms(void);

/*-------------------------------------------------------------------------------------------------------------------
 * 函数: app_link_send_recog_request
 * 功能: 通过 OpenART2/UART1 发送识别请求，载荷为 [obj_kind][request_id]
 * 备注: request_id=0 保留为“尚无请求”；非法参数不会发送。
 *-----------------------------------------------------------------------------------------------------------------*/
void app_link_send_recog_request(uint8 obj_kind, uint8 request_id);

/*-------------------------------------------------------------------------------------------------------------------
 * 函数: app_link_get_map_snapshot
 * 功能: 【P0-3】把视觉端最新一帧合法地图以 seq-lock 方式拷贝到调用方提供的缓冲区
 * 参数: dst —— 12×16 目标缓冲区 (单元格枚举值, 与 MAP_EMPTY/WALL/TARGET/BOX/BOMB 一致)
 * 返回: 无
 * 备注:
 *   1. 写者位于视觉 UART ISR (commit_map_frame), 读者可在主循环 / PIT 中断中调用, 均无阻塞
 *   2. 内部最多重试 8 次; 超限则放弃本次拷贝并自增 g_link_map_snapshot_retry_giveup,
 *      调用方应保留上次快照 (本函数不会写脏数据, 但可能保留部分上次内容)
 *   3. 上电至首帧到达前, 拷贝结果为全 0，调用者应检查地图帧时间戳
 *-----------------------------------------------------------------------------------------------------------------*/
void app_link_get_map_snapshot(uint8 dst[APP_LINK_MAP_ROWS][APP_LINK_MAP_COLS]);

/*-------------------------------------------------------------------------------------------------------------------
 * 函数: app_link_inject_static_map
 * 功能: 将静态地图（编译期或本地构造）注入协议层的权威地图副本，使菜单在无串口链路时也能渲染地图色块。
 *       典型场景: SOKO_SELFTEST / HARDCODED_MAP 等模式需要在屏幕上观察地图但不需要 OpenART 发帧。
 * 参数: map —— 12×16 单元格枚举值数组 (MAP_EMPTY/WALL/TARGET/BOX/BOMB)
 * 返回: 无
 * 备注:
 *   1. 内部使用与 commit_map_frame 相同的 seq-lock 写入路径，读者（菜单/业务层）无需额外同步。
 *   2. 写入后自动置 g_link_last_map_ms 为当前时基，使菜单判定地图"新鲜"并触发色块渲染。
 *   3. 此后调用方需在主循环中定期刷新 g_link_last_map_ms = app_link_get_ms()，否则 500ms 后菜单判定过期。
 *-----------------------------------------------------------------------------------------------------------------*/
void app_link_inject_static_map(const uint8 map[APP_LINK_MAP_ROWS][APP_LINK_MAP_COLS]);
void app_link_inject_static_car(uint8 car_x, uint8 car_y);

/*-------------------------------------------------------------------------------------------------------------------
 * 函数: app_link_get_car_snapshot
 * 功能: seq-lock 读出最近一次有效的 MAP 车辆格坐标 + 时间戳 + 帧号，避免与 ISR 写入撕裂
 * 参数: out —— 输出；可为 NULL（直接忽略）
 * 返回: 无
 *-----------------------------------------------------------------------------------------------------------------*/
void app_link_get_car_snapshot(app_link_car_snapshot_t *out);

/*===================================================================================================================
 * BOX_CLASS 帧 — 识别 tour 阶段视觉端持续广播的"当前视野中央物体类别"
 *  - 主控按 1ms tick 维护一个 seq-lock 快照, 业务层按 request_id 连续确认最终类别
 *  - 上电至首帧到达前, 快照内容 valid=0; 业务层据此决定是否进入 SAMPLE 阶段
 *=================================================================================================================*/
typedef struct
{
    uint8  obj_kind;    /* APP_LINK_OBJ_KIND_BOX / TARGET                       */
    uint8  class_id;    /* 1..N (0 = 无识别)                                     */
    uint8  vision_seq;  /* 视觉端自增 seq, 透传                                  */
    uint8  request_id;  /* 视觉端回传的主控识别请求编号                           */
    uint8  confidence_pct; /* 模型置信率百分数, 0..100                            */
    uint32 stamp_ms;    /* 落地时间, 与 app_link_get_ms() 同源                   */
    uint32 frame_id;    /* 主控侧帧号, 每收到一帧自增                            */
    uint8  valid;       /* 至少收到过一帧合法 BOX_CLASS                          */
} app_link_box_class_snapshot_t;

/*-------------------------------------------------------------------------------------------------------------------
 * 函数: app_link_get_box_class_snapshot
 * 功能: seq-lock 拷贝最近一帧 BOX_CLASS 解析结果
 * 参数: out —— 输出, 可为 NULL (直接忽略)
 * 备注: 业务层应配合 frame_id 变化和 stamp_ms 抗陈旧来判定 "新一帧已到"
 *-----------------------------------------------------------------------------------------------------------------*/
void app_link_get_box_class_snapshot(app_link_box_class_snapshot_t *out);

#ifdef __cplusplus
}
#endif

#endif /* APP_LINK_H_ */
