leo-lizx/transport-truck/project/code/chassis_arrival.h

#ifndef CHASSIS_ARRIVAL_H
#define CHASSIS_ARRIVAL_H

#include <stdint.h>

typedef struct
{
    uint8_t hold_translation;
    uint8_t arrived;
} chassis_arrival_decision_t;

/* 到达确认必须检查当前一拍的角度和角速度，不能复用带滞回的在位锁。
 * 在位锁允许误差从进入阈值漂到退出阈值，若把它当 yaw_ok 会误判到达。 */
static inline uint8_t chassis_yaw_arrival_realtime_ok(
    float yaw_error_deg,
    float yaw_rate_dps,
    float error_limit_deg,
    float rate_limit_dps)
{
    float abs_error = (yaw_error_deg >= 0.0f) ? yaw_error_deg : -yaw_error_deg;
    float abs_rate = (yaw_rate_dps >= 0.0f) ? yaw_rate_dps : -yaw_rate_dps;

    return (uint8_t)((abs_error < error_limit_deg) &&
                     (abs_rate < rate_limit_dps));
}

/* 到点驻留决策保持为纯函数式小状态机，便于在无硬件环境验证。
 * 位置入窗但速度仍高时继续由运动曲线主动制动，避免硬停后滑出窗口再启动；
 * 位置和速度都满足后冻结平移，航向稳定期间不累计驻留。 */
static inline chassis_arrival_decision_t chassis_arrival_dwell_update(
    uint16_t *dwell_count,
    uint8_t position_ok,
    uint8_t velocity_ok,
    uint8_t yaw_ok,
    uint16_t required_count)
{
    chassis_arrival_decision_t decision = {0U, 0U};

    if ((position_ok == 0U) || (velocity_ok == 0U)) {
        *dwell_count = 0U;
        return decision;
    }

    decision.hold_translation = 1U;
    if (yaw_ok == 0U) {
        *dwell_count = 0U;
        return decision;
    }

    if (*dwell_count < required_count) {
        ++(*dwell_count);
    }
    decision.arrived = (uint8_t)(*dwell_count >= required_count);
    return decision;
}

/* 保持主动制动直到所有轮速足够低，再清 PID/PWM，避免增量式 PID 残留输出。 */
static inline uint8_t chassis_wheels_idle_stop_ready(
    const float *wheel_targets_mps,
    const float *wheel_feedback_mps,
    uint8_t wheel_count,
    float target_epsilon_mps,
    float feedback_epsilon_mps)
{
    uint8_t i;

    if (wheel_count == 0U) {
        return 0U;
    }

    for (i = 0U; i < wheel_count; ++i) {
        float abs_target = (wheel_targets_mps[i] >= 0.0f)
                         ? wheel_targets_mps[i] : -wheel_targets_mps[i];
        float abs_feedback = (wheel_feedback_mps[i] >= 0.0f)
                           ? wheel_feedback_mps[i] : -wheel_feedback_mps[i];

        if ((abs_target >= target_epsilon_mps) ||
            (abs_feedback >= feedback_epsilon_mps)) {
            return 0U;
        }
    }

    return 1U;
}

/* IMU 的静止授权只反映车轮是否真实运动，不能与“目标是否为零”的停轮条件共用。
 * 否则角度环刚产生非零目标时，即使车轮尚未转动，也会永久禁止零偏校正。 */
static inline uint8_t chassis_wheels_feedback_stationary(
    const float *wheel_feedback_mps,
    uint8_t wheel_count,
    float feedback_epsilon_mps)
{
    uint8_t i;

    if (wheel_count == 0U) {
        return 0U;
    }

    for (i = 0U; i < wheel_count; ++i) {
        float abs_feedback = (wheel_feedback_mps[i] >= 0.0f)
                           ? wheel_feedback_mps[i] : -wheel_feedback_mps[i];
        if (abs_feedback >= feedback_epsilon_mps) {
            return 0U;
        }
    }

    return 1U;
}

#endif /* CHASSIS_ARRIVAL_H */
