leo-lizx/transport-truck/(commit log)

2026-02-27 init: 首次提交干净的 RT1064 基础库与环境配置
    [RT1064核心板丝印与芯片引脚对应表格.xlsx]
2026-03-07 寻路 游戏阶段更改
2026-03-08 清除缓存
2026-03-09 寻路代码更改
2026-03-09 feat: 底盘控制模块化拆分 — 7 个独立子模块 + 统一配置
    将原 chassis_pose_ctrl.c 单文件拆分为 7 个独立模块：
    - chassis_config.h — 统一引脚 / 物理参数 / PID 增益配置
    - chassis_pid.c/.h — 增量式 PID 控制器
    - chassis_motor.c/.h — DRV8701E 电机驱动 (PWM + DIR)
    - chassis_encoder.c/.h — 正交编码器测速
    - chassis_imu.c/.h — IMU660RB 航向角积分
    - chassis_mecanum.c/.h — 麦轮正/逆运动学 + 等比例限速
    - chassis_ctrl.c/.h — 顶层控制（里程计 + 导航 + 缓加速 + PID 闭环）
    其他变更：
    - chassis_pose_ctrl.h 改为兼容层（宏映射旧 API 到新接口）
    - chassis_pose_ctrl.c 清空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
2026-03-10 imu姿态更改
2026-03-10 优化IMU模块，移除陀螺仪零偏设置接口，自动静止标定，更新相关文档
2026-03-11 添加车模尺寸数据 菜单
2026-03-11 新增推箱子求解器，实现第三阶段炸弹全流程，合并菜单代码并更新IAR工程
2026-03-13 修复推箱子逻辑
2026-03-13 修改编码器方向
2026-03-15 yaw角矫正
2026-03-16 优化算法逻辑，初始化main调试代码
2026-03-16 删除中间文件，菜单闪烁问题待解决
2026-03-18 解决菜单闪烁问题，姿态闭环没闭上
2026-03-18 修改编码器电机
2026-03-18 0度姿态闭环调试函数编写
2026-03-18 menu与ctrl注释编写，强制姿态闭环
2026-03-20 地图大小修改
2026-03-20 优化ctrl
2026-03-26 O型修改
2026-03-27 X型修改
2026-03-30 单电机pid调试，消抖
2026-04-01 逻辑优化
2026-04-20 feat: 重构推箱状态机并增强死局炸弹策略
2026-04-23 feat(P0-2/3/4): 视觉链路超时监管+地图/pose seq-lock+BFS缓冲迁BSS
    - 新增 app_link 模块: 集中管理串口收包/心跳时基与地图快照(seq-lock)
    - app_game_logic: 引入 STAGE_PAUSE_ON_LINK_LOSS, 视觉静默>200ms 立即停车; 恢复后强制 RECOGNIZE_MAP
    - chassis_ctrl: pose 三字段加 seq-lock; 软限位改用传入地图快照, 解除对 g_game_map 直接依赖
    - algo_sokoban_solver/app_game_logic: BFS 反推/死局探测临时数组迁至 static BSS, 释放约 800B 栈
    - isr/main: 心跳与地图收包改走 app_link 接口; LPUART1 ISR 不再直接写 g_game_map
    - 文档: 新增 P0进度交接 / 工程讲解与调试手册 / 测试方案 / 规则提炼
2026-04-24 速度上限调整，状态机模式优化
2026-04-24 最新更改
2026-04-25 四个轮子的pid调节
2026-04-26 修改md文件
2026-04-27 姿态闭环
2026-04-29 姿态角纠正
2026-04-29 姿态闭环1.0
2026-05-02 姿态闭环2.0，初始化位置闭环
2026-05-02 位置闭环1.0
2026-05-05 位置闭环2.0
2026-05-05 位置闭环2.1
2026-05-06 算法修正
2026-05-07 视觉矫正
2026-05-08 位置闭环2.2
2026-05-08 位置闭环3.0
2026-05-08 位置闭环3.1
2026-05-10 视觉修改
2026-05-10 单色值判定
2026-05-10 双色值判定
2026-05-10 小车坐标与地图绑定
2026-05-11 位置闭环3.2
2026-05-13 重构工程（需要测试）
2026-05-16 修复不知名bug
2026-05-18 视觉更新0版
2026-05-18 视觉更新1.0(RGB->LAB)
2026-05-18 视觉更新1.1（空间特征约束+时域滤波）
2026-05-18 视觉更新1.2
2026-05-18 视觉识别1.3
2026-05-21 视觉和算法修正
2026-05-22 定点移动
2026-05-23 静态地图求解
2026-05-23 拆分main，算法优化
2026-05-24 部分项目重构，添加测试，添加说明文件
2026-06-02 逻辑解读和修改
2026-06-02 静态验证
2026-06-02 位置环角度环参数精简
2026-06-04 视觉地图识别代码重构
2026-06-04 模型识别第一版
2026-06-05 曝光修改
2026-06-08 算法修改
2026-06-10 分类数据传输
2026-06-10 小车坐标修改
2026-06-14 算法优化
2026-06-14 地图大小修改,参数修改
2026-06-14 调试，静态验证
2026-06-15 地图识别重构+模型训练完稿
2026-06-18 主函数状态机增加
2026-06-21 对地图识别进行了一个小的修改
2026-06-26 硬件契约层搭建
2026-06-26 参数整理
2026-06-27 （拉代码）
2026-06-30 逻辑修改
2026-06-30 第一关逻辑修改
2026-06-30 yaw角度修正
2026-06-30 回退修改，增加yaw回正
2026-06-30 串级pi角度环
2026-06-30 修正观察转向90度方向
2026-06-30 参数修改
2026-06-30 优化识别巡航访问顺序
2026-06-30 查看箱子图案算法
2026-06-30 bug修改
2026-07-15 优化推箱算法、自主识别流程与底盘坐标控制
2026-07-19 更新左侧发车与地图刷新流程
2026-07-19 忽略本地配置与Python缓存
2026-07-19 基于Apriltag码的四角定位
2026-07-19 优化视觉识别、求解与底盘调试稳定性
2026-07-19 完善 GAME 模式安全恢复与设备初始化
    断链恢复后等待稳定新地图并重新规划。
    修正物理场地越界判定与 IMU 标定周期。
    调整 IPS200 背光和复位时序并补充修改总结。
    [chassis_imu.c, chassis_zone.c]
2026-07-20 优化推箱子算法与正式游戏流程
2026-07-20 docs: define chassis config source of truth
2026-07-20 docs: design terminal yaw settling
2026-07-20 docs: design single-pass chassis arrival
2026-07-20 视觉标定
2026-07-21 xy单独pid参数
2026-07-21 基准定位
2026-07-21 非线性畸变补偿
2026-07-21 整合求解与正式比赛控制调整
2026-07-21 关闭车载无线调试串口
2026-07-21 单轮参数修改，引入旋转bug
2026-07-22 备份: 解算与算法时间优化修改 (app_game_logic.c 与 main copy.py 已丢失)
2026-07-26 第一关可完赛
2026-07-26 第二关半完赛
2026-07-26 合入最新底盘角度限速与调参文件
2026-07-26 前两关完赛
2026-07-26 边跑边结算
2026-07-27 识别链路增加置信率并移除往返重试
2026-07-27 第二三关支持部分匹配重识别
2026-07-27 剩余单箱单目标跳过类别识别
2026-07-27 第二三关推完后复核剩余地图
2026-07-27 空白或非法复核地图立即完成关卡
2026-07-27 修复第三关爆破后规划停滞
2026-07-27 第一关推箱完成后复核地图
2026-07-27 合入定点导航路线与底盘调参
2026-07-27 爆破复扫保留箱子类别映射
2026-07-28 调整首次贴边发车位并启用比赛模式
2026-07-28 角度修正
2026-07-29 调整比赛发车点至(2,5)
2026-07-29 单侧推第二关
2026-07-29 可能解决了超调
2026-07-29 第二关修改
2026-10-08 21届智能车人工智能视觉组
2026-10-08 工程精简 移除旧业务与菜单，保留原 main
    以原本地工程 780b9e8 为基线，删除已批准的推箱子工具、业务模块、菜单和旧资料。main.c 已按用户要求完整恢复，23 个底盘与硬件配置文件保持原样。当前为待重建快照：原 main 仍引用已删除模块，暂不能直接编译。
2026-10-19 工程文档 清理底盘评审中的失效引用
    删除已不存在的视觉位姿融合实现说明.md 两处链接，以及已移除的 pc_sokoban 校验脚本说明；仅文档变更，未改控制代码。验证：全仓相对链接扫描 0 个缺失目标。
2026-10-19 工程文档 同步工程精简与吸盘模式4说明
    新增赛规与任务交接、吸盘模式4接线与测试文档，以及 docs/hardware 主板接口与实物丝印标注图；PROJECT/README/PINOUT 与 HecateFlow 清单同步模式4入口、PWM1_SM3 与 C15 占用；规则与编码规范仅行尾归一为 LF，无内容变化。验证：相对链接扫描 0 缺失；未改代码。
2026-10-19 吸盘测试 新增模式4并精简主入口
    main.c 移除旧推箱与视觉业务入口，保留模式1/2/3并把模式4设为默认；5ms 节拍、29 个航点与底盘参数不变。新增 app_suction_test/drv_suction/configSuction 与 D0/D1/C15 映射：C15 按住吸附、松手泄压2秒后关阀。IAR/MDK 登记新增源文件，tests/suction 为主机行为测试。验证：IAR nor_sdram_zf_dtcm 编译链接通过、MSVC 测试 19 用例 205 断言 0 失败；未烧录，未实测波形与气路。
2026-10-19 构建工程 补齐MDK底盘源文件登记
    按 IAR code 组对齐，登记 app_link 与 chassis_* 共 9 组头文件/源文件；MDK 5.43 (AC6) 完整构建首次通过，0 error，仅 2 条 SDK fsl_debug_console 无穷大浮点告警；镜像布局与 IAR nor_sdram_zf_dtcm 一致（代码 0x70000000、RW 0x20000000、SDRAM 代码 0x80000000）。
2026-10-19 底盘PID 修正调试打印的空表达式告警
    DEBUG_UART_ENABLE=0 时 printf 被展开为 (0)，IAR 报 Pe174 expression has no effect；改为 ((void)0)，与 main.c 的写法一致，行为不变。验证：IAR nor_sdram_zf_dtcm 重建 0 error 0 warning；MDK 重建 0 error（仅 SDK 2 条浮点告警）。
2026-10-19 工程流程 建立Git提交流程与本地资料忽略规则
    新增 docs/Git提交流程.md：授权边界、只暂存本次文件、{模块} {动作/说明} 消息格式、提交前验证与检查清单；AGENTS/CLAUDE 加入 Git 留痕要求并保持镜像；README/PROJECT 补文档索引；.gitignore 增加 MDK 产物与 75MB 本地参考资料；交接文档记录本次提交批次。验证：相对链接扫描 0 缺失。
2026-10-19 工程文档 更新MDK构建与告警状态
    README/PROJECT/PINOUT/吸盘接线文档不再写“MDK 未验证完整构建”“底盘源文件登记缺失”“chassis_pid 告警未修”，改记 2026-10-19 的 MDK 完整构建与 IAR 0 warning 结果；PINOUT 说明改动已本地提交、未推送。仅文档变更。
2026-10-19 工程流程 忽略IAR生成的ninja清单
    IAR 9.2 构建会在配置目录生成 build_ide.ninja，属构建产物；补充忽略规则，避免每次构建后工作区出现未跟踪文件。
2026-10-19 工程流程 更新提交流程约定与信息模板
    背景：用户希望完成工作后直接让助手提交，并要求命名规范、便于溯源。
    改动：docs/Git提交流程.md 升级 v1.1，新增触发授权、模块/动作词表、正文五段、自主执行与汇报表；新增 .gitmessage 模板；AGENTS/CLAUDE 同步约定并设置 commit.template。
    验证：相对链接扫描 0 缺失；git config commit.template 指向 .gitmessage。
    风险：模板只影响手动 git commit；助手提交仍由命令行参数写入，需人工核对首行格式。
    关联：docs/Git提交流程.md、.gitmessage
2026-10-19 工程文档 补充提交检索与追溯示例
    背景：命名规范的目的之一是快速定位历史改动，需要给出可直接执行的检索方式。
    改动：docs/Git提交流程.md 增加 2.4 节，给出按模块前缀、任务编号、文件追踪和单次查看的命令。
    验证：相对链接扫描 0 缺失；示例命令与现有提交格式一致。
    风险：无。
2026-10-20 视觉 新增识别与对准方案
    背景：需要用 OpenART Plus 对 3.5cm 泡沫方块做俯拍识别与固定位对准，并明确距离标定的可信做法。
    改动：新增 docs/视觉识别与对准方案.md，覆盖 130°/QVGA 像素当量、颜色与形状识别流程、目标位定义、单应标定与视差、UART 帧建议、底盘衔接约束和验收项。
    验证：相对链接扫描 0 缺失；底盘到位窗口 10mm 与保持退出 50mm 已按当前 configChassis.h 复核。
    风险：相机高度、方块颜色清单、UART 端口与最终精度仍为待确认项；未做实机验证。
    关联：vision/main.py、project/code/config/configChassis.h
2026-10-20 视觉 新增中心标定与实时追踪脚本
    背景：先做最小验证——物块在画面中心标定一次，之后实时输出相对标定中心的像素距离，不接 UART 与毫米标定。
    改动：新增 vision/main.py：自动学习 LAB 阈值并锁定中心，亚像素质心追踪，屏幕显示 dx/dy/距离，串口输出 CSV；新增 vision/README.md：90°/130° 选型、运行步骤、参数与排错。
    验证：py -3 -m py_compile 通过；相对链接扫描 0 缺失；未在 OpenART Plus 实机运行。
    风险：实机 OpenMV 接口与阈值范围待验证；低饱和颜色（白/黑/灰）不适用。
    关联：docs/视觉识别与对准方案.md
2026-10-21 舵机测试 新增模式5与官方脉宽映射
    背景：需要台架验证 BDS300 的 P16/C30、300Hz、75–105° 往返，并把脉宽映射统一到官方例程公式。
    改动：新增 drv_servo/app_servo_test/configServo 与 pinMap 通道；main.c 增加模式5并设为默认；IAR/MDK 登记；tests/servo 主机行为测试；PROJECT/README/PINOUT 与 Q-01 同步；流程文档补充舵机测试模块词。
    验证：IAR 0 error 0 warning；MDK 0 error（2 条 SDK fsl_debug_console 浮点告警）；舵机主机测试 8 用例 18 断言 0 失败。
    风险：未做实物角度与堵转验证；官方公式在 0°/180° 端点为 0.5/2.5ms，超出资料 1–2ms，全行程需空载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
2026-10-21 工程文档 记录舵机接口方案A
    背景：吸盘占用 P17/P18 两个舵机口，需要为升降机构预留接口，先记录方案不实施。
    改动：新增 docs/舵机接口方案A.md：现状、阀信号改 D16 的接线与固件清单、风险、实施检查清单；全文标明未实施。
    验证：相对链接扫描 0 缺失；未改代码、未改接线。
    风险：D16 与无线 UART 冲突；VCC_Servo 共用电流待核算；实施前需用户确认接线。
    关联：docs/PINOUT.md、project/code/config/pinMap.h
2026-10-21 工程流程 记录换引脚误判教训
    背景：C30 不转排查中，把烧录产物/接线未同步误判为硬件故障，需要可复用的教训记录。
    改动：按 hf-lessons 模板新增 .hecateflow/lessons/INDEX.md 与 stale-flash-after-pin-change.md，记录症状、根因、证据与规避动作。
    验证：索引相对链接可解析；清单已声明 lessons 路径，无需改 manifest。
    风险：教训为项目级记录，不自动升级为规则；旧产物与接线未同步两者仍未区分。
    关联：hf-lessons、docs/PINOUT.md、project/code/config/pinMap.h
2026-10-28 舵机测试 适配FS5323M并改为上电单周期
    背景：台架舵机换为 FeETech FS5323M（4.8–6V、500–2500µs、180°）；实测 50Hz 不转、300Hz 可转，需要同步参数与模式 6 行为。
    改动：configServo 改为 FS5323M/300Hz；servo_init 增加起始角参数；新增 app_servo_sequence（上电 90→0→180→90，每步 1.5s，无按键）；模式 6 设为默认；删除按键去抖与 GPIO 桩；IAR/MDK 登记；测试与文档同步。
    验证：IAR 0 error 0 warning；MDK 0 error 0 warning；模式 5 主机测试 8 用例 18 断言；模式 6 序列测试 6 用例 23 断言；均 0 失败。
    风险：300Hz 未在厂家参数表中给出刷新率，长时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
2026-11-05 底盘控制 新增存放区航点导航模式7与8
    背景：地图标注右下角存放区 5 个停顿点（x=-0.2/0/0.2 m，y=0.475–2.275 m）；单轮调试与到位判定也需要同步现场参数。
    改动：新增模式 7/8，共用同一状态机；起点 (0,0)、车头 +y，move_to_m_direct 直线斜向，航点 x 按实车极性取反；模式 7 停 1s，模式 8 停 0.3s，默认 8。单段 6s 未判到达且已在目标 6cm 内则强制进入停顿，12s 未接近则停车。到位位置窗 0.010→0.030m；新增航向到位容差 CHASSIS_YAW_ARRIVAL_TOL_DEG=1.5°，避免 IMU 零偏/齿隙卡住到位。单轮调试轮改为 RB，目标 0.10m/s。
    验证：IAR 模式 7、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
2026-11-11 工程流程 补齐升降测试模块词
    背景：新增升降步进机构的台架测试，现有模块词表没有对应前缀，无法按模块检索。
    改动：docs/Git提交流程.md 模块词表增加“升降测试”，仅文档变更。
    验证：未跑构建，仅文档变更。
    关联：docs/升降步进模式9接线与测试.md
    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
2026-11-11 升降测试 新增步进驱动与模式9
    背景：升降机构采用 FSK30 丝杆模组（导程 12 mm）加 STEP/DIR 步进驱动器，需要独立台架测试回原点、点动与步数标定。
    改动：新增 drv_stepper（GPT1 比较中断翻转 D12 产生脉冲，D13 方向，D4 限位，朝开关运动触发即停）、stepper_profile.h（逐步梯形加减速）、app_stepper_test（回原点、K1/K2 点动 10 mm、K3 回原点、K4 急停、软件行程 1–40 mm）、configStepper.h；pinMap.h 登记 D12/D13/D4；isr.c 增加 GPT1_IRQHandler 与仅模式 9 使用的 PIT_CH2 节拍分支；main.c 新增模式 9 并设为默认，模式 9 跳过底盘/IMU 初始化、不启动 PIT_C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
2026-11-11 工程流程 记录步进驱动排查教训
    背景：升降步进首次上电依次出现欠压叫声、模式 9 无反应、驱动板不响应脉冲，排查过程需要留存供后续复用。
    改动：新增 .hecateflow/lessons/stepper-driver-supply-and-pulse.md，INDEX.md 登记该条目，仅文档变更。
    验证：未跑构建，仅文档变更；记录数据均来自本次实测（Vref 2.13 V 时 12 V 被拉到 6 V，空载 0.012 A，Vref 1.15 V 时 0.28 A，两相电压不随脉冲变化）。
    风险：新驱动器下的整机运动尚未验证，教训中的结论仅适用于本次 RMN28 现象。
    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
